praveen034u/SWAFarm/pcb-workflow.md

Requirements

↓

Schematic

↓

Assign Footprints

↓

Electrical Rule Check (ERC)

↓

PCB Layout

↓

Routing

↓

Design Rule Check (DRC)

↓

3D View

↓

Gerber Files

↓

Manufacturing

Things to Learn-
Symbol Library

Footprint Library

Properties

Wire Tool

Power Symbols

ERC

PCB Router

DRC
