praveen034u/SWAFarm/Hardware/SWAFarmNodeV1/report.txt

Info: Processing symbol 'CMC_RS485_1:Inductor_SMD:L_CommonModeChoke_Bourns_SRF1260'.
Info: Processing symbol 'CMC_RS485_2:Inductor_SMD:L_CommonModeChoke_Bourns_SRF1260'.
Info: Processing symbol 'C_BOOT1:Capacitor_SMD:C_0603_1608Metric'.
Info: Processing symbol 'C_BOOT2:Capacitor_SMD:C_0603_1608Metric'.
Info: Processing symbol 'C_BULK2:Capacitor_SMD:C_1206_3216Metric'.
Info: Processing symbol 'C_COMP1:Capacitor_SMD:C_0603_1608Metric'.
Info: Processing symbol 'C_DEC1:Capacitor_SMD:C_0603_1608Metric'.
Info: Processing symbol 'C_DEC2:Capacitor_SMD:C_0603_1608Metric'.
Info: Processing symbol 'C_DEC3:Capacitor_SMD:C_0603_1608Metric'.
Info: Processing symbol 'C_DEC4:Capacitor_SMD:C_0603_1608Metric'.
Info: Processing symbol 'C_DEC5:Capacitor_SMD:C_0603_1608Metric'.
Info: Processing symbol 'C_DEC6:Capacitor_SMD:C_0603_1608Metric'.
Info: Processing symbol 'C_DEC7:Capacitor_SMD:C_0603_1608Metric'.
Info: Processing symbol 'C_DEC8:Capacitor_SMD:C_0603_1608Metric'.
Info: Processing symbol 'C_DEC9:Capacitor_SMD:C_0603_1608Metric'.
Info: Processing symbol 'C_DEC10:Capacitor_SMD:C_0603_1608Metric'.
Info: Processing symbol 'C_DVDT1:Capacitor_SMD:C_0805_2012Metric'.
Info: Processing symbol 'C_EN1:Capacitor_SMD:C_0805_2012Metric'.
Info: Processing symbol 'C_FILT1:Capacitor_SMD:C_0603_1608Metric'.
Info: Processing symbol 'C_FILT2:Capacitor_SMD:C_0603_1608Metric'.
Info: Processing symbol 'C_FILT3:Capacitor_SMD:C_0603_1608Metric'.
Info: Processing symbol 'C_FILT4:Capacitor_SMD:C_0603_1608Metric'.
Info: Processing symbol 'C_FILT5:Capacitor_SMD:C_0603_1608Metric'.
Info: Processing symbol 'C_FILT6:Capacitor_SMD:C_0603_1608Metric'.
Info: Processing symbol 'C_IN1:Capacitor_SMD:C_1206_3216Metric'.
Info: Processing symbol 'C_IN2:Capacitor_SMD:C_1206_3216Metric'.
Info: Processing symbol 'C_IN3:Capacitor_SMD:C_1206_3216Metric'.
Info: Processing symbol 'C_ISOIN1:Capacitor_SMD:C_0603_1608Metric'.
Info: Processing symbol 'C_ISOOUT1:Capacitor_SMD:C_0603_1608Metric'.
Info: Processing symbol 'C_OUT1:Capacitor_SMD:C_1206_3216Metric'.
Info: Processing symbol 'C_OUT2:Capacitor_SMD:C_1206_3216Metric'.
Info: Processing symbol 'C_OUT3:Capacitor_SMD:C_1206_3216Metric'.
Info: Processing symbol 'C_SS1:Capacitor_SMD:C_0603_1608Metric'.
Info: Processing symbol 'C_VALVEBULK1:Capacitor_THT:CP_Radial_D12.5mm_P5.00mm'.
Info: Processing symbol 'C_VMDEC1:Capacitor_SMD:C_0805_2012Metric'.
Info: Processing symbol 'C_VMDEC2:Capacitor_SMD:C_0805_2012Metric'.
Info: Processing symbol 'C_VMDEC3:Capacitor_SMD:C_0805_2012Metric'.
Info: Processing symbol 'C_VMDEC4:Capacitor_SMD:C_0805_2012Metric'.
Info: Processing symbol 'C_VMDEC5:Capacitor_SMD:C_0805_2012Metric'.
Info: Processing symbol 'C_VMDEC6:Capacitor_SMD:C_0805_2012Metric'.
Info: Processing symbol 'D1:Diode_SMD:D_SMB'.
Info: Processing symbol 'D_CLHI1:Diode_SMD:D_SOD-123'.
Info: Processing symbol 'D_CLHI2:Diode_SMD:D_SOD-123'.
Info: Processing symbol 'D_CLHI3:Diode_SMD:D_SOD-123'.
Info: Processing symbol 'D_CLHI4:Diode_SMD:D_SOD-123'.
Info: Processing symbol 'D_CLHI5:Diode_SMD:D_SOD-123'.
Info: Processing symbol 'D_CLHI6:Diode_SMD:D_SOD-123'.
Info: Processing symbol 'D_CLLO1:Diode_SMD:D_SOD-123'.
Info: Processing symbol 'D_CLLO2:Diode_SMD:D_SOD-123'.
Info: Processing symbol 'D_CLLO3:Diode_SMD:D_SOD-123'.
Info: Processing symbol 'D_CLLO4:Diode_SMD:D_SOD-123'.
Info: Processing symbol 'D_CLLO5:Diode_SMD:D_SOD-123'.
Info: Processing symbol 'D_CLLO6:Diode_SMD:D_SOD-123'.
Info: Processing symbol 'D_FLT1:LED_SMD:LED_0805_2012Metric'.
Info: Processing symbol 'D_LED1:LED_SMD:LED_0805_2012Metric'.
Info: Processing symbol 'D_LED2:LED_SMD:LED_0805_2012Metric'.
Info: Processing symbol 'D_LINK1:LED_SMD:LED_0805_2012Metric'.
Info: Processing symbol 'D_PWR1:LED_SMD:LED_0805_2012Metric'.
Info: Processing symbol 'D_RS485PROT1:Package_TO_SOT_SMD:SOT-23'.
Info: Processing symbol 'D_RS485PROT2:Package_TO_SOT_SMD:SOT-23'.
Info: Processing symbol 'F1:Fuse:Fuse_1812_4532Metric'.
Info: Processing symbol 'J1:Connector_PinHeader_2.54mm:PinHeader_1x04_P2.54mm_Vertical'.
Info: Processing symbol 'J_LORASMA1:Connector_Coaxial:SMA_Amphenol_132134_Vertical'.
Info: Processing symbol 'J_OUT1:Connector_PinHeader_2.54mm:PinHeader_1x04_P2.54mm_Vertical'.
Info: Processing symbol 'J_PROG1:Connector_PinHeader_2.54mm:PinHeader_1x03_P2.54mm_Vertical'.
Info: Processing symbol 'J_RS485_IN1:Connector_PinHeader_2.54mm:PinHeader_1x05_P2.54mm_Vertical'.
Info: Processing symbol 'J_RS485_LOC1:Connector_PinHeader_2.54mm:PinHeader_1x05_P2.54mm_Vertical'.
Info: Processing symbol 'J_RS485_OUT1:Connector_PinHeader_2.54mm:PinHeader_1x05_P2.54mm_Vertical'.
Info: Processing symbol 'J_SENSOR_RET1:TerminalBlock_Phoenix:TerminalBlock_Phoenix_MKDS-1,5-6-5.08_1x06_P5.08mm_Horizontal'.
Info: Processing symbol 'J_SENSOR_SIG1:TerminalBlock_Phoenix:TerminalBlock_Phoenix_MKDS-1,5-6-5.08_1x06_P5.08mm_Horizontal'.
Info: Processing symbol 'J_USB1:Connector_USB:USB_C_Receptacle_HRO_TYPE-C-31-M-12'.
Info: Processing symbol 'J_VALVE_OUT1_1:TerminalBlock_Phoenix:TerminalBlock_Phoenix_MKDS-1,5-6-5.08_1x06_P5.08mm_Horizontal'.
Info: Processing symbol 'J_VALVE_OUT2_1:TerminalBlock_Phoenix:TerminalBlock_Phoenix_MKDS-1,5-6-5.08_1x06_P5.08mm_Horizontal'.
Info: Processing symbol 'L1:Inductor_SMD:L_Bourns-SRN6028'.
Info: Processing symbol 'L2:Inductor_SMD:L_Bourns-SRN4018'.
Info: Processing symbol 'Q1:Package_TO_SOT_SMD:SOT-23'.
Info: Processing symbol 'R_BIASA1:Resistor_SMD:R_0805_2012Metric'.
Info: Processing symbol 'R_BIASB1:Resistor_SMD:R_0805_2012Metric'.
Info: Processing symbol 'R_BOOT1:Resistor_SMD:R_0805_2012Metric'.
Info: Processing symbol 'R_BURDEN1:Resistor_SMD:R_0805_2012Metric'.
Info: Processing symbol 'R_BURDEN2:Resistor_SMD:R_0805_2012Metric'.
Info: Processing symbol 'R_BURDEN3:Resistor_SMD:R_0805_2012Metric'.
Info: Processing symbol 'R_BURDEN4:Resistor_SMD:R_0805_2012Metric'.
Info: Processing symbol 'R_BURDEN5:Resistor_SMD:R_0805_2012Metric'.
Info: Processing symbol 'R_BURDEN6:Resistor_SMD:R_0805_2012Metric'.
Info: Processing symbol 'R_CC1_1:Resistor_SMD:R_0805_2012Metric'.
Info: Processing symbol 'R_CC2_1:Resistor_SMD:R_0805_2012Metric'.
Info: Processing symbol 'R_COMP1:Resistor_SMD:R_0805_2012Metric'.
Info: Processing symbol 'R_EN1A1:Resistor_SMD:R_0805_2012Metric'.
Info: Processing symbol 'R_EN1B1:Resistor_SMD:R_0805_2012Metric'.
Info: Processing symbol 'R_EN2:Resistor_SMD:R_0805_2012Metric'.
Info: Processing symbol 'R_ENPU1:Resistor_SMD:R_0805_2012Metric'.
Info: Processing symbol 'R_EXPRST1:Resistor_SMD:R_0805_2012Metric'.
Info: Processing symbol 'R_FB1A1:Resistor_SMD:R_0805_2012Metric'.
Info: Processing symbol 'R_FB1B1:Resistor_SMD:R_0805_2012Metric'.
Info: Processing symbol 'R_FB2A1:Resistor_SMD:R_0805_2012Metric'.
Info: Processing symbol 'R_FB2B1:Resistor_SMD:R_0805_2012Metric'.
Info: Processing symbol 'R_FLT1:Resistor_SMD:R_0805_2012Metric'.
Info: Processing symbol 'R_gate1:Resistor_SMD:R_0805_2012Metric'.
Info: Processing symbol 'R_ILIM1:Resistor_SMD:R_0805_2012Metric'.
Info: Processing symbol 'R_ILIM_V1:Resistor_SMD:R_0805_2012Metric'.
Info: Processing symbol 'R_ILIM_V2:Resistor_SMD:R_0805_2012Metric'.
Info: Processing symbol 'R_ILIM_V3:Resistor_SMD:R_0805_2012Metric'.
Info: Processing symbol 'R_ILIM_V4:Resistor_SMD:R_0805_2012Metric'.
Info: Processing symbol 'R_ILIM_V5:Resistor_SMD:R_0805_2012Metric'.
Info: Processing symbol 'R_ILIM_V6:Resistor_SMD:R_0805_2012Metric'.
Info: Processing symbol 'R_IMON1:Resistor_SMD:R_0805_2012Metric'.
Info: Processing symbol 'R_LED1:Resistor_SMD:R_0805_2012Metric'.
Info: Processing symbol 'R_LED2:Resistor_SMD:R_0805_2012Metric'.
Info: Processing symbol 'R_LEDFLT1:Resistor_SMD:R_0805_2012Metric'.
Info: Processing symbol 'R_LINK1:Resistor_SMD:R_0805_2012Metric'.
Info: Processing symbol 'R_LORABOOT1:Resistor_SMD:R_0805_2012Metric'.
Info: Processing symbol 'R_LORARST1:Resistor_SMD:R_0805_2012Metric'.
Info: Processing symbol 'R_OVP1:Resistor_SMD:R_0805_2012Metric'.
Info: Processing symbol 'R_OVP2:Resistor_SMD:R_0805_2012Metric'.
Info: Processing symbol 'R_PG1:Resistor_SMD:R_0805_2012Metric'.
Info: Processing symbol 'R_PWR1:Resistor_SMD:R_0805_2012Metric'.
Info: Processing symbol 'R_RT1:Resistor_SMD:R_0805_2012Metric'.
Info: Processing symbol 'R_SER1:Resistor_SMD:R_0805_2012Metric'.
Info: Processing symbol 'R_SER2:Resistor_SMD:R_0805_2012Metric'.
Info: Processing symbol 'R_SER3:Resistor_SMD:R_0805_2012Metric'.
Info: Processing symbol 'R_SER4:Resistor_SMD:R_0805_2012Metric'.
Info: Processing symbol 'R_SER5:Resistor_SMD:R_0805_2012Metric'.
Info: Processing symbol 'R_SER6:Resistor_SMD:R_0805_2012Metric'.
Info: Processing symbol 'R_SETUP1:Resistor_SMD:R_0805_2012Metric'.
Info: Processing symbol 'R_SHDN1:Resistor_SMD:R_0805_2012Metric'.
Info: Processing symbol 'R_TERM1:Resistor_SMD:R_0805_2012Metric'.
Info: Processing symbol 'R_UVLO1:Resistor_SMD:R_0805_2012Metric'.
Info: Processing symbol 'R_UVLO2:Resistor_SMD:R_0805_2012Metric'.
Info: Processing symbol 'SW_BOOT1:Button_Switch_SMD:SW_SPST_B3U-1000P'.
Info: Processing symbol 'SW_RESET1:Button_Switch_SMD:SW_SPST_B3U-1000P'.
Info: Processing symbol 'SW_SETUP1:Button_Switch_SMD:SW_SPST_B3U-1000P'.
Info: Processing symbol 'TP_3V3:TestPoint:TestPoint_Pad_D1.5mm'.
Info: Processing symbol 'TP_5V1:TestPoint:TestPoint_Pad_D1.5mm'.
Info: Processing symbol 'TP_12V_SW1:TestPoint:TestPoint_Pad_D1.5mm'.
Info: Processing symbol 'TP_FLT1:TestPoint:TestPoint_Pad_D1.5mm'.
Info: Processing symbol 'TP_GND1:TestPoint:TestPoint_Pad_D1.5mm'.
Info: Processing symbol 'TP_IMON1:TestPoint:TestPoint_Pad_D1.5mm'.
Info: Processing symbol 'TP_ISO5V1:TestPoint:TestPoint_Pad_D1.5mm'.
Info: Processing symbol 'TP_ISOGND1:TestPoint:TestPoint_Pad_D1.5mm'.
Info: Processing symbol 'TP_LORABOOT1:TestPoint:TestPoint_Pad_D1.5mm'.
Info: Processing symbol 'TP_LORARST1:TestPoint:TestPoint_Pad_D1.5mm'.
Info: Processing symbol 'TP_PG1:TestPoint:TestPoint_Pad_D1.5mm'.
Info: Processing symbol 'TP_RS485DI1:TestPoint:TestPoint_Pad_D1.5mm'.
Info: Processing symbol 'TP_RS485RO1:TestPoint:TestPoint_Pad_D1.5mm'.
Info: Processing symbol 'TP_USBVBUS1:TestPoint:TestPoint_Pad_D1.5mm'.
Info: Processing symbol 'U1:Package_SO:HTSSOP-16-1EP_4.4x5mm_P0.65mm_EP3.4x5mm_Mask2.66x2.46mm_ThermalVias'.
Info: Processing symbol 'U2:Package_SON:WSON-10-1EP_4x4mm_P0.8mm_EP2.6x3mm_ThermalVias'.
Info: Processing symbol 'U3:Package_TO_SOT_SMD:SOT-23-6'.
Info: Processing symbol 'U_DRV1:Package_SO:TI_SO-PowerPAD-8_ThermalVias'.
Info: Processing symbol 'U_DRV2:Package_SO:TI_SO-PowerPAD-8_ThermalVias'.
Info: Processing symbol 'U_DRV3:Package_SO:TI_SO-PowerPAD-8_ThermalVias'.
Info: Processing symbol 'U_DRV4:Package_SO:TI_SO-PowerPAD-8_ThermalVias'.
Info: Processing symbol 'U_DRV5:Package_SO:TI_SO-PowerPAD-8_ThermalVias'.
Info: Processing symbol 'U_DRV6:Package_SO:TI_SO-PowerPAD-8_ThermalVias'.
Info: Processing symbol 'U_ISO1:Package_SO:SOIC-16W_7.5x10.3mm_P1.27mm'.
Info: Processing symbol 'U_ISODCDC1:Converter_DCDC:Converter_DCDC_Murata_MEE1SxxxxSC_THT'.
Info: Processing symbol 'U_LORA1:RF_Module:RAK3172'.
Info: Processing symbol 'U_MCU1:RF_Module:ESP32-S3-WROOM-1'.
Info: Processing symbol 'U_RS485_TX1:Package_SO:SOIC-8_3.9x4.9mm_P1.27mm'.
Info: Processing symbol 'U_VALVEEXP1:Package_SO:SOIC-28W_7.5x17.9mm_P1.27mm'.

Info: Total warnings: 0, errors: 0.
