praveen034u/SWAFarm/.ai/agent_index.md

Hardware Questions

↓

hardware_architect

↓

schematic_designer

↓

pcb_layout_reviewer

↓

manufacturing_engineer

Firmware

↓

firmware_architect

Testing

↓

testing_validation

RF

↓

rf_lorawan_expert
