praveen034u/SWAFarm/Documentation/images/SWAFarmNodeV1_3DCheck.png

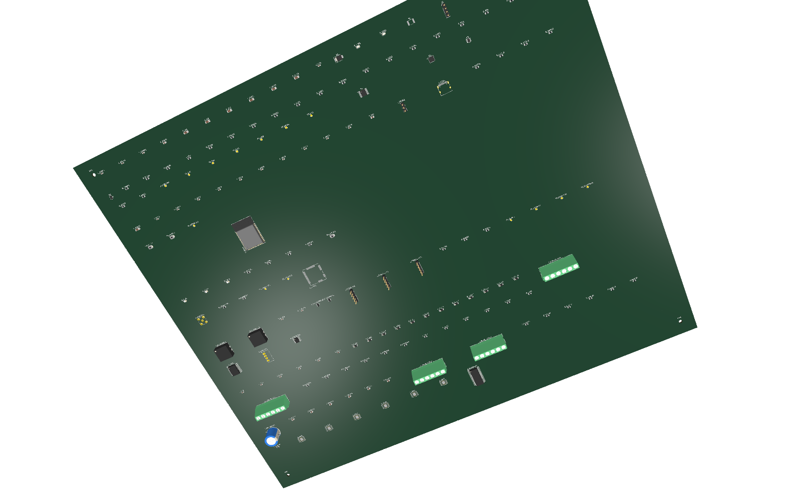
Documentation/images/SWAFarmNodeV1_3DCheck.png
