praveen034u/SWAFarm/Documentation/images/SWAFarmNodeV1_09PCB_TopView_Placement.png

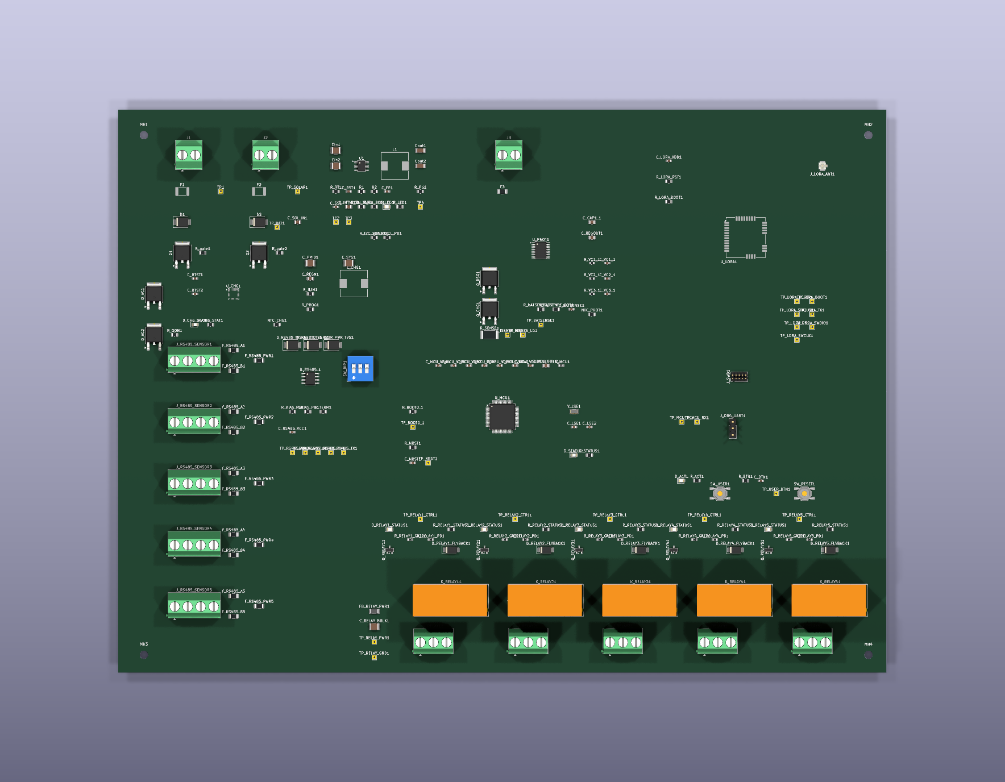
Documentation/images/SWAFarmNodeV1_09PCB_TopView_Placement.png
