praveen034u/SWAFarm/Documentation/images/SWAFarmNodeV1_NodeCore_08PCB_TopView.png

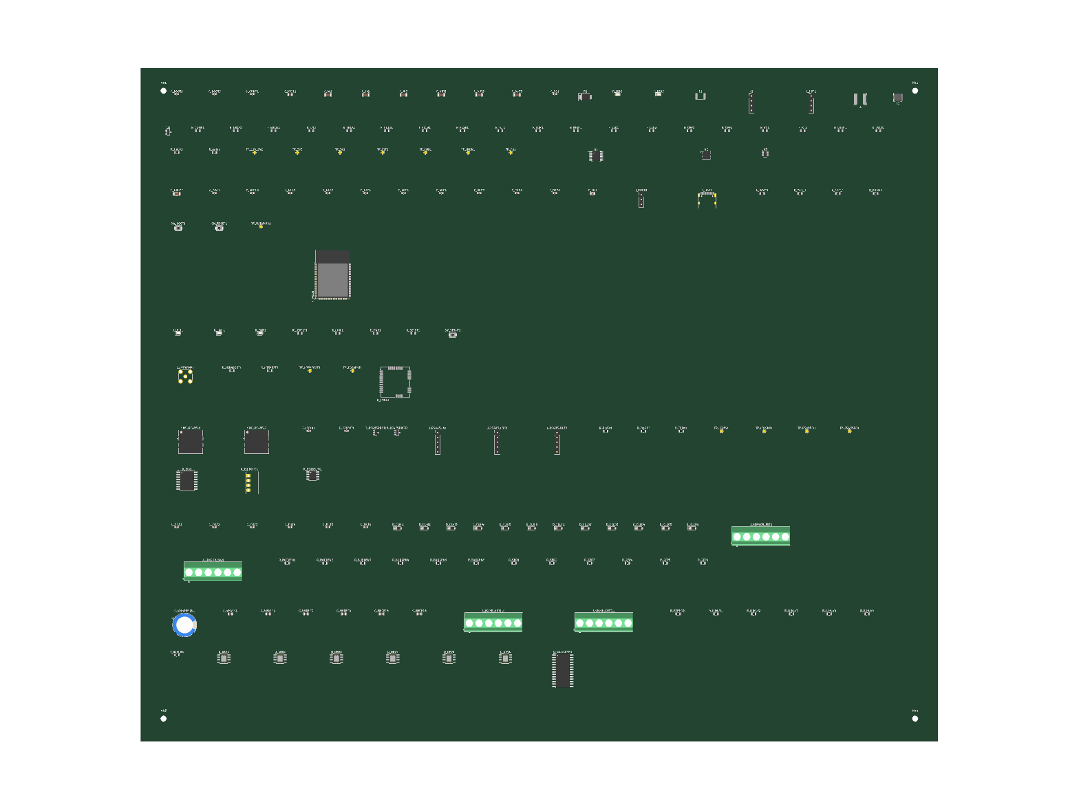
Documentation/images/SWAFarmNodeV1_NodeCore_08PCB_TopView.png
