praveen034u/SWAFarm/NodeForRefrence.xlsx

Sheet: Netlist_Seed
record_id | board_id | sheet_block | net_name | signal_direction | signal_source_component_id | source_refdes_hint | source_pin | signal_destination_component_id | destination_refdes_hint | destination_pin | connector_id | connector_pin | label_on_silkscreen | resistor_required | resistor_component_id | resistor_value_ohm | protection_required | protection_component_ids | power_circuit_stage | power_rail | required | design_status | verification_test | notes
HUB_PWR_001 | HUB_CORE | POWER_INPUT | HUB_12V_IN | in | CMP_CONN_M12A_4P_PWR12_PANEL | J_PWR_IN | Pin1 | POWER_CHAIN | U_PROT_IN | IN | CONN_M12A_4P_PWR12 | Pin1 | +12V_IN | FALSE |  |  | TRUE | CMP_INPUT_FUSE_PTC|CMP_INPUT_TVS|CMP_POLARITY_PROTECT|CMP_EFUSE_UVLO_OVP | Input protection | 12V | TRUE | LOCKED | TC-HW-001 | 12V enters via M12 power connector.
HUB_PWR_002 | HUB_CORE | POWER_INPUT | HUB_GND | in | CMP_CONN_M12A_4P_PWR12_PANEL | J_PWR_IN | Pin2 | SYSTEM_GND | GNDP | 0V | CONN_M12A_4P_PWR12 | Pin2 | GND | FALSE |  |  | TRUE | CMP_INPUT_TVS | Ground return | 0V | TRUE | LOCKED | TC-HW-001 | Power return.
HUB_PWR_003 | HUB_CORE | POWER_INPUT | HUB_PE_CHASSIS | in | CMP_CONN_M12A_4P_PWR12_PANEL | J_PWR_IN | Pin3 | CHASSIS | CHASSIS | CHASSIS | CONN_M12A_4P_PWR12 | Pin3 | PE_CHASSIS | FALSE |  |  | FALSE |  | Chassis bonding | CHASSIS | TRUE | PROVISIONAL | TC-HW-001 | Use for surge/chassis strategy as needed.
HUB_PWR_004 | HUB_CORE | POWER_INPUT | HUB_PWR_SPARE | na | CMP_CONN_M12A_4P_PWR12_PANEL | J_PWR_IN | Pin4 | NA | NA | NA | CONN_M12A_4P_PWR12 | Pin4 | SPARE | FALSE |  |  | FALSE |  | Reserved | NA | FALSE | LOCKED | TC-HW-001 | Reserved no-connect.
HUB_PWR_005 | HUB_CORE | POWER_CHAIN | HUB_12V_PROTECTED | out | CMP_EFUSE_UVLO_OVP | U_EFUSE | OUT | CMP_REGULATOR_12V_TO_5V | U_BUCK12_5 | VIN | NA | NA | 12V_PROT | FALSE |  |  | TRUE | CMP_INPUT_FUSE_PTC|CMP_INPUT_TVS|CMP_POLARITY_PROTECT|CMP_EFUSE_UVLO_OVP | Power conditioning | 12V | TRUE | LOCKED | TC-HW-001 | Main protected rail.
HUB_PWR_006 | HUB_CORE | POWER_CHAIN | HUB_5V | out | CMP_REGULATOR_12V_TO_5V | U_BUCK12_5 | VOUT | CMP_REGULATOR_5V_TO_3V3 | U_LDO5_3V3 | VIN | NA | NA | 5V | FALSE |  |  | FALSE |  | Buck stage | 5V | TRUE | LOCKED | TC-HW-001 | 5V intermediate rail.
HUB_PWR_007 | HUB_CORE | POWER_CHAIN | HUB_3V3 | out | CMP_REGULATOR_5V_TO_3V3 | U_LDO5_3V3 | VOUT | CMP_MCU_ESP32S3 | U_MCU | VDD | NA | NA | 3V3 | FALSE |  |  | FALSE |  | Regulated rail | 3V3 | TRUE | LOCKED | TC-HW-001 | Digital rail.
HUB_RS485_001 | HUB_CORE | RS485 | HUB_RS485_A_IN | in | CMP_CONN_M12A_5P_RS485_PANEL | J_RS485_IN | Pin2 | CMP_RS485_LINE_PROTECT | U_RS485_PROT_IN | A | CONN_M12A_5P_RS485 | Pin2 | RS485_A_IN | TRUE | CMP_RS485_TERM_SELECT | 120 | TRUE | CMP_RS485_LINE_PROTECT|CMP_RS485_ISOLATOR|CMP_RS485_ISO_DCDC | Bus input | RS485 | TRUE | LOCKED | TC-HW-004 | Pin map provisional: Pin1 GND Pin2 A Pin3 B Pin4 NC Pin5 SHIELD.
HUB_RS485_002 | HUB_CORE | RS485 | HUB_RS485_B_IN | in | CMP_CONN_M12A_5P_RS485_PANEL | J_RS485_IN | Pin3 | CMP_RS485_LINE_PROTECT | U_RS485_PROT_IN | B | CONN_M12A_5P_RS485 | Pin3 | RS485_B_IN | TRUE | CMP_RS485_BIAS_NET | 680 | TRUE | CMP_RS485_LINE_PROTECT|CMP_RS485_ISOLATOR|CMP_RS485_ISO_DCDC | Bus input | RS485 | TRUE | LOCKED | TC-HW-004 | Bias network required.
HUB_RS485_003 | HUB_CORE | RS485 | HUB_RS485_GND | in | CMP_CONN_M12A_5P_RS485_PANEL | J_RS485_IN | Pin1 | SYSTEM_GND | GNDP | 0V | CONN_M12A_5P_RS485 | Pin1 | RS485_GND | FALSE |  |  | TRUE | CMP_RS485_CMC | Reference | 0V | TRUE | LOCKED | TC-HW-004 | Bus reference.
HUB_RS485_004 | HUB_CORE | RS485 | HUB_RS485_A_OUT | out | CMP_RS485_TRANSCEIVER | U_RS485_TX | RXTX_A | CMP_CONN_M12A_5P_RS485_PANEL | J_RS485_OUT | Pin2 | CONN_M12A_5P_RS485 | Pin2 | RS485_A_OUT | FALSE |  |  | TRUE | CMP_RS485_LINE_PROTECT | Bus output | RS485 | TRUE | LOCKED | TC-HW-004 | Daisy chain downstream.
HUB_RS485_005 | HUB_CORE | RS485 | HUB_RS485_B_OUT | out | CMP_RS485_TRANSCEIVER | U_RS485_TX | RXTX_B | CMP_CONN_M12A_5P_RS485_PANEL | J_RS485_OUT | Pin3 | CONN_M12A_5P_RS485 | Pin3 | RS485_B_OUT | FALSE |  |  | TRUE | CMP_RS485_LINE_PROTECT | Bus output | RS485 | TRUE | LOCKED | TC-HW-004 | Daisy chain downstream.
HUB_RS485_006 | HUB_CORE | RS485 | HUB_RS485_SHIELD | na | CMP_CONN_M12A_5P_RS485_PANEL | J_RS485_IN | Pin5 | CHASSIS | CHASSIS | CHASSIS | CONN_M12A_5P_RS485 | Pin5 | RS485_SHIELD | FALSE |  |  | TRUE | CMP_RS485_CMC | EMI path | CHASSIS | TRUE | PROVISIONAL | TC-HW-004 | Shield termination strategy by PCB review.
HUB_SENSOR_001 | HUB_CORE | SENSOR | HUB_SENS_CH1_SIG | in | CMP_CONN_TERM_6CH_SENSOR | J_SENSOR | CH1_SIG | CMP_SENSOR_FRONTEND_UNIVERSAL | U_AFE | CH1_IN | CONN_TERM_6CH_SENSOR | CH1_SIG | SENS1_SIG | FALSE |  |  | TRUE | CMP_ESD_ARRAY | Sensor frontend | SENSOR | TRUE | LOCKED | TC-HW-002 | Supports DI/Pulse/0-10V/4-20mA per firmware config.
HUB_SENSOR_002 | HUB_CORE | SENSOR | HUB_SENS_CH1_RET | in | CMP_CONN_TERM_6CH_SENSOR | J_SENSOR | CH1_RET | CMP_SENSOR_FRONTEND_UNIVERSAL | U_AFE | CH1_RET | CONN_TERM_6CH_SENSOR | CH1_RET | SENS1_RET | FALSE |  |  | TRUE | CMP_ESD_ARRAY | Sensor frontend | SENSOR | TRUE | LOCKED | TC-HW-002 | Return/reference.
HUB_SENSOR_003 | HUB_CORE | SENSOR | HUB_SENS_CH2_SIG | in | CMP_CONN_TERM_6CH_SENSOR | J_SENSOR | CH2_SIG | CMP_SENSOR_FRONTEND_UNIVERSAL | U_AFE | CH2_IN | CONN_TERM_6CH_SENSOR | CH2_SIG | SENS2_SIG | FALSE |  |  | TRUE | CMP_ESD_ARRAY | Sensor frontend | SENSOR | TRUE | LOCKED | TC-HW-002 | Channel 2 input.
HUB_SENSOR_004 | HUB_CORE | SENSOR | HUB_SENS_CH2_RET | in | CMP_CONN_TERM_6CH_SENSOR | J_SENSOR | CH2_RET | CMP_SENSOR_FRONTEND_UNIVERSAL | U_AFE | CH2_RET | CONN_TERM_6CH_SENSOR | CH2_RET | SENS2_RET | FALSE |  |  | TRUE | CMP_ESD_ARRAY | Sensor frontend | SENSOR | TRUE | LOCKED | TC-HW-002 | Channel 2 return.
HUB_SENSOR_005 | HUB_CORE | SENSOR | HUB_SENS_CH3_SIG | in | CMP_CONN_TERM_6CH_SENSOR | J_SENSOR | CH3_SIG | CMP_SENSOR_FRONTEND_UNIVERSAL | U_AFE | CH3_IN | CONN_TERM_6CH_SENSOR | CH3_SIG | SENS3_SIG | FALSE |  |  | TRUE | CMP_ESD_ARRAY | Sensor frontend | SENSOR | TRUE | LOCKED | TC-HW-002 | Channel 3 input.
HUB_SENSOR_006 | HUB_CORE | SENSOR | HUB_SENS_CH3_RET | in | CMP_CONN_TERM_6CH_SENSOR | J_SENSOR | CH3_RET | CMP_SENSOR_FRONTEND_UNIVERSAL | U_AFE | CH3_RET | CONN_TERM_6CH_SENSOR | CH3_RET | SENS3_RET | FALSE |  |  | TRUE | CMP_ESD_ARRAY | Sensor frontend | SENSOR | TRUE | LOCKED | TC-HW-002 | Channel 3 return.
HUB_SENSOR_007 | HUB_CORE | SENSOR | HUB_SENS_CH4_SIG | in | CMP_CONN_TERM_6CH_SENSOR | J_SENSOR | CH4_SIG | CMP_SENSOR_FRONTEND_UNIVERSAL | U_AFE | CH4_IN | CONN_TERM_6CH_SENSOR | CH4_SIG | SENS4_SIG | FALSE |  |  | TRUE | CMP_ESD_ARRAY | Sensor frontend | SENSOR | TRUE | LOCKED | TC-HW-002 | Channel 4 input.
HUB_SENSOR_008 | HUB_CORE | SENSOR | HUB_SENS_CH4_RET | in | CMP_CONN_TERM_6CH_SENSOR | J_SENSOR | CH4_RET | CMP_SENSOR_FRONTEND_UNIVERSAL | U_AFE | CH4_RET | CONN_TERM_6CH_SENSOR | CH4_RET | SENS4_RET | FALSE |  |  | TRUE | CMP_ESD_ARRAY | Sensor frontend | SENSOR | TRUE | LOCKED | TC-HW-002 | Channel 4 return.
HUB_SENSOR_009 | HUB_CORE | SENSOR | HUB_SENS_CH5_SIG | in | CMP_CONN_TERM_6CH_SENSOR | J_SENSOR | CH5_SIG | CMP_SENSOR_FRONTEND_UNIVERSAL | U_AFE | CH5_IN | CONN_TERM_6CH_SENSOR | CH5_SIG | SENS5_SIG | FALSE |  |  | TRUE | CMP_ESD_ARRAY | Sensor frontend | SENSOR | TRUE | LOCKED | TC-HW-002 | Channel 5 input.
HUB_SENSOR_010 | HUB_CORE | SENSOR | HUB_SENS_CH5_RET | in | CMP_CONN_TERM_6CH_SENSOR | J_SENSOR | CH5_RET | CMP_SENSOR_FRONTEND_UNIVERSAL | U_AFE | CH5_RET | CONN_TERM_6CH_SENSOR | CH5_RET | SENS5_RET | FALSE |  |  | TRUE | CMP_ESD_ARRAY | Sensor frontend | SENSOR | TRUE | LOCKED | TC-HW-002 | Channel 5 return.

Sheet: BOM
device_id | component_id | category | description | selection_notes | sourcing_india | sourcing_us | cost_class | criticality | quantity | lifecycle_status | manufacturer | mpn | india_alt_mfr_pn | india_alt_mfr | india_sourcing_note
NODE_CORE | CMP_MCU_ESP32S3 | MCU | Primary MCU with integrated Wi-Fi and BLE radios | Use MCU variant with stable supply in India and long-term availability; Wi-Fi and BLE are integrated in this component. | Mouser India; element14 India; local authorized distributor | Mouser US; Digi-Key US; Arrow US | high | mandatory | 1 | approved | Espressif | ESP32-S3-WROOM-1-N16R8 |  |  | Order via Espressif India / Mouser India / DigiKey India; module sourced directly from Espressif or authorized distributor
NODE_CORE | CMP_RS485_TRANSCEIVER | COMMUNICATION | RS-485 transceiver | Prefer half-duplex 3.3V transceiver with ESD robustness and fail-safe receiver for long cable runs. | Mouser India; element14 India; local authorized distributor | Mouser US; Digi-Key US; Arrow US | medium | mandatory | 2 | approved | Texas Instruments | THVD1450DR
NODE_CORE | CMP_REGULATOR_12V_TO_5V | POWER | Primary buck regulator | Prefer automotive/industrial-grade buck with wide input tolerance, low heat, and short-circuit protection. | Mouser India; element14 India; local authorized distributor | Mouser US; Digi-Key US; Arrow US | medium | mandatory | 1 | approved | Texas Instruments | TPS54531DDAR |  |  | Monolithic Power / TI buck converters via Mouser India; verify package availability
NODE_CORE | CMP_REGULATOR_5V_TO_3V3 | POWER | Secondary 3.3V step-down (buck) regulator | Switching buck for thermal/brownout headroom under 4G TX bursts; needs 2.2uH inductor + feedback divider (add at schematic capture). | Mouser India; element14 India; local authorized distributor | Mouser US; Digi-Key US; Arrow US | medium | mandatory | 1 | approved | Texas Instruments | TPS563201DDCR |  |  | TPS563201/TPS562201 stocked by Sharvi Electronics (Bangalore) & Mouser India; MP2315/MP1584 buck options common on SP Road. Buck requires 2.2uH L + FB divider.
NODE_CORE | CMP_SENSOR_FRONTEND_UNIVERSAL | ANALOG_FRONTEND | 6-ch universal input conditioning network (per channel: 0-10V divider + RC filter + DI/pulse pull-up) | Discrete per-channel network - see SENSOR_FRONTEND_SPEC.md. Mode-select jumper picks 0-10V / 4-20mA / DI / pulse. Feeds ESP32-S3 ADC1. Divider/filter passives placed at schematic capture. | Mouser India; element14 India; local authorized distributor | Mouser US; Digi-Key US; Arrow US | medium | mandatory | 6 | approved | SWAFarms | SWA-AFE-UNI-6CH (discrete network) |  |  | Built from standard R/C; see SENSOR_FRONTEND_SPEC.md.
NODE_CORE | CMP_VALVE_DRIVER_CH | DRIVER | Full H-bridge valve driver (universal: latching + standard solenoids) | TI DRV8871 3.6A full H-bridge, 1 per valve (6/board). Bipolar drive: reverse-polarity pulse for latching solenoids (~2.5A/150ms), continuous for standard. Integrated freewheeling diodes + internal current limit + thermal shutdown. IN1/IN2 driven via SPI I/O expander. | Mouser India; element14 India; local authorized distributor | Mouser US; Digi-Key US; Arrow US | medium | mandatory | 6 | approved | Texas Instruments | DRV8871DDAR |  |  | DRV8871DDAR stocked by Mouser India / element14 / Robu.in; SOIC-8 PowerPAD.
NODE_CORE | CMP_ESD_ARRAY | PROTECTION | ESD protection array for external ports | Select low-capacitance, IEC-rated ESD array matched to exposed interface voltage levels. | Mouser India; element14 India; local authorized distributor | Mouser US; Digi-Key US; Arrow US | low | mandatory | 4 | approved | Nexperia | PESD2CANFD24VTQ
NODE_CORE | CMP_SURGE_PROTECTOR | PROTECTION | Power surge and transient protection stage | Prefer TVS/MOV network sized for field transients and long cable environments. | Mouser India; element14 India; local authorized distributor | Mouser US; Digi-Key US; Arrow US | low | mandatory | 1 | approved | Littelfuse | SMAJ24A
NODE_CORE | CMP_INPUT_FUSE_PTC | PROTECTION | Input fuse or resettable PTC stage for fault current limiting | Size for worst-case inrush and field wiring faults while avoiding nuisance trips. | Mouser India; element14 India; local authorized distributor | Mouser US; Digi-Key US; Arrow US | low | mandatory | 1 | approved | Bourns | MF-R110 |  |  | Bourns/TE PTC fuses available via Mouser India or local distributors like Arrow India
NODE_CORE | CMP_INPUT_TVS | PROTECTION | Input TVS clamp for surge and lightning transient suppression | Use automotive/industrial TVS sized for 12V systems and farm-line surge energy. | Mouser India; element14 India; local authorized distributor | Mouser US; Digi-Key US; Arrow US | low | mandatory | 1 | approved | Littelfuse | SMBJ24A |  |  | Vishay/Littelfuse TVS available via Mouser India, DigiKey India, or local component shops in Bangalore
NODE_CORE | CMP_POLARITY_PROTECT | PROTECTION | Reverse-polarity protection stage on field power input | Prefer low-loss ideal-diode MOSFET topology over diode-only schemes for thermal margin. | Mouser India; element14 India; local authorized distributor | Mouser US; Digi-Key US; Arrow US | low | mandatory | 1 | approved | Infineon | IPD50N06S4L-16
NODE_CORE | CMP_EFUSE_UVLO_OVP | PROTECTION | eFuse or protection controller with UVLO and OVP cutoff | Target stable behavior during solar/generator fluctuations and repeated brownout events. | Mouser India; element14 India; local authorized distributor | Mouser US; Digi-Key US; Arrow US | medium | mandatory | 1 | approved | Texas Instruments | TPS26600PWPR |  |  | Texas Instruments eFuse ICs available via Mouser India or Arrow India
NODE_CORE | CMP_RS485_LINE_PROTECT | PROTECTION | RS485 line surge and ESD protection network | Use dedicated RS485 protector with low capacitance and high surge capability near connector entry. | Mouser India; element14 India; local authorized distributor | Mouser US; Digi-Key US; Arrow US | low | mandatory | 2 | approved | Littelfuse | SM712-02HTG
NODE_CORE | CMP_RS485_ISOLATOR | COMMUNICATION | Galvanic isolation stage for RS485 interface robustness | Prioritize for Motor Controller and long-cable links where ground potential differences are common. | Mouser India; element14 India; local authorized distributor | Mouser US; Digi-Key US; Arrow US | medium | mandatory | 1 | approved | Texas Instruments | ISO1410BDWR
NODE_CORE | CMP_RS485_ISO_DCDC | COMMUNICATION | Isolated DC-DC supply for RS485 isolated interface domain | Required companion for isolated RS485 designs; prefer compact low-cost isolated power module or controller stage. | Mouser India; element14 India; local authorized distributor | Mouser US; Digi-Key US; Arrow US | medium | mandatory | 1 | approved | Murata | NXE1S0505MC
NODE_CORE | CMP_RS485_TERM_SELECT | COMMUNICATION | Selectable RS485 termination network | Use jumper or solder-select termination so end-of-line nodes can be configured without PCB changes. | Mouser India; element14 India; local authorized distributor | Mouser US; Digi-Key US; Arrow US | low | mandatory | 2 | approved | Vishay | CRCW0603120RFKEA
NODE_CORE | CMP_RS485_BIAS_NET | COMMUNICATION | RS485 fail-safe bias resistor network | Provide stable idle bus level on long field cables; size for noise immunity with acceptable current draw. | Mouser India; element14 India; local authorized distributor | Mouser US; Digi-Key US; Arrow US | low | mandatory | 2 | approved | Vishay | CRCW0603680RFKEA |  |  | Vishay/Yageo resistors via Mouser India; generic resistors at SP Road Bangalore
NODE_CORE | CMP_RS485_CMC | COMMUNICATION | RS485 common-mode choke or ferrite filtering stage | Helps suppress cable-borne noise from motors and long runs with low incremental BOM cost. | Mouser India; element14 India; local authorized distributor | Mouser US; Digi-Key US; Arrow US | low | mandatory | 2 | approved | Wurth Elektronik | 744232090
NODE_CORE | CMP_CONN_M12A_5P_RS485_PANEL | CONNECTOR | M12 A-coded 5-pin panel connector for RS485 bus ports | Use keyed, sealed field connector; assign only to RS485 ports so it cannot be confused with sensor or valve terminals. | Mouser India; element14 India; local authorized distributor | Mouser US; Digi-Key US; Arrow US | medium | mandatory | 3 | approved | TE Connectivity | T4141412051-000 |  |  | M12 circular connectors: Belden / Phoenix Contact available via Mouser India or Radel India
NODE_CORE | CMP_CONN_M12A_4P_PWR12_PANEL | CONNECTOR | M12 A-coded 4-pin panel connector for 12V power ports | Use only for 12V power IN/OUT and keep physically separated from RS485 to prevent miswire damage. | Mouser India; element14 India; local authorized distributor | Mouser US; Digi-Key US; Arrow US | medium | mandatory | 2 | approved | TE Connectivity | T4141412041-000 |  |  | M12 circular connectors: Belden / Phoenix Contact available via Mouser India or Radel India
NODE_CORE | CMP_CONN_TERM_6CH_SENSOR | CONNECTOR | Sensor input terminal - 2x 6-pole blocks = 12 poles (6x CHx_SIG + shared +12V loop supply + GND) | Dedicated to sensor inputs only (DI/Pulse/0-10V/4-20mA); do not share footprint with valve terminal connector. | Mouser India; element14 India; local authorized distributor | Mouser US; Digi-Key US; Arrow US | low | mandatory | 2 | approved | Phoenix Contact | 1840409 |  |  | Use 2x the approved 6-pole block (1840409) to carry 6 signals + loop supply + GND.
NODE_CORE | CMP_CONN_TERM_6CH_VALVE | CONNECTOR | Pluggable valve terminal - 2x 6-position blocks = 12 poles (6 independent valve pairs for H-bridge/latching drive) | Dedicated to valve outputs only; keep separate connector group from sensors for fool-proof field wiring. | Mouser India; element14 India; local authorized distributor | Mouser US; Digi-Key US; Arrow US | low | mandatory | 2 | approved | Phoenix Contact | 1840412 |  |  | Use 2x the already-approved 6-pos block (mpn 1840412) to make 12 poles; avoids new connector qualification.
NODE_CORE | CMP_CONN_SMA_BULKHEAD | CONNECTOR | SMA bulkhead RF connector | Use weather-capable SMA bulkhead where external LoRa antenna connection is required. | Mouser India; element14 India; local authorized distributor | Mouser US; Digi-Key US; Arrow US | low | recommended | 1 | approved | Amphenol RF | 132134
NODE_CORE | CMP_VALVE_LINE_CLAMP | PROTECTION | Per-channel valve line clamp for inductive and surge stress reduction | Place close to output stage or connector to reduce surge energy reaching control electronics. | Mouser India; element14 India; local authorized distributor | Mouser US; Digi-Key US; Arrow US | low | mandatory | 6 | approved | Littelfuse | SMBJ33A
NODE_CORE | CMP_VALVE_FLYBACK_DIODE_CH | PROTECTION | Per-channel flyback diode for valve coil energy dissipation (DNP - freewheeling integrated in DRV8871 H-bridge) | Mandatory on each valve channel to protect switch and reduce EMI at coil turn-off. | Mouser India; element14 India; local authorized distributor | Mouser US; Digi-Key US; Arrow US | low | mandatory | 6 | approved | onsemi | ES1D
NODE_CORE | CMP_VALVE_GATE_NETWORK_CH | DRIVER | Per-channel gate resistor and pull network for valve driver MOSFET (DNP - gate drive integrated in DRV8871 H-bridge) | Stabilizes switching behavior and reduces false turn-on in high-noise field wiring conditions. | Mouser India; element14 India; local authorized distributor | Mouser US; Digi-Key US; Arrow US | low | mandatory | 6 | approved | Yageo | RC0603FR-07100RL |  |  | Vishay/Yageo resistors via Mouser India; generic resistors at SP Road Bangalore
NODE_CORE | CMP_VALVE_CURRENT_SENSE_CH | DRIVER | Per-channel valve current sense element | Optional but recommended for diagnostics like open-coil/short detection and predictive maintenance analytics. | Mouser India; element14 India; local authorized distributor | Mouser US; Digi-Key US; Arrow US | low | optional | 6 | approved | Bourns | CSS2H-2512R-L100F
NODE_CORE | CMP_LED_PWR | UI_INDICATOR | Power status LED indicator | Low-current LED (around 1-2 mA) with common footprint shared across all indicator LEDs for cost control. | Mouser India; element14 India; local authorized distributor | Mouser US; Digi-Key US; Arrow US | low | mandatory | 1 | approved | Kingbright | APT1608QBC-D |  |  | Standard LEDs widely available at SP Road Bangalore; Vishay/Wurth from Mouser India for spec-grade
NODE_CORE | CMP_LED_LINK | UI_INDICATOR | Communication link LED indicator (RS485, cloud, or LoRa activity) | Shared LED package family; color can be selected by stuffing while keeping one PCB footprint. | Mouser India; element14 India; local authorized distributor | Mouser US; Digi-Key US; Arrow US | low | mandatory | 1 | approved | Kingbright | APT1608SYCK |  |  | Standard LEDs widely available at SP Road Bangalore; Vishay/Wurth from Mouser India for spec-grade
NODE_CORE | CMP_LED_RESISTOR_NET | UI_INDICATOR | LED current-limiting resistor network | Dimension for low-brightness outdoor readability and low power draw; one resistor path per LED channel. | Mouser India; element14 India; local authorized distributor | Mouser US; Digi-Key US; Arrow US | low | mandatory | 2 | approved | Yageo | RC0603FR-071KL |  |  | Vishay/Yageo resistors via Mouser India; generic resistors at SP Road Bangalore
NODE_CORE | CMP_BT_RADIO_INTEGRATED | RF | Bluetooth LE radio included in MCU platform (reference component) | Reference-only line item to indicate BLE is integrated into MCU; no separate BOM silicon required. | Mouser India; element14 India; local authorized distributor | Mouser US; Digi-Key US; Arrow US | medium | mandatory | 1 | approved | Integrated | Integrated
NODE_CORE | CMP_VALVE_HBRIDGE_SPI_EXPANDER | DRIVER | SPI 16-bit I/O expander generating the 12 H-bridge control lines (IN1/IN2) for the 6 valve drivers | MCP23S17 SPI expander: one SPI bus drives all valves, frees MCU GPIO. 2 spare bits. | Mouser India; element14 India; local authorized distributor | Mouser US; Digi-Key US; Arrow US | low | mandatory | 1 | approved | Microchip | MCP23S17-E/SS |  |  | Widely stocked in India (Robu, element14)
NODE_CORE | CMP_VALVE_PULSE_BULK_CAP | POWER | Bulk reservoir capacitor supplying the latching-solenoid pulse current (~2.5A, ~150ms) | 1000uF 25V low-ESR aluminum electrolytic placed next to the valve H-bridges. | Mouser India; element14 India; local authorized distributor | Mouser US; Digi-Key US; Arrow US | low | mandatory | 1 | approved | Panasonic | EEU-FR1E102 |  |  | Electrolytics widely available across India
NODE_CORE | CMP_SENSOR_BURDEN_R | SENSOR | 4-20mA burden/sense resistor, 150ohm 0.1% (0.6-3.0V at 4-20mA) | Precision burden for 4-20mA mode; 1 per channel (populated on current-mode channels). | Mouser India; element14 India; local authorized distributor | Mouser US; Digi-Key US; Arrow US | low | mandatory | 6 | approved | Yageo | RT0805BRD07150RL |  |  | Precision 0.1% resistors via Mouser India / element14.
NODE_CORE | CMP_SENSOR_INPUT_PROTECT | PROTECTION | Per-channel ADC input clamp (BAV99 dual diode to 3V3/GND) with series protection resistor | Clamps ADC pin to rails on over-range/mis-wire; pairs with 100ohm series R and connector TVS. | Mouser India; element14 India; local authorized distributor | Mouser US; Digi-Key US; Arrow US | low | mandatory | 6 | approved | onsemi | BAV99LT1G |  |  | Jellybean part, widely stocked in India.
NODE_CORE | CMP_SENSOR_MODE_SELECT | SENSOR | Per-channel input mode-select jumper (1x3 header + shunt): V / I / D positions | Field-configurable per channel so installer picks 0-10V, 4-20mA or DI/pulse. | Mouser India; element14 India; local authorized distributor | Mouser US; Digi-Key US; Arrow US | low | mandatory | 6 | approved | Wurth Elektronik | 61300311121 |  |  | Standard 2.54mm headers everywhere in India.
NODE_CORE | CMP_BUCK_IND_10UH | POWER | Power inductor 10uH for 12V->5V buck (TPS54531) | Sized ~10uH, >=6A sat / low DCR; verify against TPS54531 design at chosen fsw. | Mouser India; element14 India; local authorized distributor | Mouser US; Digi-Key US; Arrow US | low | mandatory | 1 | approved | Wurth Elektronik | 74437368100 |  |  | Wurth/Bourns power inductors via Mouser India / element14.
NODE_CORE | CMP_BUCK_IND_2UH2 | POWER | Power inductor 2.2uH for 5V->3V3 buck (and 5V->3.8V modem buck on HUB) (TPS563201) | 2.2uH, >=4A sat; HUB uses 2 (3V3 + modem buck), NODE/MC use 1. | Mouser India; element14 India; local authorized distributor | Mouser US; Digi-Key US; Arrow US | low | mandatory | 1 | approved | Wurth Elektronik | 74438335022 |  |  | Wurth/Bourns 2.2uH via Mouser India / element14.

Sheet: Device_Allocation
device_id | component_id | category | description | selection_notes | sourcing_india | sourcing_us | cost_class | criticality | quantity | lifecycle_status | manufacturer | mpn
HUB_CORE | CMP_MCU_ESP32S3 | MCU | Primary MCU with integrated Wi-Fi and BLE radios | Use MCU variant with stable supply in India and long-term availability; Wi-Fi and BLE are integrated in this component. | Mouser India; element14 India; local authorized distributor | Mouser US; Digi-Key US; Arrow US | high | mandatory | 1 | candidate | Espressif | ESP32-S3-WROOM-1-N16R8
HUB_CORE | CMP_RS485_TRANSCEIVER | COMMUNICATION | RS-485 transceiver | Prefer half-duplex 3.3V transceiver with ESD robustness and fail-safe receiver for long cable runs. | Mouser India; element14 India; local authorized distributor | Mouser US; Digi-Key US; Arrow US | medium | mandatory | 1 | candidate | Texas Instruments | THVD1450DR
HUB_CORE | CMP_REGULATOR_12V_TO_5V | POWER | Primary buck regulator | Prefer automotive/industrial-grade buck with wide input tolerance, low heat, and short-circuit protection. | Mouser India; element14 India; local authorized distributor | Mouser US; Digi-Key US; Arrow US | medium | mandatory | 1 | candidate | Texas Instruments | TPS54531DDAR
HUB_CORE | CMP_REGULATOR_5V_TO_3V3 | POWER | Secondary 3.3V regulator | Choose low-noise regulator with sufficient current margin for RF peaks and sensors. | Mouser India; element14 India; local authorized distributor | Mouser US; Digi-Key US; Arrow US | medium | mandatory | 1 | candidate | Texas Instruments | TPS563201DDCR
HUB_CORE | CMP_SENSOR_FRONTEND_UNIVERSAL | ANALOG_FRONTEND | 6-ch universal input conditioning network (per channel: 0-10V divider + RC filter + DI/pulse pull-up) | Discrete per-channel network - see SENSOR_FRONTEND_SPEC.md. Mode-select jumper picks 0-10V / 4-20mA / DI / pulse. Feeds ESP32-S3 ADC1. Divider/filter passives placed at schematic capture. | Mouser India; element14 India; local authorized distributor | Mouser US; Digi-Key US; Arrow US | medium | mandatory | 6 | candidate | SWAFarms | SWA-AFE-UNI-6CH (discrete network)
HUB_CORE | CMP_VALVE_DRIVER_CH | DRIVER | Full H-bridge valve driver (universal: latching + standard solenoids) | TI DRV8871 3.6A full H-bridge, 1 per valve (6/board). Bipolar drive: reverse-polarity pulse for latching solenoids (~2.5A/150ms), continuous for standard. Integrated freewheeling diodes + internal current limit + thermal shutdown. IN1/IN2 driven via SPI I/O expander. | Mouser India; element14 India; local authorized distributor | Mouser US; Digi-Key US; Arrow US | medium | mandatory | 6 | candidate | Texas Instruments | DRV8871DDAR
HUB_CORE | CMP_ESD_ARRAY | PROTECTION | ESD protection array for external ports | Select low-capacitance, IEC-rated ESD array matched to exposed interface voltage levels. | Mouser India; element14 India; local authorized distributor | Mouser US; Digi-Key US; Arrow US | low | mandatory | 4 | candidate | Nexperia | PESD2CANFD24VTQ
HUB_CORE | CMP_SURGE_PROTECTOR | PROTECTION | Power surge and transient protection stage | Prefer TVS/MOV network sized for field transients and long cable environments. | Mouser India; element14 India; local authorized distributor | Mouser US; Digi-Key US; Arrow US | low | mandatory | 1 | candidate | Littelfuse | SMAJ24A
HUB_CORE | CMP_CELLULAR_MODEM_4G | COMMUNICATION | 4G GSM/LTE modem for HUB internet uplink when Wi-Fi is unavailable; intended to pair with external economical high-performance antenna | Pick LTE Cat-1/Cat-1bis class module with strong India band support and good rural network fallback behavior. | Mouser India; element14 India; local authorized distributor | Mouser US; Digi-Key US; Arrow US | high | mandatory | 1 | candidate | Quectel | EG915U-CN
HUB_CORE | CMP_SIM_SLOT_NANO | COMMUNICATION | Nano-SIM card holder for cellular modem connectivity | Use locking, vibration-resistant Nano-SIM socket with exposed contact protection. | Mouser India; element14 India; local authorized distributor | Mouser US; Digi-Key US; Arrow US | low | mandatory | 1 | candidate | Molex | 1041681620
HUB_CORE | CMP_CELLULAR_ANTENNA | RF | External economical high-performance 4G LTE antenna, omni 3-5 dBi, IP67, SMA, short low-loss cable | Baseline: external omni 3-5 dBi LTE antenna for weak-signal farms; prioritize weatherproof design and low-loss feed cable. | Mouser India; element14 India; local authorized distributor | Mouser US; Digi-Key US; Arrow US | medium | mandatory | 1 | candidate | Taoglas | TG.30.8113
HUB_CORE | CMP_MICROSD_SLOT | STORAGE | microSD card slot for HUB local data logging | Choose industrial-temperature microSD socket with card-detect switch and dust protection. | Mouser India; element14 India; local authorized distributor | Mouser US; Digi-Key US; Arrow US | medium | mandatory | 1 | candidate | Molex | 1040310811
HUB_CORE | CMP_RTC_IC | TIMING | Real-time clock IC for schedule continuity during internet/power interruptions | Prefer low-drift I2C RTC with industrial temperature range and low backup current. | Mouser India; element14 India; local authorized distributor | Mouser US; Digi-Key US; Arrow US | medium | mandatory | 1 | candidate | NXP | PCF8523T/1,118
HUB_CORE | CMP_RTC_BACKUP | TIMING | RTC backup source (coin-cell or supercap) to retain time through power loss | Use maintenance-friendly backup choice and target multi-day time retention without main supply. | Mouser India; element14 India; local authorized distributor | Mouser US; Digi-Key US; Arrow US | medium | mandatory | 1 | candidate | Eaton | KVR-5R0C105-R
HUB_CORE | CMP_INPUT_FUSE_PTC | PROTECTION | Input fuse or resettable PTC stage for fault current limiting | Size for worst-case inrush and field wiring faults while avoiding nuisance trips. | Mouser India; element14 India; local authorized distributor | Mouser US; Digi-Key US; Arrow US | low | mandatory | 1 | candidate | Bourns | MF-R110
HUB_CORE | CMP_INPUT_TVS | PROTECTION | Input TVS clamp for surge and lightning transient suppression | Use automotive/industrial TVS sized for 12V systems and farm-line surge energy. | Mouser India; element14 India; local authorized distributor | Mouser US; Digi-Key US; Arrow US | low | mandatory | 1 | candidate | Littelfuse | SMBJ24A
HUB_CORE | CMP_POLARITY_PROTECT | PROTECTION | Reverse-polarity protection stage on field power input | Prefer low-loss ideal-diode MOSFET topology over diode-only schemes for thermal margin. | Mouser India; element14 India; local authorized distributor | Mouser US; Digi-Key US; Arrow US | low | mandatory | 1 | candidate | Infineon | IPD50N06S4L-16
HUB_CORE | CMP_EFUSE_UVLO_OVP | PROTECTION | eFuse or protection controller with UVLO and OVP cutoff | Target stable behavior during solar/generator fluctuations and repeated brownout events. | Mouser India; element14 India; local authorized distributor | Mouser US; Digi-Key US; Arrow US | medium | mandatory | 1 | candidate | Texas Instruments | TPS26600PWPR
HUB_CORE | CMP_RS485_LINE_PROTECT | PROTECTION | RS485 line surge and ESD protection network | Use dedicated RS485 protector with low capacitance and high surge capability near connector entry. | Mouser India; element14 India; local authorized distributor | Mouser US; Digi-Key US; Arrow US | low | mandatory | 1 | candidate | Littelfuse | SM712-02HTG
HUB_CORE | CMP_RS485_ISOLATOR | COMMUNICATION | Galvanic isolation stage for RS485 interface robustness | Prioritize for Motor Controller and long-cable links where ground potential differences are common. | Mouser India; element14 India; local authorized distributor | Mouser US; Digi-Key US; Arrow US | medium | mandatory | 1 | candidate | Texas Instruments | ISO1410BDWR
HUB_CORE | CMP_RS485_ISO_DCDC | COMMUNICATION | Isolated DC-DC supply for RS485 isolated interface domain | Required companion for isolated RS485 designs; prefer compact low-cost isolated power module or controller stage. | Mouser India; element14 India; local authorized distributor | Mouser US; Digi-Key US; Arrow US | medium | mandatory | 1 | candidate | Murata | NXE1S0505MC
HUB_CORE | CMP_RS485_TERM_SELECT | COMMUNICATION | Selectable RS485 termination network | Use jumper or solder-select termination so end-of-line nodes can be configured without PCB changes. | Mouser India; element14 India; local authorized distributor | Mouser US; Digi-Key US; Arrow US | low | mandatory | 1 | candidate | Vishay | CRCW0603120RFKEA
HUB_CORE | CMP_RS485_BIAS_NET | COMMUNICATION | RS485 fail-safe bias resistor network | Provide stable idle bus level on long field cables; size for noise immunity with acceptable current draw. | Mouser India; element14 India; local authorized distributor | Mouser US; Digi-Key US; Arrow US | low | mandatory | 1 | candidate | Vishay | CRCW0603680RFKEA
HUB_CORE | CMP_RS485_CMC | COMMUNICATION | RS485 common-mode choke or ferrite filtering stage | Helps suppress cable-borne noise from motors and long runs with low incremental BOM cost. | Mouser India; element14 India; local authorized distributor | Mouser US; Digi-Key US; Arrow US | low | mandatory | 1 | candidate | Wurth Elektronik | 744232090
HUB_CORE | CMP_CONN_M12A_5P_RS485_PANEL | CONNECTOR | M12 A-coded 5-pin panel connector for RS485 bus ports | Use keyed, sealed field connector; assign only to RS485 ports so it cannot be confused with sensor or valve terminals. | Mouser India; element14 India; local authorized distributor | Mouser US; Digi-Key US; Arrow US | medium | mandatory | 2 | candidate | TE Connectivity | T4141412051-000
HUB_CORE | CMP_CONN_M12A_4P_PWR12_PANEL | CONNECTOR | M12 A-coded 4-pin panel connector for 12V power ports | Use only for 12V power IN/OUT and keep physically separated from RS485 to prevent miswire damage. | Mouser India; element14 India; local authorized distributor | Mouser US; Digi-Key US; Arrow US | medium | mandatory | 1 | candidate | TE Connectivity | T4141412041-000
HUB_CORE | CMP_CONN_TERM_6CH_SENSOR | CONNECTOR | Sensor input terminal - 2x 6-pole blocks = 12 poles (6x CHx_SIG + shared +12V loop supply + GND) | Dedicated to sensor inputs only (DI/Pulse/0-10V/4-20mA); do not share footprint with valve terminal connector. | Mouser India; element14 India; local authorized distributor | Mouser US; Digi-Key US; Arrow US | low | mandatory | 2 | candidate | Phoenix Contact | 1840409
HUB_CORE | CMP_CONN_TERM_6CH_VALVE | CONNECTOR | Pluggable valve terminal - 2x 6-position blocks = 12 poles (6 independent valve pairs for H-bridge/latching drive) | Dedicated to valve outputs only; keep separate connector group from sensors for fool-proof field wiring. | Mouser India; element14 India; local authorized distributor | Mouser US; Digi-Key US; Arrow US | low | mandatory | 2 | candidate | Phoenix Contact | 1840412
HUB_CORE | CMP_CONN_SMA_BULKHEAD | CONNECTOR | SMA bulkhead RF connector | Use weather-capable SMA bulkhead where external LoRa antenna connection is required. | Mouser India; element14 India; local authorized distributor | Mouser US; Digi-Key US; Arrow US | low | recommended | 1 | candidate | Amphenol RF | 132134
HUB_CORE | CMP_VALVE_LINE_CLAMP | PROTECTION | Per-channel valve line clamp for inductive and surge stress reduction | Place close to output stage or connector to reduce surge energy reaching control electronics. | Mouser India; element14 India; local authorized distributor | Mouser US; Digi-Key US; Arrow US | low | mandatory | 6 | candidate | Littelfuse | SMBJ33A
HUB_CORE | CMP_VALVE_FLYBACK_DIODE_CH | PROTECTION | Per-channel flyback diode for valve coil energy dissipation | Mandatory on each valve channel to protect switch and reduce EMI at coil turn-off. | Mouser India; element14 India; local authorized distributor | Mouser US; Digi-Key US; Arrow US | low | mandatory | 6 | candidate | onsemi | ES1D
HUB_CORE | CMP_VALVE_GATE_NETWORK_CH | DRIVER | Per-channel gate resistor and pull network for valve driver MOSFET | Stabilizes switching behavior and reduces false turn-on in high-noise field wiring conditions. | Mouser India; element14 India; local authorized distributor | Mouser US; Digi-Key US; Arrow US | low | mandatory | 6 | candidate | Yageo | RC0603FR-07100RL
HUB_CORE | CMP_VALVE_CURRENT_SENSE_CH | DRIVER | Per-channel valve current sense element | Optional but recommended for diagnostics like open-coil/short detection and predictive maintenance analytics. | Mouser India; element14 India; local authorized distributor | Mouser US; Digi-Key US; Arrow US | low | optional | 6 | candidate | Bourns | CSS2H-2512R-L100F
HUB_CORE | CMP_LED_PWR | UI_INDICATOR | Power status LED indicator | Low-current LED (around 1-2 mA) with common footprint shared across all indicator LEDs for cost control. | Mouser India; element14 India; local authorized distributor | Mouser US; Digi-Key US; Arrow US | low | mandatory | 1 | candidate | Kingbright | APT1608QBC-D
HUB_CORE | CMP_LED_STATUS | UI_INDICATOR | System status LED indicator for heartbeat and state codes | Use blink code strategy instead of adding extra LEDs; keep app as primary diagnostics source. | Mouser India; element14 India; local authorized distributor | Mouser US; Digi-Key US; Arrow US | low | recommended | 1 | candidate | Kingbright | APT1608SGC
HUB_CORE | CMP_LED_LINK | UI_INDICATOR | Communication link LED indicator (RS485, cloud, or LoRa activity) | Shared LED package family; color can be selected by stuffing while keeping one PCB footprint. | Mouser India; element14 India; local authorized distributor | Mouser US; Digi-Key US; Arrow US | low | mandatory | 1 | candidate | Kingbright | APT1608SYCK
HUB_CORE | CMP_LED_RESISTOR_NET | UI_INDICATOR | LED current-limiting resistor network | Dimension for low-brightness outdoor readability and low power draw; one resistor path per LED channel. | Mouser India; element14 India; local authorized distributor | Mouser US; Digi-Key US; Arrow US | low | mandatory | 3 | candidate | Yageo | RC0603FR-071KL
HUB_CORE | CMP_BT_RADIO_INTEGRATED | RF | Bluetooth LE radio included in MCU platform (reference component) | Reference-only line item to indicate BLE is integrated into MCU; no separate BOM silicon required. | Mouser India; element14 India; local authorized distributor | Mouser US; Digi-Key US; Arrow US | medium | mandatory | 1 | approved | Integrated | Integrated
NODE_CORE | CMP_MCU_ESP32S3 | MCU | Primary MCU with integrated Wi-Fi and BLE radios | Use MCU variant with stable supply in India and long-term availability; Wi-Fi and BLE are integrated in this component. | Mouser India; element14 India; local authorized distributor | Mouser US; Digi-Key US; Arrow US | high | mandatory | 1 | candidate | Espressif | ESP32-S3-WROOM-1-N16R8
NODE_CORE | CMP_RS485_TRANSCEIVER | COMMUNICATION | RS-485 transceiver | Prefer half-duplex 3.3V transceiver with ESD robustness and fail-safe receiver for long cable runs. | Mouser India; element14 India; local authorized distributor | Mouser US; Digi-Key US; Arrow US | medium | mandatory | 2 | candidate | Texas Instruments | THVD1450DR
NODE_CORE | CMP_REGULATOR_12V_TO_5V | POWER | Primary buck regulator | Prefer automotive/industrial-grade buck with wide input tolerance, low heat, and short-circuit protection. | Mouser India; element14 India; local authorized distributor | Mouser US; Digi-Key US; Arrow US | medium | mandatory | 1 | candidate | Texas Instruments | TPS54531DDAR
NODE_CORE | CMP_REGULATOR_5V_TO_3V3 | POWER | Secondary 3.3V regulator | Choose low-noise regulator with sufficient current margin for RF peaks and sensors. | Mouser India; element14 India; local authorized distributor | Mouser US; Digi-Key US; Arrow US | medium | mandatory | 1 | candidate | Texas Instruments | TPS563201DDCR
NODE_CORE | CMP_SENSOR_FRONTEND_UNIVERSAL | ANALOG_FRONTEND | 6-ch universal input conditioning network (per channel: 0-10V divider + RC filter + DI/pulse pull-up) | Discrete per-channel network - see SENSOR_FRONTEND_SPEC.md. Mode-select jumper picks 0-10V / 4-20mA / DI / pulse. Feeds ESP32-S3 ADC1. Divider/filter passives placed at schematic capture. | Mouser India; element14 India; local authorized distributor | Mouser US; Digi-Key US; Arrow US | medium | mandatory | 6 | candidate | SWAFarms | SWA-AFE-UNI-6CH (discrete network)
NODE_CORE | CMP_VALVE_DRIVER_CH | DRIVER | Full H-bridge valve driver (universal: latching + standard solenoids) | TI DRV8871 3.6A full H-bridge, 1 per valve (6/board). Bipolar drive: reverse-polarity pulse for latching solenoids (~2.5A/150ms), continuous for standard. Integrated freewheeling diodes + internal current limit + thermal shutdown. IN1/IN2 driven via SPI I/O expander. | Mouser India; element14 India; local authorized distributor | Mouser US; Digi-Key US; Arrow US | medium | mandatory | 6 | candidate | Texas Instruments | DRV8871DDAR
NODE_CORE | CMP_ESD_ARRAY | PROTECTION | ESD protection array for external ports | Select low-capacitance, IEC-rated ESD array matched to exposed interface voltage levels. | Mouser India; element14 India; local authorized distributor | Mouser US; Digi-Key US; Arrow US | low | mandatory | 4 | candidate | Nexperia | PESD2CANFD24VTQ
NODE_CORE | CMP_SURGE_PROTECTOR | PROTECTION | Power surge and transient protection stage | Prefer TVS/MOV network sized for field transients and long cable environments. | Mouser India; element14 India; local authorized distributor | Mouser US; Digi-Key US; Arrow US | low | mandatory | 1 | candidate | Littelfuse | SMAJ24A
NODE_CORE | CMP_INPUT_FUSE_PTC | PROTECTION | Input fuse or resettable PTC stage for fault current limiting | Size for worst-case inrush and field wiring faults while avoiding nuisance trips. | Mouser India; element14 India; local authorized distributor | Mouser US; Digi-Key US; Arrow US | low | mandatory | 1 | candidate | Bourns | MF-R110
NODE_CORE | CMP_INPUT_TVS | PROTECTION | Input TVS clamp for surge and lightning transient suppression | Use automotive/industrial TVS sized for 12V systems and farm-line surge energy. | Mouser India; element14 India; local authorized distributor | Mouser US; Digi-Key US; Arrow US | low | mandatory | 1 | candidate | Littelfuse | SMBJ24A
NODE_CORE | CMP_POLARITY_PROTECT | PROTECTION | Reverse-polarity protection stage on field power input | Prefer low-loss ideal-diode MOSFET topology over diode-only schemes for thermal margin. | Mouser India; element14 India; local authorized distributor | Mouser US; Digi-Key US; Arrow US | low | mandatory | 1 | candidate | Infineon | IPD50N06S4L-16
NODE_CORE | CMP_EFUSE_UVLO_OVP | PROTECTION | eFuse or protection controller with UVLO and OVP cutoff | Target stable behavior during solar/generator fluctuations and repeated brownout events. | Mouser India; element14 India; local authorized distributor | Mouser US; Digi-Key US; Arrow US | medium | mandatory | 1 | candidate | Texas Instruments | TPS26600PWPR
NODE_CORE | CMP_RS485_LINE_PROTECT | PROTECTION | RS485 line surge and ESD protection network | Use dedicated RS485 protector with low capacitance and high surge capability near connector entry. | Mouser India; element14 India; local authorized distributor | Mouser US; Digi-Key US; Arrow US | low | mandatory | 2 | candidate | Littelfuse | SM712-02HTG
NODE_CORE | CMP_RS485_ISOLATOR | COMMUNICATION | Galvanic isolation stage for RS485 interface robustness | Prioritize for Motor Controller and long-cable links where ground potential differences are common. | Mouser India; element14 India; local authorized distributor | Mouser US; Digi-Key US; Arrow US | medium | mandatory | 1 | candidate | Texas Instruments | ISO1410BDWR
NODE_CORE | CMP_RS485_ISO_DCDC | COMMUNICATION | Isolated DC-DC supply for RS485 isolated interface domain | Required companion for isolated RS485 designs; prefer compact low-cost isolated power module or controller stage. | Mouser India; element14 India; local authorized distributor | Mouser US; Digi-Key US; Arrow US | medium | mandatory | 1 | candidate | Murata | NXE1S0505MC
NODE_CORE | CMP_RS485_TERM_SELECT | COMMUNICATION | Selectable RS485 termination network | Use jumper or solder-select termination so end-of-line nodes can be configured without PCB changes. | Mouser India; element14 India; local authorized distributor | Mouser US; Digi-Key US; Arrow US | low | mandatory | 2 | candidate | Vishay | CRCW0603120RFKEA
NODE_CORE | CMP_RS485_BIAS_NET | COMMUNICATION | RS485 fail-safe bias resistor network | Provide stable idle bus level on long field cables; size for noise immunity with acceptable current draw. | Mouser India; element14 India; local authorized distributor | Mouser US; Digi-Key US; Arrow US | low | mandatory | 2 | candidate | Vishay | CRCW0603680RFKEA
NODE_CORE | CMP_RS485_CMC | COMMUNICATION | RS485 common-mode choke or ferrite filtering stage | Helps suppress cable-borne noise from motors and long runs with low incremental BOM cost. | Mouser India; element14 India; local authorized distributor | Mouser US; Digi-Key US; Arrow US | low | mandatory | 2 | candidate | Wurth Elektronik | 744232090
NODE_CORE | CMP_CONN_M12A_5P_RS485_PANEL | CONNECTOR | M12 A-coded 5-pin panel connector for RS485 bus ports | Use keyed, sealed field connector; assign only to RS485 ports so it cannot be confused with sensor or valve terminals. | Mouser India; element14 India; local authorized distributor | Mouser US; Digi-Key US; Arrow US | medium | mandatory | 3 | candidate | TE Connectivity | T4141412051-000
NODE_CORE | CMP_CONN_M12A_4P_PWR12_PANEL | CONNECTOR | M12 A-coded 4-pin panel connector for 12V power ports | Use only for 12V power IN/OUT and keep physically separated from RS485 to prevent miswire damage. | Mouser India; element14 India; local authorized distributor | Mouser US; Digi-Key US; Arrow US | medium | mandatory | 2 | candidate | TE Connectivity | T4141412041-000
NODE_CORE | CMP_CONN_TERM_6CH_SENSOR | CONNECTOR | Sensor input terminal - 2x 6-pole blocks = 12 poles (6x CHx_SIG + shared +12V loop supply + GND) | Dedicated to sensor inputs only (DI/Pulse/0-10V/4-20mA); do not share footprint with valve terminal connector. | Mouser India; element14 India; local authorized distributor | Mouser US; Digi-Key US; Arrow US | low | mandatory | 2 | candidate | Phoenix Contact | 1840409
NODE_CORE | CMP_CONN_TERM_6CH_VALVE | CONNECTOR | Pluggable valve terminal - 2x 6-position blocks = 12 poles (6 independent valve pairs for H-bridge/latching drive) | Dedicated to valve outputs only; keep separate connector group from sensors for fool-proof field wiring. | Mouser India; element14 India; local authorized distributor | Mouser US; Digi-Key US; Arrow US | low | mandatory | 2 | candidate | Phoenix Contact | 1840412
NODE_CORE | CMP_CONN_SMA_BULKHEAD | CONNECTOR | SMA bulkhead RF connector | Use weather-capable SMA bulkhead where external LoRa antenna connection is required. | Mouser India; element14 India; local authorized distributor | Mouser US; Digi-Key US; Arrow US | low | recommended | 1 | candidate | Amphenol RF | 132134
NODE_CORE | CMP_VALVE_LINE_CLAMP | PROTECTION | Per-channel valve line clamp for inductive and surge stress reduction | Place close to output stage or connector to reduce surge energy reaching control electronics. | Mouser India; element14 India; local authorized distributor | Mouser US; Digi-Key US; Arrow US | low | mandatory | 6 | candidate | Littelfuse | SMBJ33A
NODE_CORE | CMP_VALVE_FLYBACK_DIODE_CH | PROTECTION | Per-channel flyback diode for valve coil energy dissipation | Mandatory on each valve channel to protect switch and reduce EMI at coil turn-off. | Mouser India; element14 India; local authorized distributor | Mouser US; Digi-Key US; Arrow US | low | mandatory | 6 | candidate | onsemi | ES1D
NODE_CORE | CMP_VALVE_GATE_NETWORK_CH | DRIVER | Per-channel gate resistor and pull network for valve driver MOSFET | Stabilizes switching behavior and reduces false turn-on in high-noise field wiring conditions. | Mouser India; element14 India; local authorized distributor | Mouser US; Digi-Key US; Arrow US | low | mandatory | 6 | candidate | Yageo | RC0603FR-07100RL
NODE_CORE | CMP_VALVE_CURRENT_SENSE_CH | DRIVER | Per-channel valve current sense element | Optional but recommended for diagnostics like open-coil/short detection and predictive maintenance analytics. | Mouser India; element14 India; local authorized distributor | Mouser US; Digi-Key US; Arrow US | low | optional | 6 | candidate | Bourns | CSS2H-2512R-L100F
NODE_CORE | CMP_LED_PWR | UI_INDICATOR | Power status LED indicator | Low-current LED (around 1-2 mA) with common footprint shared across all indicator LEDs for cost control. | Mouser India; element14 India; local authorized distributor | Mouser US; Digi-Key US; Arrow US | low | mandatory | 1 | candidate | Kingbright | APT1608QBC-D
NODE_CORE | CMP_LED_LINK | UI_INDICATOR | Communication link LED indicator (RS485, cloud, or LoRa activity) | Shared LED package family; color can be selected by stuffing while keeping one PCB footprint. | Mouser India; element14 India; local authorized distributor | Mouser US; Digi-Key US; Arrow US | low | mandatory | 1 | candidate | Kingbright | APT1608SYCK
NODE_CORE | CMP_LED_RESISTOR_NET | UI_INDICATOR | LED current-limiting resistor network | Dimension for low-brightness outdoor readability and low power draw; one resistor path per LED channel. | Mouser India; element14 India; local authorized distributor | Mouser US; Digi-Key US; Arrow US | low | mandatory | 2 | candidate | Yageo | RC0603FR-071KL
NODE_CORE | CMP_BT_RADIO_INTEGRATED | RF | Bluetooth LE radio included in MCU platform (reference component) | Reference-only line item to indicate BLE is integrated into MCU; no separate BOM silicon required. | Mouser India; element14 India; local authorized distributor | Mouser US; Digi-Key US; Arrow US | medium | mandatory | 1 | approved | Integrated | Integrated
MOTOR_CONTROLLER | CMP_MCU_ESP32S3 | MCU | Primary MCU with integrated Wi-Fi and BLE radios | Use MCU variant with stable supply in India and long-term availability; Wi-Fi and BLE are integrated in this component. | Mouser India; element14 India; local authorized distributor | Mouser US; Digi-Key US; Arrow US | high | mandatory | 1 | candidate | Espressif | ESP32-S3-WROOM-1-N16R8
MOTOR_CONTROLLER | CMP_RS485_TRANSCEIVER | COMMUNICATION | RS-485 transceiver | Prefer half-duplex 3.3V transceiver with ESD robustness and fail-safe receiver for long cable runs. | Mouser India; element14 India; local authorized distributor | Mouser US; Digi-Key US; Arrow US | medium | mandatory | 1 | candidate | Texas Instruments | THVD1450DR
MOTOR_CONTROLLER | CMP_REGULATOR_12V_TO_5V | POWER | Primary buck regulator | Prefer automotive/industrial-grade buck with wide input tolerance, low heat, and short-circuit protection. | Mouser India; element14 India; local authorized distributor | Mouser US; Digi-Key US; Arrow US | medium | mandatory | 1 | candidate | Texas Instruments | TPS54531DDAR
MOTOR_CONTROLLER | CMP_REGULATOR_5V_TO_3V3 | POWER | Secondary 3.3V regulator | Choose low-noise regulator with sufficient current margin for RF peaks and sensors. | Mouser India; element14 India; local authorized distributor | Mouser US; Digi-Key US; Arrow US | medium | mandatory | 1 | candidate | Texas Instruments | TPS563201DDCR
MOTOR_CONTROLLER | CMP_ESD_ARRAY | PROTECTION | ESD protection array for external ports | Select low-capacitance, IEC-rated ESD array matched to exposed interface voltage levels. | Mouser India; element14 India; local authorized distributor | Mouser US; Digi-Key US; Arrow US | low | mandatory | 3 | candidate | Nexperia | PESD2CANFD24VTQ
MOTOR_CONTROLLER | CMP_SURGE_PROTECTOR | PROTECTION | Power surge and transient protection stage | Prefer TVS/MOV network sized for field transients and long cable environments. | Mouser India; element14 India; local authorized distributor | Mouser US; Digi-Key US; Arrow US | low | mandatory | 1 | candidate | Littelfuse | SMAJ24A
MOTOR_CONTROLLER | CMP_INPUT_FUSE_PTC | PROTECTION | Input fuse or resettable PTC stage for fault current limiting | Size for worst-case inrush and field wiring faults while avoiding nuisance trips. | Mouser India; element14 India; local authorized distributor | Mouser US; Digi-Key US; Arrow US | low | mandatory | 1 | candidate | Bourns | MF-R110
MOTOR_CONTROLLER | CMP_INPUT_TVS | PROTECTION | Input TVS clamp for surge and lightning transient suppression | Use automotive/industrial TVS sized for 12V systems and farm-line surge energy. | Mouser India; element14 India; local authorized distributor | Mouser US; Digi-Key US; Arrow US | low | mandatory | 1 | candidate | Littelfuse | SMBJ24A
MOTOR_CONTROLLER | CMP_POLARITY_PROTECT | PROTECTION | Reverse-polarity protection stage on field power input | Prefer low-loss ideal-diode MOSFET topology over diode-only schemes for thermal margin. | Mouser India; element14 India; local authorized distributor | Mouser US; Digi-Key US; Arrow US | low | mandatory | 1 | candidate | Infineon | IPD50N06S4L-16
MOTOR_CONTROLLER | CMP_EFUSE_UVLO_OVP | PROTECTION | eFuse or protection controller with UVLO and OVP cutoff | Target stable behavior during solar/generator fluctuations and repeated brownout events. | Mouser India; element14 India; local authorized distributor | Mouser US; Digi-Key US; Arrow US | medium | mandatory | 1 | candidate | Texas Instruments | TPS26600PWPR
MOTOR_CONTROLLER | CMP_RS485_LINE_PROTECT | PROTECTION | RS485 line surge and ESD protection network | Use dedicated RS485 protector with low capacitance and high surge capability near connector entry. | Mouser India; element14 India; local authorized distributor | Mouser US; Digi-Key US; Arrow US | low | mandatory | 1 | candidate | Littelfuse | SM712-02HTG
MOTOR_CONTROLLER | CMP_RS485_ISOLATOR | COMMUNICATION | Galvanic isolation stage for RS485 interface robustness | Prioritize for Motor Controller and long-cable links where ground potential differences are common. | Mouser India; element14 India; local authorized distributor | Mouser US; Digi-Key US; Arrow US | medium | mandatory | 1 | candidate | Texas Instruments | ISO1410BDWR
MOTOR_CONTROLLER | CMP_RS485_ISO_DCDC | COMMUNICATION | Isolated DC-DC supply for RS485 isolated interface domain | Required companion for isolated RS485 designs; prefer compact low-cost isolated power module or controller stage. | Mouser India; element14 India; local authorized distributor | Mouser US; Digi-Key US; Arrow US | medium | mandatory | 1 | candidate | Murata | NXE1S0505MC
MOTOR_CONTROLLER | CMP_RS485_TERM_SELECT | COMMUNICATION | Selectable RS485 termination network | Use jumper or solder-select termination so end-of-line nodes can be configured without PCB changes. | Mouser India; element14 India; local authorized distributor | Mouser US; Digi-Key US; Arrow US | low | mandatory | 1 | candidate | Vishay | CRCW0603120RFKEA
MOTOR_CONTROLLER | CMP_RS485_BIAS_NET | COMMUNICATION | RS485 fail-safe bias resistor network | Provide stable idle bus level on long field cables; size for noise immunity with acceptable current draw. | Mouser India; element14 India; local authorized distributor | Mouser US; Digi-Key US; Arrow US | low | mandatory | 1 | candidate | Vishay | CRCW0603680RFKEA
MOTOR_CONTROLLER | CMP_RS485_CMC | COMMUNICATION | RS485 common-mode choke or ferrite filtering stage | Helps suppress cable-borne noise from motors and long runs with low incremental BOM cost. | Mouser India; element14 India; local authorized distributor | Mouser US; Digi-Key US; Arrow US | low | mandatory | 1 | candidate | Wurth Elektronik | 744232090
MOTOR_CONTROLLER | CMP_MOTOR_IO_ISOLATOR | PROTECTION | Motor starter I/O isolation stage (opto or digital isolator) | Isolate noisy starter panel signals from controller logic; prioritize robust CMTI and industrial temperature support. | Mouser India; element14 India; local authorized distributor | Mouser US; Digi-Key US; Arrow US | medium | mandatory | 1 | candidate | Broadcom | ACPL-247-500E
MOTOR_CONTROLLER | CMP_CONN_M12A_5P_RS485_PANEL | CONNECTOR | M12 A-coded 5-pin panel connector for RS485 bus ports | Use keyed, sealed field connector; assign only to RS485 ports so it cannot be confused with sensor or valve terminals. | Mouser India; element14 India; local authorized distributor | Mouser US; Digi-Key US; Arrow US | medium | mandatory | 2 | candidate | TE Connectivity | T4141412051-000
MOTOR_CONTROLLER | CMP_CONN_M12A_4P_PWR12_PANEL | CONNECTOR | M12 A-coded 4-pin panel connector for 12V power ports | Use only for 12V power IN/OUT and keep physically separated from RS485 to prevent miswire damage. | Mouser India; element14 India; local authorized distributor | Mouser US; Digi-Key US; Arrow US | medium | mandatory | 1 | candidate | TE Connectivity | T4141412041-000
MOTOR_CONTROLLER | CMP_CONN_TERM_STARTER_IO | CONNECTOR | Pluggable terminal connector for motor starter command and feedback | Use dedicated starter I/O connector with clear terminal labels for RUN command, FEEDBACK, and COM. | Mouser India; element14 India; local authorized distributor | Mouser US; Digi-Key US; Arrow US | low | mandatory | 1 | candidate | Phoenix Contact | 1777992
MOTOR_CONTROLLER | CMP_LED_PWR | UI_INDICATOR | Power status LED indicator | Low-current LED (around 1-2 mA) with common footprint shared across all indicator LEDs for cost control. | Mouser India; element14 India; local authorized distributor | Mouser US; Digi-Key US; Arrow US | low | mandatory | 1 | candidate | Kingbright | APT1608QBC-D
MOTOR_CONTROLLER | CMP_LED_LINK | UI_INDICATOR | Communication link LED indicator (RS485, cloud, or LoRa activity) | Shared LED package family; color can be selected by stuffing while keeping one PCB footprint. | Mouser India; element14 India; local authorized distributor | Mouser US; Digi-Key US; Arrow US | low | mandatory | 1 | candidate | Kingbright | APT1608SYCK
MOTOR_CONTROLLER | CMP_LED_FAULT | UI_INDICATOR | Fault/alarm LED indicator | Prefer red indicator and only for actionable fault states; avoid continuous high-current operation. | Mouser India; element14 India; local authorized distributor | Mouser US; Digi-Key US; Arrow US | low | recommended | 1 | candidate | Kingbright | APT1608SURCK
MOTOR_CONTROLLER | CMP_LED_RESISTOR_NET | UI_INDICATOR | LED current-limiting resistor network | Dimension for low-brightness outdoor readability and low power draw; one resistor path per LED channel. | Mouser India; element14 India; local authorized distributor | Mouser US; Digi-Key US; Arrow US | low | mandatory | 3 | candidate | Yageo | RC0603FR-071KL
MOTOR_CONTROLLER | CMP_BT_RADIO_INTEGRATED | RF | Bluetooth LE radio included in MCU platform (reference component) | Reference-only line item to indicate BLE is integrated into MCU; no separate BOM silicon required. | Mouser India; element14 India; local authorized distributor | Mouser US; Digi-Key US; Arrow US | medium | mandatory | 1 | approved | Integrated | Integrated
LORA_MODULE_ADDON | CMP_LORA_MODULE_IN865 | RF_MODULE | LoRa module for IN865 region | Select pre-certified IN865-capable module with good sensitivity and low idle current. | Mouser India; element14 India; local authorized distributor | Mouser US; Digi-Key US; Arrow US | medium | recommended | 1 | candidate | RAKwireless | RAK3172
LORA_MODULE_ADDON | CMP_LED_LINK | UI_INDICATOR | Communication link LED indicator (RS485, cloud, or LoRa activity) | Shared LED package family; color can be selected by stuffing while keeping one PCB footprint. | Mouser India; element14 India; local authorized distributor | Mouser US; Digi-Key US; Arrow US | low | mandatory | 1 | candidate | Kingbright | APT1608SYCK
LORA_MODULE_ADDON | CMP_LED_RESISTOR_NET | UI_INDICATOR | LED current-limiting resistor network | Dimension for low-brightness outdoor readability and low power draw; one resistor path per LED channel. | Mouser India; element14 India; local authorized distributor | Mouser US; Digi-Key US; Arrow US | low | mandatory | 1 | candidate | Yageo | RC0603FR-071KL
LORA_MODULE_ADDON | CMP_ESD_ARRAY | PROTECTION | ESD protection array for external ports | Select low-capacitance, IEC-rated ESD array matched to exposed interface voltage levels. | Mouser India; element14 India; local authorized distributor | Mouser US; Digi-Key US; Arrow US | low | mandatory | 1 | candidate | Nexperia | PESD2CANFD24VTQ
TEST_FIELD_KIT | CMP_MATE_M12A_5P_RS485_CABLE | TEST_ACCESSORY | Mating M12 A-coded 5-pin RS485 test cable set | Order with pre-crimped leads for faster prototype bring-up and polarity-safe bench wiring. | Mouser India; element14 India; local authorized distributor | Mouser US; Digi-Key US; Arrow US | medium | mandatory | 8 | candidate | Phoenix Contact | 1408860
TEST_FIELD_KIT | CMP_MATE_M12A_4P_PWR12_CABLE | TEST_ACCESSORY | Mating M12 A-coded 4-pin 12V power cable set | Use dedicated color code for +12V and GND; never reuse RS485 cable assemblies for power. | Mouser India; element14 India; local authorized distributor | Mouser US; Digi-Key US; Arrow US | medium | mandatory | 8 | candidate | Phoenix Contact | 1408872
TEST_FIELD_KIT | CMP_MATE_TERM_6CH_SENSOR_PLUG | TEST_ACCESSORY | Mating plug for 6-channel sensor terminal | Order enough spares for sensor harness prep and bench test jig rewiring. | Mouser India; element14 India; local authorized distributor | Mouser US; Digi-Key US; Arrow US | low | mandatory | 6 | candidate | Phoenix Contact | 1757242
TEST_FIELD_KIT | CMP_MATE_TERM_6CH_VALVE_PLUG | TEST_ACCESSORY | Mating plug for 6-channel valve terminal | Keep different part code from sensor plug to enforce separate stock and avoid accidental mix-up. | Mouser India; element14 India; local authorized distributor | Mouser US; Digi-Key US; Arrow US | low | mandatory | 6 | candidate | Phoenix Contact | 1757243
TEST_FIELD_KIT | CMP_MATE_TERM_STARTER_IO_PLUG | TEST_ACCESSORY | Mating plug for starter I/O terminal | Use a dedicated harness for starter commands and feedback lines with clear ferrule markers. | Mouser India; element14 India; local authorized distributor | Mouser US; Digi-Key US; Arrow US | low | mandatory | 2 | candidate | Phoenix Contact | 1777976
TEST_FIELD_KIT | CMP_TEST_SENSOR_SOIL_MOISTURE_4_20MA | TEST_ACCESSORY | 4-20mA soil moisture sensor for channel validation | Use as baseline analog current-loop validation sensor during prototype testing. | Mouser India; Robu India; local instrumentation supplier | Digi-Key US; Mouser US; AutomationDirect US | medium | recommended | 4 | candidate | DFRobot | SEN0257
TEST_FIELD_KIT | CMP_TEST_SENSOR_PRESSURE_4_20MA | TEST_ACCESSORY | 4-20mA pressure sensor for input verification | Validates scaling, filtering, and fault handling for process pressure inputs. | Mouser India; Robu India; local instrumentation supplier | Digi-Key US; Mouser US; AutomationDirect US | medium | recommended | 2 | candidate | AutomationDirect | PTLV-4A-15
TEST_FIELD_KIT | CMP_TEST_SENSOR_FLOW_PULSE | TEST_ACCESSORY | Pulse-output flow sensor for counter channel testing | Used to verify pulse capture accuracy and debounce/filtering behavior. | Robu India; element14 India; local authorized distributor | Digi-Key US; Mouser US; AutomationDirect US | low | recommended | 2 | candidate | Seeed Studio | 314150005
TEST_FIELD_KIT | CMP_TEST_SENSOR_LEVEL_0_10V | TEST_ACCESSORY | 0-10V level sensor/transducer for analog voltage channel testing | Covers universal analog voltage input validation across field range. | Robu India; element14 India; local instrumentation supplier | Digi-Key US; Mouser US; AutomationDirect US | low | recommended | 2 | candidate | Dwyer | 616KD-11-V
TEST_FIELD_KIT | CMP_TEST_SWITCH_FLOAT_DI | TEST_ACCESSORY | Dry-contact float switch for digital input testing | Low-cost DI validation device used for wet-well and tank-level switch simulation. | Local electrical distributor; Robu India | AutomationDirect US; Digi-Key US | low | recommended | 2 | candidate | Madison | M8000
TEST_FIELD_KIT | CMP_TEST_VALVE_SOLENOID_12V | TEST_ACCESSORY | 12V DC irrigation solenoid valve for output channel testing | Use as representative field load to validate valve output drive, flyback handling, and fail-safe stop behavior. | Irrigation supplier India; local authorized distributor | Irrigation supplier US; local authorized distributor | medium | recommended | 6 | candidate | Hunter | 606800
HUB_CORE | CMP_CONN_HDR_LORA_BAY |  | PCB header socket for plug-in LoRa module bay (3.3V, GND, UART TX/RX, RF path) |  |  |  |  |  | 1 | candidate | Wurth Elektronik | 61201121821
NODE_CORE | CMP_CONN_HDR_LORA_BAY |  | PCB header socket for plug-in LoRa module bay (3.3V, GND, UART TX/RX, RF path) |  |  |  |  |  | 1 | candidate | Wurth Elektronik | 61201121821
HUB_CORE | CMP_VALVE_HBRIDGE_SPI_EXPANDER | DRIVER | SPI 16-bit I/O expander generating the 12 H-bridge control lines (IN1/IN2) for the 6 valve drivers | MCP23S17 SPI expander: one SPI bus drives all valves, frees MCU GPIO. 2 spare bits. | Mouser India; element14 India; local authorized distributor | Mouser US; Digi-Key US; Arrow US | low | mandatory | 1 | approved | Microchip | MCP23S17-E/SS
NODE_CORE | CMP_VALVE_HBRIDGE_SPI_EXPANDER | DRIVER | SPI 16-bit I/O expander generating the 12 H-bridge control lines (IN1/IN2) for the 6 valve drivers | MCP23S17 SPI expander: one SPI bus drives all valves, frees MCU GPIO. 2 spare bits. | Mouser India; element14 India; local authorized distributor | Mouser US; Digi-Key US; Arrow US | low | mandatory | 1 | approved | Microchip | MCP23S17-E/SS
HUB_CORE | CMP_VALVE_PULSE_BULK_CAP | POWER | Bulk reservoir capacitor supplying the latching-solenoid pulse current (~2.5A, ~150ms) | 1000uF 25V low-ESR aluminum electrolytic placed next to the valve H-bridges. | Mouser India; element14 India; local authorized distributor | Mouser US; Digi-Key US; Arrow US | low | mandatory | 1 | approved | Panasonic | EEU-FR1E102
NODE_CORE | CMP_VALVE_PULSE_BULK_CAP | POWER | Bulk reservoir capacitor supplying the latching-solenoid pulse current (~2.5A, ~150ms) | 1000uF 25V low-ESR aluminum electrolytic placed next to the valve H-bridges. | Mouser India; element14 India; local authorized distributor | Mouser US; Digi-Key US; Arrow US | low | mandatory | 1 | approved | Panasonic | EEU-FR1E102
HUB_CORE | CMP_SENSOR_BURDEN_R | SENSOR | 4-20mA burden/sense resistor, 150ohm 0.1% (0.6-3.0V at 4-20mA) | Precision burden for 4-20mA mode; 1 per channel (populated on current-mode channels). | Mouser India; element14 India; local authorized distributor | Mouser US; Digi-Key US; Arrow US | low | mandatory | 6 | approved | Yageo | RT0805BRD07150RL
NODE_CORE | CMP_SENSOR_BURDEN_R | SENSOR | 4-20mA burden/sense resistor, 150ohm 0.1% (0.6-3.0V at 4-20mA) | Precision burden for 4-20mA mode; 1 per channel (populated on current-mode channels). | Mouser India; element14 India; local authorized distributor | Mouser US; Digi-Key US; Arrow US | low | mandatory | 6 | approved | Yageo | RT0805BRD07150RL
HUB_CORE | CMP_SENSOR_INPUT_PROTECT | PROTECTION | Per-channel ADC input clamp (BAV99 dual diode to 3V3/GND) with series protection resistor | Clamps ADC pin to rails on over-range/mis-wire; pairs with 100ohm series R and connector TVS. | Mouser India; element14 India; local authorized distributor | Mouser US; Digi-Key US; Arrow US | low | mandatory | 6 | approved | onsemi | BAV99LT1G
NODE_CORE | CMP_SENSOR_INPUT_PROTECT | PROTECTION | Per-channel ADC input clamp (BAV99 dual diode to 3V3/GND) with series protection resistor | Clamps ADC pin to rails on over-range/mis-wire; pairs with 100ohm series R and connector TVS. | Mouser India; element14 India; local authorized distributor | Mouser US; Digi-Key US; Arrow US | low | mandatory | 6 | approved | onsemi | BAV99LT1G
HUB_CORE | CMP_SENSOR_MODE_SELECT | SENSOR | Per-channel input mode-select jumper (1x3 header + shunt): V / I / D positions | Field-configurable per channel so installer picks 0-10V, 4-20mA or DI/pulse. | Mouser India; element14 India; local authorized distributor | Mouser US; Digi-Key US; Arrow US | low | mandatory | 6 | approved | Wurth Elektronik | 61300311121
NODE_CORE | CMP_SENSOR_MODE_SELECT | SENSOR | Per-channel input mode-select jumper (1x3 header + shunt): V / I / D positions | Field-configurable per channel so installer picks 0-10V, 4-20mA or DI/pulse. | Mouser India; element14 India; local authorized distributor | Mouser US; Digi-Key US; Arrow US | low | mandatory | 6 | approved | Wurth Elektronik | 61300311121
HUB_CORE | CMP_BUCK_IND_10UH | POWER | Power inductor 10uH for 12V->5V buck (TPS54531) | Sized ~10uH, >=6A sat / low DCR; verify against TPS54531 design at chosen fsw. | Mouser India; element14 India; local authorized distributor | Mouser US; Digi-Key US; Arrow US | low | mandatory | 1 | approved | Wurth Elektronik | 74437368100
NODE_CORE | CMP_BUCK_IND_10UH | POWER | Power inductor 10uH for 12V->5V buck (TPS54531) | Sized ~10uH, >=6A sat / low DCR; verify against TPS54531 design at chosen fsw. | Mouser India; element14 India; local authorized distributor | Mouser US; Digi-Key US; Arrow US | low | mandatory | 1 | approved | Wurth Elektronik | 74437368100
MOTOR_CONTROLLER | CMP_BUCK_IND_10UH | POWER | Power inductor 10uH for 12V->5V buck (TPS54531) | Sized ~10uH, >=6A sat / low DCR; verify against TPS54531 design at chosen fsw. | Mouser India; element14 India; local authorized distributor | Mouser US; Digi-Key US; Arrow US | low | mandatory | 1 | approved | Wurth Elektronik | 74437368100
HUB_CORE | CMP_BUCK_IND_2UH2 | POWER | Power inductor 2.2uH for 5V->3V3 buck (and 5V->3.8V modem buck on HUB) (TPS563201) | 2.2uH, >=4A sat; HUB uses 2 (3V3 + modem buck), NODE/MC use 1. | Mouser India; element14 India; local authorized distributor | Mouser US; Digi-Key US; Arrow US | low | mandatory | 2 | approved | Wurth Elektronik | 74438335022
NODE_CORE | CMP_BUCK_IND_2UH2 | POWER | Power inductor 2.2uH for 5V->3V3 buck (and 5V->3.8V modem buck on HUB) (TPS563201) | 2.2uH, >=4A sat; HUB uses 2 (3V3 + modem buck), NODE/MC use 1. | Mouser India; element14 India; local authorized distributor | Mouser US; Digi-Key US; Arrow US | low | mandatory | 1 | approved | Wurth Elektronik | 74438335022
MOTOR_CONTROLLER | CMP_BUCK_IND_2UH2 | POWER | Power inductor 2.2uH for 5V->3V3 buck (and 5V->3.8V modem buck on HUB) (TPS563201) | 2.2uH, >=4A sat; HUB uses 2 (3V3 + modem buck), NODE/MC use 1. | Mouser India; element14 India; local authorized distributor | Mouser US; Digi-Key US; Arrow US | low | mandatory | 1 | approved | Wurth Elektronik | 74438335022
HUB_CORE | CMP_REGULATOR_5V_TO_3V8_MODEM | POWER | 5V->3.8V buck for 4G modem VBAT (EG915U-CN); TPS563201 with FB set to 3.8V | Dedicated modem rail to isolate ~2A TX bursts from the 5V/3V3 rails. Reuses qualified TPS563201. | Mouser India; element14 India; local authorized distributor | Mouser US; Digi-Key US; Arrow US | low | mandatory | 1 | approved | Texas Instruments | TPS563201DDCR
HUB_CORE | CMP_MODEM_BULK_CAP | POWER | Modem VBAT bulk reservoir cap (470uF/16V low-ESR) for ~2A LTE TX bursts | Placed at EG915U VBAT pins to hold the rail during transmit bursts. | Mouser India; element14 India; local authorized distributor | Mouser US; Digi-Key US; Arrow US | low | mandatory | 1 | approved | Panasonic | EEE-FK1C471P
HUB_CORE | CMP_MODEM_LEVEL_SHIFTER | COMMUNICATION | 1.8V<->3.3V level translator for 4G modem interface (UART TX/RX + PWRKEY/RESET/STATUS) | EG915U I/O is 1.8V; TXS0108E recommended by Quectel. VCCA=modem VDD_EXT(1.8V), VCCB=3.3V. | Mouser India; element14 India; local authorized distributor | Mouser US; Digi-Key US; Arrow US | low | mandatory | 1 | approved | Texas Instruments | TXS0108EPWR

Sheet: Final_Component_RefDes
refdes | component_id | manufacturer | mpn | lifecycle_status | quantity | footprint | package | board_id | dnp | notes
TBD | CMP_MCU_ESP32S3 | Espressif | ESP32-S3-WROOM-1-N16R8 | candidate | 1 | TBD | TBD | HUB_CORE | TBD | Generated from BOM; no refdes assignment yet
TBD | CMP_RS485_TRANSCEIVER | Texas Instruments | THVD1450DR | candidate | 1 | TBD | TBD | HUB_CORE | TBD | Generated from BOM; no refdes assignment yet
TBD | CMP_REGULATOR_12V_TO_5V | Texas Instruments | TPS54531DDAR | candidate | 1 | TBD | TBD | HUB_CORE | TBD | Generated from BOM; no refdes assignment yet
TBD | CMP_REGULATOR_5V_TO_3V3 | Texas Instruments | TPS563201DDCR | candidate | 1 | TBD | TBD | HUB_CORE | TBD | Generated from BOM; no refdes assignment yet
TBD | CMP_SENSOR_FRONTEND_UNIVERSAL | SWAFarms | SWA-AFE-UNI-6CH (discrete network) | candidate | 6 | TBD | TBD | HUB_CORE | TBD | 2026-07-01: redefined from custom module to discrete per-channel network (SENSOR_FRONTEND_SPEC.md)
TBD | CMP_VALVE_DRIVER_CH | Texas Instruments | DRV8871DDAR | candidate | 6 | TBD | TBD | HUB_CORE | TBD | Generated from BOM; no refdes assignment yet
TBD | CMP_ESD_ARRAY | Nexperia | PESD2CANFD24VTQ | candidate | 4 | TBD | TBD | HUB_CORE | TBD | Generated from BOM; no refdes assignment yet
TBD | CMP_SURGE_PROTECTOR | Littelfuse | SMAJ24A | candidate | 1 | TBD | TBD | HUB_CORE | TBD | Generated from BOM; no refdes assignment yet
TBD | CMP_CELLULAR_MODEM_4G | Quectel | EG915U-CN | candidate | 1 | TBD | TBD | HUB_CORE | TBD | Generated from BOM; no refdes assignment yet
TBD | CMP_SIM_SLOT_NANO | Molex | 1041681620 | candidate | 1 | TBD | TBD | HUB_CORE | TBD | Generated from BOM; no refdes assignment yet
TBD | CMP_CELLULAR_ANTENNA | Taoglas | TG.30.8113 | candidate | 1 | TBD | TBD | HUB_CORE | TBD | Generated from BOM; no refdes assignment yet
TBD | CMP_MICROSD_SLOT | Molex | 1040310811 | candidate | 1 | TBD | TBD | HUB_CORE | TBD | Generated from BOM; no refdes assignment yet
TBD | CMP_RTC_IC | NXP | PCF8523T/1,118 | candidate | 1 | TBD | TBD | HUB_CORE | TBD | Generated from BOM; no refdes assignment yet
TBD | CMP_RTC_BACKUP | Eaton | KVR-5R0C105-R | candidate | 1 | TBD | TBD | HUB_CORE | TBD | Generated from BOM; no refdes assignment yet
TBD | CMP_INPUT_FUSE_PTC | Bourns | MF-R110 | candidate | 1 | TBD | TBD | HUB_CORE | TBD | Generated from BOM; no refdes assignment yet
TBD | CMP_INPUT_TVS | Littelfuse | SMBJ24A | candidate | 1 | TBD | TBD | HUB_CORE | TBD | Generated from BOM; no refdes assignment yet
TBD | CMP_POLARITY_PROTECT | Infineon | IPD50N06S4L-16 | candidate | 1 | TBD | TBD | HUB_CORE | TBD | Generated from BOM; no refdes assignment yet
TBD | CMP_EFUSE_UVLO_OVP | Texas Instruments | TPS26600PWPR | candidate | 1 | TBD | TBD | HUB_CORE | TBD | Generated from BOM; no refdes assignment yet
TBD | CMP_RS485_LINE_PROTECT | Littelfuse | SM712-02HTG | candidate | 1 | TBD | TBD | HUB_CORE | TBD | Generated from BOM; no refdes assignment yet
TBD | CMP_RS485_ISOLATOR | Texas Instruments | ISO1410BDWR | candidate | 1 | TBD | TBD | HUB_CORE | TBD | Generated from BOM; no refdes assignment yet
TBD | CMP_RS485_ISO_DCDC | Murata | NXE1S0505MC | candidate | 1 | TBD | TBD | HUB_CORE | TBD | Generated from BOM; no refdes assignment yet
TBD | CMP_RS485_TERM_SELECT | Vishay | CRCW0603120RFKEA | candidate | 1 | TBD | TBD | HUB_CORE | TBD | Generated from BOM; no refdes assignment yet
TBD | CMP_RS485_BIAS_NET | Vishay | CRCW0603680RFKEA | candidate | 1 | TBD | TBD | HUB_CORE | TBD | Generated from BOM; no refdes assignment yet
TBD | CMP_RS485_CMC | Wurth Elektronik | 744232090 | candidate | 1 | TBD | TBD | HUB_CORE | TBD | Generated from BOM; no refdes assignment yet
TBD | CMP_CONN_M12A_5P_RS485_PANEL | TE Connectivity | T4141412051-000 | candidate | 2 | TBD | TBD | HUB_CORE | TBD | Generated from BOM; no refdes assignment yet
TBD | CMP_CONN_M12A_4P_PWR12_PANEL | TE Connectivity | T4141412041-000 | candidate | 1 | TBD | TBD | HUB_CORE | TBD | Generated from BOM; no refdes assignment yet
TBD | CMP_CONN_TERM_6CH_SENSOR | Phoenix Contact | 1840409 | candidate | 2 | TBD | TBD | HUB_CORE | TBD | 2026-07-01: qty 2 (12 poles); refdes J_SENSORA + J_SENSORB; adds +12V loop supply for 4-20mA.
TBD | CMP_CONN_TERM_6CH_VALVE | Phoenix Contact | 1840412 | candidate | 2 | TBD | TBD | HUB_CORE | TBD | 2026-07-01: qty 2 (two 6-pos blocks) = 12 poles/6 valve pairs for H-bridge drive; refdes J_VALVEA + J_VALVEB.
TBD | CMP_CONN_SMA_BULKHEAD | Amphenol RF | 132134 | candidate | 1 | TBD | TBD | HUB_CORE | TBD | Generated from BOM; no refdes assignment yet
TBD | CMP_VALVE_LINE_CLAMP | Littelfuse | SMBJ33A | candidate | 6 | TBD | TBD | HUB_CORE | TBD | Generated from BOM; no refdes assignment yet
TBD | CMP_VALVE_FLYBACK_DIODE_CH | onsemi | ES1D | candidate | 6 | TBD | TBD | HUB_CORE | TBD | Generated from BOM; no refdes assignment yet
TBD | CMP_VALVE_GATE_NETWORK_CH | Yageo | RC0603FR-07100RL | candidate | 6 | TBD | TBD | HUB_CORE | TBD | Generated from BOM; no refdes assignment yet
TBD | CMP_VALVE_CURRENT_SENSE_CH | Bourns | CSS2H-2512R-L100F | candidate | 6 | TBD | TBD | HUB_CORE | TBD | Generated from BOM; no refdes assignment yet
TBD | CMP_LED_PWR | Kingbright | APT1608QBC-D | candidate | 1 | TBD | TBD | HUB_CORE | TBD | Generated from BOM; no refdes assignment yet
TBD | CMP_LED_STATUS | Kingbright | APT1608SGC | candidate | 1 | TBD | TBD | HUB_CORE | TBD | Generated from BOM; no refdes assignment yet
TBD | CMP_LED_LINK | Kingbright | APT1608SYCK | candidate | 1 | TBD | TBD | HUB_CORE | TBD | Generated from BOM; no refdes assignment yet
TBD | CMP_LED_RESISTOR_NET | Yageo | RC0603FR-071KL | candidate | 3 | TBD | TBD | HUB_CORE | TBD | Generated from BOM; no refdes assignment yet
TBD | CMP_BT_RADIO_INTEGRATED | Integrated | Integrated | approved | 1 | TBD | TBD | HUB_CORE | TBD | Generated from BOM; no refdes assignment yet
TBD | CMP_MCU_ESP32S3 | Espressif | ESP32-S3-WROOM-1-N16R8 | candidate | 1 | TBD | TBD | NODE_CORE | TBD | Generated from BOM; no refdes assignment yet
TBD | CMP_RS485_TRANSCEIVER | Texas Instruments | THVD1450DR | candidate | 2 | TBD | TBD | NODE_CORE | TBD | Generated from BOM; no refdes assignment yet
TBD | CMP_REGULATOR_12V_TO_5V | Texas Instruments | TPS54531DDAR | candidate | 1 | TBD | TBD | NODE_CORE | TBD | Generated from BOM; no refdes assignment yet
TBD | CMP_REGULATOR_5V_TO_3V3 | Texas Instruments | TPS563201DDCR | candidate | 1 | TBD | TBD | NODE_CORE | TBD | Generated from BOM; no refdes assignment yet
TBD | CMP_SENSOR_FRONTEND_UNIVERSAL | SWAFarms | SWA-AFE-UNI-6CH (discrete network) | candidate | 6 | TBD | TBD | NODE_CORE | TBD | 2026-07-01: redefined from custom module to discrete per-channel network (SENSOR_FRONTEND_SPEC.md)
TBD | CMP_VALVE_DRIVER_CH | Texas Instruments | DRV8871DDAR | candidate | 6 | TBD | TBD | NODE_CORE | TBD | Generated from BOM; no refdes assignment yet
TBD | CMP_ESD_ARRAY | Nexperia | PESD2CANFD24VTQ | candidate | 4 | TBD | TBD | NODE_CORE | TBD | Generated from BOM; no refdes assignment yet
TBD | CMP_SURGE_PROTECTOR | Littelfuse | SMAJ24A | candidate | 1 | TBD | TBD | NODE_CORE | TBD | Generated from BOM; no refdes assignment yet
TBD | CMP_INPUT_FUSE_PTC | Bourns | MF-R110 | candidate | 1 | TBD | TBD | NODE_CORE | TBD | Generated from BOM; no refdes assignment yet
TBD | CMP_INPUT_TVS | Littelfuse | SMBJ24A | candidate | 1 | TBD | TBD | NODE_CORE | TBD | Generated from BOM; no refdes assignment yet
TBD | CMP_POLARITY_PROTECT | Infineon | IPD50N06S4L-16 | candidate | 1 | TBD | TBD | NODE_CORE | TBD | Generated from BOM; no refdes assignment yet
TBD | CMP_EFUSE_UVLO_OVP | Texas Instruments | TPS26600PWPR | candidate | 1 | TBD | TBD | NODE_CORE | TBD | Generated from BOM; no refdes assignment yet
TBD | CMP_RS485_LINE_PROTECT | Littelfuse | SM712-02HTG | candidate | 2 | TBD | TBD | NODE_CORE | TBD | Generated from BOM; no refdes assignment yet
TBD | CMP_RS485_ISOLATOR | Texas Instruments | ISO1410BDWR | candidate | 1 | TBD | TBD | NODE_CORE | TBD | Generated from BOM; no refdes assignment yet
TBD | CMP_RS485_ISO_DCDC | Murata | NXE1S0505MC | candidate | 1 | TBD | TBD | NODE_CORE | TBD | Generated from BOM; no refdes assignment yet
TBD | CMP_RS485_TERM_SELECT | Vishay | CRCW0603120RFKEA | candidate | 2 | TBD | TBD | NODE_CORE | TBD | Generated from BOM; no refdes assignment yet
TBD | CMP_RS485_BIAS_NET | Vishay | CRCW0603680RFKEA | candidate | 2 | TBD | TBD | NODE_CORE | TBD | Generated from BOM; no refdes assignment yet
TBD | CMP_RS485_CMC | Wurth Elektronik | 744232090 | candidate | 2 | TBD | TBD | NODE_CORE | TBD | Generated from BOM; no refdes assignment yet
TBD | CMP_CONN_M12A_5P_RS485_PANEL | TE Connectivity | T4141412051-000 | candidate | 3 | TBD | TBD | NODE_CORE | TBD | Generated from BOM; no refdes assignment yet
TBD | CMP_CONN_M12A_4P_PWR12_PANEL | TE Connectivity | T4141412041-000 | candidate | 2 | TBD | TBD | NODE_CORE | TBD | Generated from BOM; no refdes assignment yet
TBD | CMP_CONN_TERM_6CH_SENSOR | Phoenix Contact | 1840409 | candidate | 2 | TBD | TBD | NODE_CORE | TBD | 2026-07-01: qty 2 (12 poles); refdes J_SENSORA + J_SENSORB; adds +12V loop supply for 4-20mA.
TBD | CMP_CONN_TERM_6CH_VALVE | Phoenix Contact | 1840412 | candidate | 2 | TBD | TBD | NODE_CORE | TBD | 2026-07-01: qty 2 (two 6-pos blocks) = 12 poles/6 valve pairs for H-bridge drive; refdes J_VALVEA + J_VALVEB.
TBD | CMP_CONN_SMA_BULKHEAD | Amphenol RF | 132134 | candidate | 1 | TBD | TBD | NODE_CORE | TBD | Generated from BOM; no refdes assignment yet
TBD | CMP_VALVE_LINE_CLAMP | Littelfuse | SMBJ33A | candidate | 6 | TBD | TBD | NODE_CORE | TBD | Generated from BOM; no refdes assignment yet
TBD | CMP_VALVE_FLYBACK_DIODE_CH | onsemi | ES1D | candidate | 6 | TBD | TBD | NODE_CORE | TBD | Generated from BOM; no refdes assignment yet
TBD | CMP_VALVE_GATE_NETWORK_CH | Yageo | RC0603FR-07100RL | candidate | 6 | TBD | TBD | NODE_CORE | TBD | Generated from BOM; no refdes assignment yet
TBD | CMP_VALVE_CURRENT_SENSE_CH | Bourns | CSS2H-2512R-L100F | candidate | 6 | TBD | TBD | NODE_CORE | TBD | Generated from BOM; no refdes assignment yet
TBD | CMP_LED_PWR | Kingbright | APT1608QBC-D | candidate | 1 | TBD | TBD | NODE_CORE | TBD | Generated from BOM; no refdes assignment yet
TBD | CMP_LED_LINK | Kingbright | APT1608SYCK | candidate | 1 | TBD | TBD | NODE_CORE | TBD | Generated from BOM; no refdes assignment yet
TBD | CMP_LED_RESISTOR_NET | Yageo | RC0603FR-071KL | candidate | 2 | TBD | TBD | NODE_CORE | TBD | Generated from BOM; no refdes assignment yet
TBD | CMP_BT_RADIO_INTEGRATED | Integrated | Integrated | approved | 1 | TBD | TBD | NODE_CORE | TBD | Generated from BOM; no refdes assignment yet
TBD | CMP_MCU_ESP32S3 | Espressif | ESP32-S3-WROOM-1-N16R8 | candidate | 1 | TBD | TBD | MOTOR_CONTROLLER | TBD | Generated from BOM; no refdes assignment yet
TBD | CMP_RS485_TRANSCEIVER | Texas Instruments | THVD1450DR | candidate | 1 | TBD | TBD | MOTOR_CONTROLLER | TBD | Generated from BOM; no refdes assignment yet
TBD | CMP_REGULATOR_12V_TO_5V | Texas Instruments | TPS54531DDAR | candidate | 1 | TBD | TBD | MOTOR_CONTROLLER | TBD | Generated from BOM; no refdes assignment yet
TBD | CMP_REGULATOR_5V_TO_3V3 | Texas Instruments | TPS563201DDCR | candidate | 1 | TBD | TBD | MOTOR_CONTROLLER | TBD | Generated from BOM; no refdes assignment yet
TBD | CMP_ESD_ARRAY | Nexperia | PESD2CANFD24VTQ | candidate | 3 | TBD | TBD | MOTOR_CONTROLLER | TBD | Generated from BOM; no refdes assignment yet
TBD | CMP_SURGE_PROTECTOR | Littelfuse | SMAJ24A | candidate | 1 | TBD | TBD | MOTOR_CONTROLLER | TBD | Generated from BOM; no refdes assignment yet
TBD | CMP_INPUT_FUSE_PTC | Bourns | MF-R110 | candidate | 1 | TBD | TBD | MOTOR_CONTROLLER | TBD | Generated from BOM; no refdes assignment yet
TBD | CMP_INPUT_TVS | Littelfuse | SMBJ24A | candidate | 1 | TBD | TBD | MOTOR_CONTROLLER | TBD | Generated from BOM; no refdes assignment yet
TBD | CMP_POLARITY_PROTECT | Infineon | IPD50N06S4L-16 | candidate | 1 | TBD | TBD | MOTOR_CONTROLLER | TBD | Generated from BOM; no refdes assignment yet
TBD | CMP_EFUSE_UVLO_OVP | Texas Instruments | TPS26600PWPR | candidate | 1 | TBD | TBD | MOTOR_CONTROLLER | TBD | Generated from BOM; no refdes assignment yet
TBD | CMP_RS485_LINE_PROTECT | Littelfuse | SM712-02HTG | candidate | 1 | TBD | TBD | MOTOR_CONTROLLER | TBD | Generated from BOM; no refdes assignment yet
TBD | CMP_RS485_ISOLATOR | Texas Instruments | ISO1410BDWR | candidate | 1 | TBD | TBD | MOTOR_CONTROLLER | TBD | Generated from BOM; no refdes assignment yet
TBD | CMP_RS485_ISO_DCDC | Murata | NXE1S0505MC | candidate | 1 | TBD | TBD | MOTOR_CONTROLLER | TBD | Generated from BOM; no refdes assignment yet
TBD | CMP_RS485_TERM_SELECT | Vishay | CRCW0603120RFKEA | candidate | 1 | TBD | TBD | MOTOR_CONTROLLER | TBD | Generated from BOM; no refdes assignment yet
TBD | CMP_RS485_BIAS_NET | Vishay | CRCW0603680RFKEA | candidate | 1 | TBD | TBD | MOTOR_CONTROLLER | TBD | Generated from BOM; no refdes assignment yet
TBD | CMP_RS485_CMC | Wurth Elektronik | 744232090 | candidate | 1 | TBD | TBD | MOTOR_CONTROLLER | TBD | Generated from BOM; no refdes assignment yet
TBD | CMP_MOTOR_IO_ISOLATOR | Broadcom | ACPL-247-500E | candidate | 1 | TBD | TBD | MOTOR_CONTROLLER | TBD | Generated from BOM; no refdes assignment yet
TBD | CMP_CONN_M12A_5P_RS485_PANEL | TE Connectivity | T4141412051-000 | candidate | 2 | TBD | TBD | MOTOR_CONTROLLER | TBD | Generated from BOM; no refdes assignment yet
TBD | CMP_CONN_M12A_4P_PWR12_PANEL | TE Connectivity | T4141412041-000 | candidate | 1 | TBD | TBD | MOTOR_CONTROLLER | TBD | Generated from BOM; no refdes assignment yet
TBD | CMP_CONN_TERM_STARTER_IO | Phoenix Contact | 1777992 | candidate | 1 | TBD | TBD | MOTOR_CONTROLLER | TBD | Generated from BOM; no refdes assignment yet
TBD | CMP_LED_PWR | Kingbright | APT1608QBC-D | candidate | 1 | TBD | TBD | MOTOR_CONTROLLER | TBD | Generated from BOM; no refdes assignment yet
TBD | CMP_LED_LINK | Kingbright | APT1608SYCK | candidate | 1 | TBD | TBD | MOTOR_CONTROLLER | TBD | Generated from BOM; no refdes assignment yet
TBD | CMP_LED_FAULT | Kingbright | APT1608SURCK | candidate | 1 | TBD | TBD | MOTOR_CONTROLLER | TBD | Generated from BOM; no refdes assignment yet
TBD | CMP_LED_RESISTOR_NET | Yageo | RC0603FR-071KL | candidate | 3 | TBD | TBD | MOTOR_CONTROLLER | TBD | Generated from BOM; no refdes assignment yet
TBD | CMP_BT_RADIO_INTEGRATED | Integrated | Integrated | approved | 1 | TBD | TBD | MOTOR_CONTROLLER | TBD | Generated from BOM; no refdes assignment yet
TBD | CMP_LORA_MODULE_IN865 | RAKwireless | RAK3172 | candidate | 1 | TBD | TBD | LORA_MODULE_ADDON | TBD | Generated from BOM; no refdes assignment yet
TBD | CMP_LED_LINK | Kingbright | APT1608SYCK | candidate | 1 | TBD | TBD | LORA_MODULE_ADDON | TBD | Generated from BOM; no refdes assignment yet
TBD | CMP_LED_RESISTOR_NET | Yageo | RC0603FR-071KL | candidate | 1 | TBD | TBD | LORA_MODULE_ADDON | TBD | Generated from BOM; no refdes assignment yet
TBD | CMP_ESD_ARRAY | Nexperia | PESD2CANFD24VTQ | candidate | 1 | TBD | TBD | LORA_MODULE_ADDON | TBD | Generated from BOM; no refdes assignment yet
TBD | CMP_MATE_M12A_5P_RS485_CABLE | Phoenix Contact | 1408860 | candidate | 8 | TBD | TBD | TEST_FIELD_KIT | TBD | Generated from BOM; no refdes assignment yet
TBD | CMP_MATE_M12A_4P_PWR12_CABLE | Phoenix Contact | 1408872 | candidate | 8 | TBD | TBD | TEST_FIELD_KIT | TBD | Generated from BOM; no refdes assignment yet
TBD | CMP_MATE_TERM_6CH_SENSOR_PLUG | Phoenix Contact | 1757242 | candidate | 6 | TBD | TBD | TEST_FIELD_KIT | TBD | Generated from BOM; no refdes assignment yet
TBD | CMP_MATE_TERM_6CH_VALVE_PLUG | Phoenix Contact | 1757243 | candidate | 6 | TBD | TBD | TEST_FIELD_KIT | TBD | Generated from BOM; no refdes assignment yet
TBD | CMP_MATE_TERM_STARTER_IO_PLUG | Phoenix Contact | 1777976 | candidate | 2 | TBD | TBD | TEST_FIELD_KIT | TBD | Generated from BOM; no refdes assignment yet
TBD | CMP_TEST_SENSOR_SOIL_MOISTURE_4_20MA | DFRobot | SEN0257 | candidate | 4 | TBD | TBD | TEST_FIELD_KIT | TBD | Generated from BOM; no refdes assignment yet
TBD | CMP_TEST_SENSOR_PRESSURE_4_20MA | AutomationDirect | PTLV-4A-15 | candidate | 2 | TBD | TBD | TEST_FIELD_KIT | TBD | Generated from BOM; no refdes assignment yet
TBD | CMP_TEST_SENSOR_FLOW_PULSE | Seeed Studio | 314150005 | candidate | 2 | TBD | TBD | TEST_FIELD_KIT | TBD | Generated from BOM; no refdes assignment yet
TBD | CMP_TEST_SENSOR_LEVEL_0_10V | Dwyer | 616KD-11-V | candidate | 2 | TBD | TBD | TEST_FIELD_KIT | TBD | Generated from BOM; no refdes assignment yet
TBD | CMP_TEST_SWITCH_FLOAT_DI | Madison | M8000 | candidate | 2 | TBD | TBD | TEST_FIELD_KIT | TBD | Generated from BOM; no refdes assignment yet
TBD | CMP_TEST_VALVE_SOLENOID_12V | Hunter | 606800 | candidate | 6 | TBD | TBD | TEST_FIELD_KIT | TBD | Generated from BOM; no refdes assignment yet
TBD | CMP_VALVE_HBRIDGE_SPI_EXPANDER | Microchip | MCP23S17-E/SS | approved | 1 | TBD | TBD | HUB_CORE | NO | Added 2026-07-01 for latching valve driver subsystem
TBD | CMP_VALVE_HBRIDGE_SPI_EXPANDER | Microchip | MCP23S17-E/SS | approved | 1 | TBD | TBD | NODE_CORE | NO | Added 2026-07-01 for latching valve driver subsystem
TBD | CMP_VALVE_PULSE_BULK_CAP | Panasonic | EEU-FR1E102 | approved | 1 | TBD | TBD | HUB_CORE | NO | Added 2026-07-01 for latching valve driver subsystem
TBD | CMP_VALVE_PULSE_BULK_CAP | Panasonic | EEU-FR1E102 | approved | 1 | TBD | TBD | NODE_CORE | NO | Added 2026-07-01 for latching valve driver subsystem
TBD | CMP_SENSOR_BURDEN_R | Yageo | RT0805BRD07150RL | approved | 6 | TBD | TBD | HUB_CORE | NO | Added 2026-07-01 - universal sensor frontend (SENSOR_FRONTEND_SPEC.md)
TBD | CMP_SENSOR_BURDEN_R | Yageo | RT0805BRD07150RL | approved | 6 | TBD | TBD | NODE_CORE | NO | Added 2026-07-01 - universal sensor frontend (SENSOR_FRONTEND_SPEC.md)
TBD | CMP_SENSOR_INPUT_PROTECT | onsemi | BAV99LT1G | approved | 6 | TBD | TBD | HUB_CORE | NO | Added 2026-07-01 - universal sensor frontend (SENSOR_FRONTEND_SPEC.md)
TBD | CMP_SENSOR_INPUT_PROTECT | onsemi | BAV99LT1G | approved | 6 | TBD | TBD | NODE_CORE | NO | Added 2026-07-01 - universal sensor frontend (SENSOR_FRONTEND_SPEC.md)
TBD | CMP_SENSOR_MODE_SELECT | Wurth Elektronik | 61300311121 | approved | 6 | TBD | TBD | HUB_CORE | NO | Added 2026-07-01 - universal sensor frontend (SENSOR_FRONTEND_SPEC.md)
TBD | CMP_SENSOR_MODE_SELECT | Wurth Elektronik | 61300311121 | approved | 6 | TBD | TBD | NODE_CORE | NO | Added 2026-07-01 - universal sensor frontend (SENSOR_FRONTEND_SPEC.md)
TBD | CMP_BUCK_IND_10UH | Wurth Elektronik | 74437368100 | approved | 1 | TBD | TBD | HUB_CORE | NO | Added 2026-07-01 - power tree (POWER_TREE_SPEC.md)
TBD | CMP_BUCK_IND_10UH | Wurth Elektronik | 74437368100 | approved | 1 | TBD | TBD | NODE_CORE | NO | Added 2026-07-01 - power tree (POWER_TREE_SPEC.md)
TBD | CMP_BUCK_IND_10UH | Wurth Elektronik | 74437368100 | approved | 1 | TBD | TBD | MOTOR_CONTROLLER | NO | Added 2026-07-01 - power tree (POWER_TREE_SPEC.md)
TBD | CMP_BUCK_IND_2UH2 | Wurth Elektronik | 74438335022 | approved | 2 | TBD | TBD | HUB_CORE | NO | Added 2026-07-01 - power tree (POWER_TREE_SPEC.md)
TBD | CMP_BUCK_IND_2UH2 | Wurth Elektronik | 74438335022 | approved | 1 | TBD | TBD | NODE_CORE | NO | Added 2026-07-01 - power tree (POWER_TREE_SPEC.md)
TBD | CMP_BUCK_IND_2UH2 | Wurth Elektronik | 74438335022 | approved | 1 | TBD | TBD | MOTOR_CONTROLLER | NO | Added 2026-07-01 - power tree (POWER_TREE_SPEC.md)
TBD | CMP_REGULATOR_5V_TO_3V8_MODEM | Texas Instruments | TPS563201DDCR | approved | 1 | TBD | TBD | HUB_CORE | NO | Added 2026-07-01 - power tree (POWER_TREE_SPEC.md)
TBD | CMP_MODEM_BULK_CAP | Panasonic | EEE-FK1C471P | approved | 1 | TBD | TBD | HUB_CORE | NO | Added 2026-07-01 - power tree (POWER_TREE_SPEC.md)
TBD | CMP_MODEM_LEVEL_SHIFTER | Texas Instruments | TXS0108EPWR | approved | 1 | TBD | TBD | HUB_CORE | NO | Added 2026-07-01 - power tree (POWER_TREE_SPEC.md)

Sheet: Footprint_Library_Map
component_id | manufacturer | mpn | device_id | category | footprint_name | package_name | library_name | model_3d | alternate_parts | population_status | review_status | notes
CMP_BT_RADIO_INTEGRATED | Integrated | Integrated | HUB_CORE | RF | N/A_INTEGRATED_IN_MCU | INTEGRATED_IN_ESP32S3 | N/A | N/A | TBD | BASELINE_REVIEW | N/A | From BOM; CAD fields set to TBD unless explicitly defined in workbook.
CMP_CELLULAR_ANTENNA | Taoglas | TG.30.8113 | HUB_CORE | RF | ANTENNA_FLEX_FPC_EXTERNAL | FPC_ANTENNA_EXTERNAL | N/A | N/A | TBD | PROVISIONAL_REVIEW | N/A | From BOM; CAD fields set to TBD unless explicitly defined in workbook.
CMP_CELLULAR_MODEM_4G | Quectel | EG915U-CN | HUB_CORE | COMMUNICATION | Quectel_EG915U-CN_LCC-66 | LCC-66_MODULE_27.6x22.8mm | SWA_Custom | PENDING_PCB_ENGINEER | TBD | PROVISIONAL_REVIEW | PENDING_PCB_REVIEW | Changed EG915U-EU->EG915U-CN (2026-07-01) for India bands B40/B41; same EG915U series LCC-66 package, pin/footprint compatible - confirm vs EG915U-CN datasheet before fab.
CMP_CONN_M12A_4P_PWR12_PANEL | TE Connectivity | T4141412041-000 | HUB_CORE | CONNECTOR | TE_M12A_4P_T4141412041_Panel | M12_PANEL_MOUNT_4P | Connector_TE-Connectivity | PENDING_PCB_ENGINEER | Phoenix Contact: 1419756; Amphenol LTW: M12A-04PMMP-SF8001 | PROVISIONAL_REVIEW | PENDING_PCB_REVIEW | From BOM; CAD fields set to TBD unless explicitly defined in workbook. US alternates linked.
CMP_CONN_M12A_5P_RS485_PANEL | TE Connectivity | T4141412051-000 | HUB_CORE | CONNECTOR | TE_M12A_5P_T4141412051_Panel | M12_PANEL_MOUNT_5P | Connector_TE-Connectivity | PENDING_PCB_ENGINEER | Phoenix Contact: 1419758; Amphenol LTW: M12A-05PMMP-SF8001 | PROVISIONAL_REVIEW | PENDING_PCB_REVIEW | From BOM; CAD fields set to TBD unless explicitly defined in workbook. US alternates linked.
CMP_CONN_SMA_BULKHEAD | Amphenol RF | 132134 | HUB_CORE | CONNECTOR | Connector_Coaxial_SMA_Bulkhead | SMA_BULKHEAD_PANEL | Connector_Coaxial | PENDING_PCB_ENGINEER | TBD | OPTIONAL_LORA_REVIEW | PENDING_PCB_REVIEW | From BOM; CAD fields set to TBD unless explicitly defined in workbook.
CMP_CONN_TERM_6CH_SENSOR | Phoenix Contact | 1840409 | HUB_CORE | CONNECTOR | Phoenix_MC_1.5-GF-3.5_1x06_P3.5mm | THT_TERMINAL_1x06_P3.5mm | Connector_Phoenix_MC | ${KICAD6_3DMODEL_DIR}/Connector_Phoenix_MC.3dshapes/Phoenix_MC_1.5-GF-3.5_1x06_P3.5mm_Vertical.wrl | Wurth Elektronik: 691216710002; Molex: 395300006 | PROVISIONAL_REVIEW | PENDING_PCB_REVIEW | 2026-07-01: placed 2x per board (12 poles) - adds 4-20mA loop supply + GND.
CMP_CONN_TERM_6CH_VALVE | Phoenix Contact | 1840412 | HUB_CORE | CONNECTOR | Phoenix_MC_1.5-GF-3.5_1x06_P3.5mm | THT_TERMINAL_1x06_P3.5mm | Connector_Phoenix_MC | ${KICAD6_3DMODEL_DIR}/Connector_Phoenix_MC.3dshapes/Phoenix_MC_1.5-GF-3.5_1x06_P3.5mm_Vertical.wrl | Wurth Elektronik: 691216710002; Molex: 395300006 | PROVISIONAL_REVIEW | PENDING_PCB_REVIEW | 2026-07-01: placed 2x per board (12 poles = 6 valve pairs) for H-bridge latching drive.
CMP_CONN_TERM_STARTER_IO | Phoenix Contact | 1777992 | MOTOR_CONTROLLER | CONNECTOR | Phoenix_MC_1.5-GF-3.5_1x10_P3.5mm | THT_TERMINAL_1x10_P3.5mm | Connector_Phoenix_MC | ${KICAD6_3DMODEL_DIR}/Connector_Phoenix_MC.3dshapes/Phoenix_MC_1.5-GF-3.5_1x10_P3.5mm_Vertical.wrl | TBD | PROVISIONAL_REVIEW | PENDING_PCB_REVIEW | From BOM; CAD fields set to TBD unless explicitly defined in workbook.
CMP_EFUSE_UVLO_OVP | Texas Instruments | TPS26600PWPR | HUB_CORE | PROTECTION | Texas_Instruments_HTSSOP-16_PowerPad | HTSSOP-16 | Package_SO | ${KICAD6_3DMODEL_DIR}/Package_SO.3dshapes/HTSSOP-16.wrl | TBD | PROVISIONAL_REVIEW | PENDING_PCB_REVIEW | From BOM; CAD fields set to TBD unless explicitly defined in workbook.
CMP_ESD_ARRAY | Nexperia | PESD2CANFD24VTQ | HUB_CORE | PROTECTION | SOT-363_SC-70-6 | SOT-363_SC70-6 | Package_SOT-23 | ${KICAD6_3DMODEL_DIR}/Package_SOT-23.3dshapes/SOT-363.wrl | TBD | PROVISIONAL_REVIEW | PENDING_PCB_REVIEW | From BOM; CAD fields set to TBD unless explicitly defined in workbook.
CMP_INPUT_FUSE_PTC | Bourns | MF-R110 | HUB_CORE | PROTECTION | Fuse_1210_3225Metric | SMD_1210 | Fuse | ${KICAD6_3DMODEL_DIR}/Fuse.3dshapes/Fuse_1210_3225Metric.wrl | TBD | PROVISIONAL_REVIEW | PENDING_PCB_REVIEW | From BOM; CAD fields set to TBD unless explicitly defined in workbook.
CMP_INPUT_TVS | Littelfuse | SMBJ24A | HUB_CORE | PROTECTION | D_SMB | DO-214AA_SMB | Diode_SMD | ${KICAD6_3DMODEL_DIR}/Diode_SMD.3dshapes/D_SMB.wrl | TBD | PROVISIONAL_REVIEW | PENDING_PCB_REVIEW | From BOM; CAD fields set to TBD unless explicitly defined in workbook.
CMP_LED_FAULT | Kingbright | APT1608SURCK | MOTOR_CONTROLLER | UI_INDICATOR | LED_0603_1608Metric | SMD_0603 | LED_SMD | ${KICAD6_3DMODEL_DIR}/LED_SMD.3dshapes/LED_0603_1608Metric.wrl | TBD | RECOMMENDED_REVIEW | PENDING_PCB_REVIEW | From BOM; CAD fields set to TBD unless explicitly defined in workbook.
CMP_LED_LINK | Kingbright | APT1608SYCK | HUB_CORE | UI_INDICATOR | LED_0603_1608Metric | SMD_0603 | LED_SMD | ${KICAD6_3DMODEL_DIR}/LED_SMD.3dshapes/LED_0603_1608Metric.wrl | TBD | PROVISIONAL_REVIEW | PENDING_PCB_REVIEW | From BOM; CAD fields set to TBD unless explicitly defined in workbook.
CMP_LED_PWR | Kingbright | APT1608QBC-D | HUB_CORE | UI_INDICATOR | LED_0603_1608Metric | SMD_0603 | LED_SMD | ${KICAD6_3DMODEL_DIR}/LED_SMD.3dshapes/LED_0603_1608Metric.wrl | TBD | PROVISIONAL_REVIEW | PENDING_PCB_REVIEW | From BOM; CAD fields set to TBD unless explicitly defined in workbook.
CMP_LED_RESISTOR_NET | Yageo | RC0603FR-071KL | HUB_CORE | UI_INDICATOR | R_0603_1608Metric | SMD_0603 | Resistor_SMD | ${KICAD6_3DMODEL_DIR}/Resistor_SMD.3dshapes/R_0603_1608Metric.wrl | TBD | PROVISIONAL_REVIEW | PENDING_PCB_REVIEW | From BOM; CAD fields set to TBD unless explicitly defined in workbook.
CMP_LED_STATUS | Kingbright | APT1608SGC | HUB_CORE | UI_INDICATOR | LED_0603_1608Metric | SMD_0603 | LED_SMD | ${KICAD6_3DMODEL_DIR}/LED_SMD.3dshapes/LED_0603_1608Metric.wrl | TBD | RECOMMENDED_REVIEW | PENDING_PCB_REVIEW | From BOM; CAD fields set to TBD unless explicitly defined in workbook.
CMP_LORA_MODULE_IN865 | RAKwireless | RAK3172 | LORA_MODULE_ADDON | RF_MODULE | RAK3172_SIP_2x11_P2.0mm | SIP_22P_2x11_P2.0MM | SWA_Custom | PENDING_PCB_ENGINEER | Seeed: Wio-E5; LilyGO: T3-S3-LR1110 | OPTIONAL_LORA_REVIEW | PENDING_PCB_REVIEW | From BOM; CAD fields set to TBD unless explicitly defined in workbook. US alternates linked.
CMP_MATE_M12A_4P_PWR12_CABLE | Phoenix Contact | 1408872 | TEST_FIELD_KIT | TEST_ACCESSORY | N/A | EXTERNAL_CABLE_M12A_4P | N/A | N/A | TBD | PROVISIONAL_REVIEW | N/A | From BOM; CAD fields set to TBD unless explicitly defined in workbook.
CMP_MATE_M12A_5P_RS485_CABLE | Phoenix Contact | 1408860 | TEST_FIELD_KIT | TEST_ACCESSORY | N/A | EXTERNAL_CABLE_M12A_5P | N/A | N/A | TBD | PROVISIONAL_REVIEW | N/A | From BOM; CAD fields set to TBD unless explicitly defined in workbook.
CMP_MATE_TERM_6CH_SENSOR_PLUG | Phoenix Contact | 1757242 | TEST_FIELD_KIT | TEST_ACCESSORY | N/A | EXTERNAL_PLUG_6P_3.5MM | N/A | N/A | TBD | PROVISIONAL_REVIEW | N/A | From BOM; CAD fields set to TBD unless explicitly defined in workbook.
CMP_MATE_TERM_6CH_VALVE_PLUG | Phoenix Contact | 1757243 | TEST_FIELD_KIT | TEST_ACCESSORY | N/A | EXTERNAL_PLUG_6P_3.5MM | N/A | N/A | TBD | PROVISIONAL_REVIEW | N/A | From BOM; CAD fields set to TBD unless explicitly defined in workbook.
CMP_MATE_TERM_STARTER_IO_PLUG | Phoenix Contact | 1777976 | TEST_FIELD_KIT | TEST_ACCESSORY | N/A | EXTERNAL_PLUG_10P_3.5MM | N/A | N/A | TBD | PROVISIONAL_REVIEW | N/A | From BOM; CAD fields set to TBD unless explicitly defined in workbook.
CMP_MCU_ESP32S3 | Espressif | ESP32-S3-WROOM-1-N16R8 | HUB_CORE | MCU | ESP32-S3-WROOM-1 | MODULE_LGA_38P_18x20mm | RF_Module | ${KICAD6_3DMODEL_DIR}/RF_Module.3dshapes/ESP32-S3-WROOM-1.wrl | Espressif: ESP32-S3-WROOM-1-N8R2; Espressif: ESP32-S3-WROOM-1-N16R8V | PROVISIONAL_REVIEW | PENDING_PCB_REVIEW | From BOM; CAD fields set to TBD unless explicitly defined in workbook. US alternates linked.
CMP_MICROSD_SLOT | Molex | 1040310811 | HUB_CORE | STORAGE | Molex_MicroSD_1040310811 | SMD_MICROSD_PUSH-PUSH | Connector_Card | PENDING_PCB_ENGINEER | TBD | PROVISIONAL_REVIEW | PENDING_PCB_REVIEW | From BOM; CAD fields set to TBD unless explicitly defined in workbook.
CMP_MOTOR_IO_ISOLATOR | Broadcom | ACPL-247-500E | MOTOR_CONTROLLER | PROTECTION | SOIC-8_3.9x4.9mm_P1.27mm | SOIC-8 | Package_SO | ${KICAD6_3DMODEL_DIR}/Package_SO.3dshapes/SOIC-8_3.9x4.9mm_P1.27mm.wrl | TBD | PROVISIONAL_REVIEW | PENDING_PCB_REVIEW | From BOM; CAD fields set to TBD unless explicitly defined in workbook.
CMP_POLARITY_PROTECT | Infineon | IPD50N06S4L-16 | HUB_CORE | PROTECTION | DPAK_TO-252-3_Vertical | TO-252-3_DPAK | Package_TO_SOT_SMD | ${KICAD6_3DMODEL_DIR}/Package_TO_SOT_SMD.3dshapes/DPAK-3_Vertical.wrl | TBD | PROVISIONAL_REVIEW | PENDING_PCB_REVIEW | From BOM; CAD fields set to TBD unless explicitly defined in workbook.
CMP_REGULATOR_12V_TO_5V | Texas Instruments | TPS54531DDAR | HUB_CORE | POWER | SOIC-8_3.9x4.9mm_P1.27mm_PowerPad | SOIC-8_EP | Package_SO | ${KICAD6_3DMODEL_DIR}/Package_SO.3dshapes/SOIC-8_3.9x4.9mm_P1.27mm.wrl | Texas Instruments: LM2596S-5.0/NOPB; Monolithic Power Systems: MP1584EN-LF-Z | PROVISIONAL_REVIEW | PENDING_PCB_REVIEW | From BOM; CAD fields set to TBD unless explicitly defined in workbook. US alternates linked.
CMP_REGULATOR_5V_TO_3V3 | Texas Instruments | TPS563201DDCR | HUB_CORE | POWER | SOT-23-6_1.6x2.9mm_P0.95mm | SOT-23-6 | Package_TO_SOT_SMD | ${KICAD6_3DMODEL_DIR}/Package_TO_SOT_SMD.3dshapes/SOT-23-6.wrl | Texas Instruments: TPS562201DDCR (2A, pin-compatible); Texas Instruments: TPS563208DDCR (low-ripple, pin-compatible) | PROVISIONAL_REVIEW | PENDING_PCB_REVIEW | Changed LDO TLV76733 (SOT-23-5) -> buck TPS563201DDCR (SOT-23-6) 2026-07-01 for thermal/brownout headroom. Buck REQUIRES support passives (2.2uH inductor + feedback divider + output cap) added at schematic capture - same convention as 12V->5V buck.
CMP_RS485_BIAS_NET | Vishay | CRCW0603680RFKEA | HUB_CORE | COMMUNICATION | R_0603_1608Metric | SMD_0603 | Resistor_SMD | ${KICAD6_3DMODEL_DIR}/Resistor_SMD.3dshapes/R_0603_1608Metric.wrl | TBD | PROVISIONAL_REVIEW | PENDING_PCB_REVIEW | From BOM; CAD fields set to TBD unless explicitly defined in workbook.
CMP_RS485_CMC | Wurth Elektronik | 744232090 | HUB_CORE | COMMUNICATION | L_1210_3225Metric | SMD_1210 | Inductor_SMD | ${KICAD6_3DMODEL_DIR}/Inductor_SMD.3dshapes/L_1210_3225Metric.wrl | TBD | PROVISIONAL_REVIEW | PENDING_PCB_REVIEW | From BOM; CAD fields set to TBD unless explicitly defined in workbook.
CMP_RS485_ISO_DCDC | Murata | NXE1S0505MC | HUB_CORE | COMMUNICATION | Murata_NXE1S0505MC_SIP-7_P2.54mm | SIP-7_P2.54mm | SWA_Custom | PENDING_PCB_ENGINEER | TBD | PROVISIONAL_REVIEW | PENDING_PCB_REVIEW | From BOM; CAD fields set to TBD unless explicitly defined in workbook.
CMP_RS485_ISOLATOR | Texas Instruments | ISO1410BDWR | HUB_CORE | COMMUNICATION | SOIC-16_3.9x9.9mm_P1.27mm | SOIC-16 | Package_SO | ${KICAD6_3DMODEL_DIR}/Package_SO.3dshapes/SOIC-16_3.9x9.9mm_P1.27mm.wrl | TBD | PROVISIONAL_REVIEW | PENDING_PCB_REVIEW | From BOM; CAD fields set to TBD unless explicitly defined in workbook.
CMP_RS485_LINE_PROTECT | Littelfuse | SM712-02HTG | HUB_CORE | PROTECTION | SOT-23-6_1.65x3mm_P0.95mm | SOT-23-6 | Package_SOT-23 | ${KICAD6_3DMODEL_DIR}/Package_SOT-23.3dshapes/SOT-23-6.wrl | TBD | PROVISIONAL_REVIEW | PENDING_PCB_REVIEW | From BOM; CAD fields set to TBD unless explicitly defined in workbook.
CMP_RS485_TERM_SELECT | Vishay | CRCW0603120RFKEA | HUB_CORE | COMMUNICATION | R_0603_1608Metric | SMD_0603 | Resistor_SMD | ${KICAD6_3DMODEL_DIR}/Resistor_SMD.3dshapes/R_0603_1608Metric.wrl | TBD | PROVISIONAL_REVIEW | PENDING_PCB_REVIEW | From BOM; CAD fields set to TBD unless explicitly defined in workbook.
CMP_RS485_TRANSCEIVER | Texas Instruments | THVD1450DR | HUB_CORE | COMMUNICATION | SOIC-8_3.9x4.9mm_P1.27mm | SOIC-8 | Package_SO | ${KICAD6_3DMODEL_DIR}/Package_SO.3dshapes/SOIC-8_3.9x4.9mm_P1.27mm.wrl | Maxim: MAX3485ESA+T; Texas Instruments: SN65HVD1781DR | PROVISIONAL_REVIEW | PENDING_PCB_REVIEW | From BOM; CAD fields set to TBD unless explicitly defined in workbook. US alternates linked.
CMP_RTC_BACKUP | Eaton | KVR-5R0C105-R | HUB_CORE | TIMING | CP_Elna_KVR_D10.0mm_P5.0mm | SMD_SUPERCAP_D10MM | Capacitor_SMD | PENDING_PCB_ENGINEER | TBD | PROVISIONAL_REVIEW | PENDING_PCB_REVIEW | From BOM; CAD fields set to TBD unless explicitly defined in workbook.
CMP_RTC_IC | NXP | PCF8523T/1,118 | HUB_CORE | TIMING | SOIC-8_3.9x4.9mm_P1.27mm | SOIC-8 | Package_SO | ${KICAD6_3DMODEL_DIR}/Package_SO.3dshapes/SOIC-8_3.9x4.9mm_P1.27mm.wrl | TBD | PROVISIONAL_REVIEW | PENDING_PCB_REVIEW | From BOM; CAD fields set to TBD unless explicitly defined in workbook.
CMP_SENSOR_FRONTEND_UNIVERSAL | SWAFarms | SWA-AFE-UNI-6CH (discrete network) | HUB_CORE | ANALOG_FRONTEND | DISCRETE_PER_CHANNEL_NETWORK | DISCRETE (R/C 0805 + jumper) | Device | PENDING_PCB_ENGINEER | TBD | ACTIVE | PENDING_PCB_REVIEW | 2026-07-01: no longer a custom module; discrete network per SENSOR_FRONTEND_SPEC.md.
CMP_SIM_SLOT_NANO | Molex | 1041681620 | HUB_CORE | COMMUNICATION | Molex_1041681620_nanoSIM_Push-Push | SMD_NANOSIM_PUSH-PUSH | Connector_Card | PENDING_PCB_ENGINEER | TBD | PROVISIONAL_REVIEW | PENDING_PCB_REVIEW | From BOM; CAD fields set to TBD unless explicitly defined in workbook.
CMP_SURGE_PROTECTOR | Littelfuse | SMAJ24A | HUB_CORE | PROTECTION | D_SMA | DO-214AC_SMA | Diode_SMD | ${KICAD6_3DMODEL_DIR}/Diode_SMD.3dshapes/D_SMA.wrl | TBD | PROVISIONAL_REVIEW | PENDING_PCB_REVIEW | From BOM; CAD fields set to TBD unless explicitly defined in workbook.
CMP_TEST_SENSOR_FLOW_PULSE | Seeed Studio | 314150005 | TEST_FIELD_KIT | TEST_ACCESSORY | N/A | EXTERNAL_TEST_SENSOR | N/A | N/A | TBD | RECOMMENDED_REVIEW | N/A | From BOM; CAD fields set to TBD unless explicitly defined in workbook.
CMP_TEST_SENSOR_LEVEL_0_10V | Dwyer | 616KD-11-V | TEST_FIELD_KIT | TEST_ACCESSORY | N/A | EXTERNAL_TEST_SENSOR | N/A | N/A | TBD | RECOMMENDED_REVIEW | N/A | From BOM; CAD fields set to TBD unless explicitly defined in workbook.
CMP_TEST_SENSOR_PRESSURE_4_20MA | AutomationDirect | PTLV-4A-15 | TEST_FIELD_KIT | TEST_ACCESSORY | N/A | EXTERNAL_TEST_SENSOR | N/A | N/A | TBD | RECOMMENDED_REVIEW | N/A | From BOM; CAD fields set to TBD unless explicitly defined in workbook.
CMP_TEST_SENSOR_SOIL_MOISTURE_4_20MA | DFRobot | SEN0257 | TEST_FIELD_KIT | TEST_ACCESSORY | N/A | EXTERNAL_TEST_SENSOR | N/A | N/A | TBD | RECOMMENDED_REVIEW | N/A | From BOM; CAD fields set to TBD unless explicitly defined in workbook.
CMP_TEST_SWITCH_FLOAT_DI | Madison | M8000 | TEST_FIELD_KIT | TEST_ACCESSORY | N/A | EXTERNAL_TEST_SENSOR | N/A | N/A | TBD | RECOMMENDED_REVIEW | N/A | From BOM; CAD fields set to TBD unless explicitly defined in workbook.
CMP_TEST_VALVE_SOLENOID_12V | Hunter | 606800 | TEST_FIELD_KIT | TEST_ACCESSORY | N/A | EXTERNAL_TEST_ACTUATOR | N/A | N/A | TBD | RECOMMENDED_REVIEW | N/A | From BOM; CAD fields set to TBD unless explicitly defined in workbook.
CMP_VALVE_CURRENT_SENSE_CH | Bourns | CSS2H-2512R-L100F | HUB_CORE | DRIVER | R_2512_6332Metric | SMD_2512 | Resistor_SMD | ${KICAD6_3DMODEL_DIR}/Resistor_SMD.3dshapes/R_2512_6332Metric.wrl | TBD | OPTIONAL_REVIEW | PENDING_PCB_REVIEW | From BOM; CAD fields set to TBD unless explicitly defined in workbook.
CMP_VALVE_DRIVER_CH | Texas Instruments | DRV8871DDAR | HUB_CORE | DRIVER | SOIC-8_3.9x4.9mm_P1.27mm_PowerPad | HSOP-8 (PowerPAD) | Package_SO | ${KICAD6_3DMODEL_DIR}/Package_SO.3dshapes/SOIC-8_3.9x4.9mm_P1.27mm_PowerPad.wrl | TI DRV8872DDAR (higher current, pin-compatible); TI DRV8876 (integrated current sense) | ACTIVE | PENDING_PCB_REVIEW | Changed from custom SWA-DRV-VALVE-CH to TI DRV8871 H-bridge 2026-07-01 for universal latching+standard solenoid drive.
CMP_VALVE_FLYBACK_DIODE_CH | onsemi | ES1D | HUB_CORE | PROTECTION | D_SMA | DO-214AC_SMA | Diode_SMD | ${KICAD6_3DMODEL_DIR}/Diode_SMD.3dshapes/D_SMA.wrl | TBD | PROVISIONAL_REVIEW | PENDING_PCB_REVIEW | From BOM; CAD fields set to TBD unless explicitly defined in workbook.
CMP_VALVE_GATE_NETWORK_CH | Yageo | RC0603FR-07100RL | HUB_CORE | DRIVER | R_0603_1608Metric | SMD_0603 | Resistor_SMD | ${KICAD6_3DMODEL_DIR}/Resistor_SMD.3dshapes/R_0603_1608Metric.wrl | TBD | PROVISIONAL_REVIEW | PENDING_PCB_REVIEW | From BOM; CAD fields set to TBD unless explicitly defined in workbook.
CMP_VALVE_LINE_CLAMP | Littelfuse | SMBJ33A | HUB_CORE | PROTECTION | D_SMB | DO-214AA_SMB | Diode_SMD | ${KICAD6_3DMODEL_DIR}/Diode_SMD.3dshapes/D_SMB.wrl | TBD | PROVISIONAL_REVIEW | PENDING_PCB_REVIEW | From BOM; CAD fields set to TBD unless explicitly defined in workbook.
CMP_CONN_HDR_LORA_BAY | Wurth Elektronik | 61201121821 |  | CONNECTOR | PinHeader_2x11_P2.0mm_Vertical | THT_2x11_P2.0mm | Connector_PinHeader_2.00mm | ${KICAD6_3DMODEL_DIR}/Connector_PinHeader_2.00mm.3dshapes/PinHeader_2x11_P2.0mm_Vertical.wrl |  | optional | PENDING_PCB_REVIEW | Added Phase 1; mates with RAK3172 LoRa module bay on HUB and NODE boards.
CMP_VALVE_HBRIDGE_SPI_EXPANDER | Microchip | MCP23S17-E/SS | HUB_CORE | DRIVER | SSOP-28_5.3x10.2mm_P0.65mm | SSOP-28 | Package_SO | ${KICAD6_3DMODEL_DIR}/Package_SO.3dshapes/SSOP-28_5.3x10.2mm_P0.65mm.wrl | Microchip MCP23017 (I2C variant) | ACTIVE | PENDING_PCB_REVIEW | Added 2026-07-01; drives 12 H-bridge control lines via SPI
CMP_VALVE_PULSE_BULK_CAP | Panasonic | EEU-FR1E102 | HUB_CORE | POWER | CP_Radial_D10.0mm_P5.00mm | Radial D10mm | Capacitor_THT | ${KICAD6_3DMODEL_DIR}/Capacitor_THT.3dshapes/CP_Radial_D10.0mm_P5.00mm.wrl | Any 1000uF/25V low-ESR equivalent | ACTIVE | PENDING_PCB_REVIEW | Added 2026-07-01; latching pulse energy reservoir
CMP_SENSOR_BURDEN_R | Yageo | RT0805BRD07150RL | HUB_CORE | SENSOR | R_0805_2012Metric | 0805 | Resistor_SMD | ${KICAD6_3DMODEL_DIR}/Resistor_SMD.3dshapes/R_0805_2012Metric.wrl | Any 150ohm 0.1% 25ppm 0805 | ACTIVE | PENDING_PCB_REVIEW | Added 2026-07-01; 4-20mA burden per SENSOR_FRONTEND_SPEC.md
CMP_SENSOR_INPUT_PROTECT | onsemi | BAV99LT1G | HUB_CORE | PROTECTION | SOT-23 | SOT-23 | Package_TO_SOT_SMD | ${KICAD6_3DMODEL_DIR}/Package_TO_SOT_SMD.3dshapes/SOT-23.wrl | Any BAV99 (SOT-23 dual switching diode) | ACTIVE | PENDING_PCB_REVIEW | Added 2026-07-01; ADC input clamp per SENSOR_FRONTEND_SPEC.md
CMP_SENSOR_MODE_SELECT | Wurth Elektronik | 61300311121 | HUB_CORE | SENSOR | PinHeader_1x03_P2.54mm_Vertical | 1x03_2.54mm | Connector_PinHeader_2.54mm | ${KICAD6_3DMODEL_DIR}/Connector_PinHeader_2.54mm.3dshapes/PinHeader_1x03_P2.54mm_Vertical.wrl | Any 1x3 2.54mm header + shunt | ACTIVE | PENDING_PCB_REVIEW | Added 2026-07-01; per-channel mode jumper per SENSOR_FRONTEND_SPEC.md
CMP_BUCK_IND_10UH | Wurth Elektronik | 74437368100 | HUB_CORE | POWER | L_12x12mm_H8mm | 12x12mm | Inductor_SMD | ${KICAD6_3DMODEL_DIR}/Inductor_SMD.3dshapes/L_12x12mm_H8mm.wrl | Bourns SRP1245A-100M; any 10uH >=6A | ACTIVE | PENDING_PCB_REVIEW | Added 2026-07-01; 12->5 buck inductor - verify footprint vs chosen part
CMP_BUCK_IND_2UH2 | Wurth Elektronik | 74438335022 | HUB_CORE | POWER | L_7.3x6.6mm | 7.3x6.6mm | Inductor_SMD | ${KICAD6_3DMODEL_DIR}/Inductor_SMD.3dshapes/L_7.3x6.6mm.wrl | Bourns SRR7045-2R2M; any 2.2uH >=4A | ACTIVE | PENDING_PCB_REVIEW | Added 2026-07-01; 3V3/3.8V buck inductor - verify footprint vs chosen part
CMP_REGULATOR_5V_TO_3V8_MODEM | Texas Instruments | TPS563201DDCR | HUB_CORE | POWER | SOT-23-6_1.6x2.9mm_P0.95mm | SOT-23-6 | Package_TO_SOT_SMD | ${KICAD6_3DMODEL_DIR}/Package_TO_SOT_SMD.3dshapes/SOT-23-6_1.6x2.9mm_P0.95mm.wrl | TI TPS562201DDCR (2A, pin-compatible) | ACTIVE | PENDING_PCB_REVIEW | Added 2026-07-01; modem 3.8V supply (HUB only)
CMP_MODEM_BULK_CAP | Panasonic | EEE-FK1C471P | HUB_CORE | POWER | CP_Elec_8x10.5mm | 8x10.5mm SMD | Capacitor_SMD | ${KICAD6_3DMODEL_DIR}/Capacitor_SMD.3dshapes/CP_Elec_8x10.5mm.wrl | Any 470uF/16V low-ESR | ACTIVE | PENDING_PCB_REVIEW | Added 2026-07-01; modem burst reservoir (HUB only)
CMP_MODEM_LEVEL_SHIFTER | Texas Instruments | TXS0108EPWR | HUB_CORE | COMMUNICATION | TSSOP-20_4.4x6.5mm_P0.65mm | TSSOP-20 | Package_SO | ${KICAD6_3DMODEL_DIR}/Package_SO.3dshapes/TSSOP-20_4.4x6.5mm_P0.65mm.wrl | NXP/onsemi TXS0108E equivalent | ACTIVE | PENDING_PCB_REVIEW | Added 2026-07-01; modem 1.8V<->3.3V level shift (HUB only)

Sheet: DNP_Optional_Parts
item_type | device_id | component_id | description | manufacturer | mpn | quantity | criticality | lifecycle_status | population_status | dnp_flag | source_basis | notes
BOM_COMPONENT | HUB_CORE | CMP_MCU_ESP32S3 | Primary MCU with integrated Wi-Fi and BLE radios | Espressif | ESP32-S3-WROOM-1-N16R8 | 1 | mandatory | candidate | PROVISIONAL_REVIEW | NO | BOM;Netlist_Seed:PROVISIONAL | Related provisional records: HUB_LORA_003,HUB_LORA_004,NODE_LORA_003,NODE_LORA_004
BOM_COMPONENT | HUB_CORE | CMP_REGULATOR_5V_TO_3V3 | Secondary 3.3V step-down (buck) regulator | Texas Instruments | TPS563201DDCR | 1 | mandatory | candidate | PROVISIONAL_REVIEW | NO | BOM;Netlist_Seed:PROVISIONAL | Related provisional records: HUB_LORA_001,NODE_LORA_001
BOM_COMPONENT | HUB_CORE | CMP_CONN_SMA_BULKHEAD | SMA bulkhead RF connector | Amphenol RF | 132134 | 1 | recommended | candidate | OPTIONAL_LORA_REVIEW | TBD | BOM;criticality=recommended;Netlist_Seed:PROVISIONAL;LoRa-related | Related provisional records: HUB_RF_002,NODE_RF_001
BOM_COMPONENT | HUB_CORE | CMP_VALVE_CURRENT_SENSE_CH | Per-channel valve current sense element | Bourns | CSS2H-2512R-L100F | 6 | optional | candidate | DNP | YES | BOM;criticality=optional | 2026-07-01: DRV8871 self current-limits; per-channel sense dropped for simplicity; valve actuation confirmed via flow/pressure feedback.
BOM_COMPONENT | HUB_CORE | CMP_LED_STATUS | System status LED indicator for heartbeat and state codes | Kingbright | APT1608SGC | 1 | recommended | candidate | RECOMMENDED_REVIEW | TBD | BOM;criticality=recommended
BOM_COMPONENT | NODE_CORE | CMP_MCU_ESP32S3 | Primary MCU with integrated Wi-Fi and BLE radios | Espressif | ESP32-S3-WROOM-1-N16R8 | 1 | mandatory | candidate | PROVISIONAL_REVIEW | NO | BOM;Netlist_Seed:PROVISIONAL | Related provisional records: HUB_LORA_003,HUB_LORA_004,NODE_LORA_003,NODE_LORA_004
BOM_COMPONENT | NODE_CORE | CMP_REGULATOR_5V_TO_3V3 | Secondary 3.3V step-down (buck) regulator | Texas Instruments | TPS563201DDCR | 1 | mandatory | candidate | PROVISIONAL_REVIEW | NO | BOM;Netlist_Seed:PROVISIONAL | Related provisional records: HUB_LORA_001,NODE_LORA_001
BOM_COMPONENT | NODE_CORE | CMP_CONN_SMA_BULKHEAD | SMA bulkhead RF connector | Amphenol RF | 132134 | 1 | recommended | candidate | OPTIONAL_LORA_REVIEW | TBD | BOM;criticality=recommended;Netlist_Seed:PROVISIONAL;LoRa-related | Related provisional records: HUB_RF_002,NODE_RF_001
BOM_COMPONENT | NODE_CORE | CMP_VALVE_CURRENT_SENSE_CH | Per-channel valve current sense element | Bourns | CSS2H-2512R-L100F | 6 | optional | candidate | DNP | YES | BOM;criticality=optional | 2026-07-01: DRV8871 self current-limits; per-channel sense dropped for simplicity; valve actuation confirmed via flow/pressure feedback.
BOM_COMPONENT | MOTOR_CONTROLLER | CMP_MCU_ESP32S3 | Primary MCU with integrated Wi-Fi and BLE radios | Espressif | ESP32-S3-WROOM-1-N16R8 | 1 | mandatory | candidate | PROVISIONAL_REVIEW | NO | BOM;Netlist_Seed:PROVISIONAL | Related provisional records: HUB_LORA_003,HUB_LORA_004,NODE_LORA_003,NODE_LORA_004
BOM_COMPONENT | MOTOR_CONTROLLER | CMP_REGULATOR_5V_TO_3V3 | Secondary 3.3V step-down (buck) regulator | Texas Instruments | TPS563201DDCR | 1 | mandatory | candidate | PROVISIONAL_REVIEW | NO | BOM;Netlist_Seed:PROVISIONAL | Related provisional records: HUB_LORA_001,NODE_LORA_001
BOM_COMPONENT | MOTOR_CONTROLLER | CMP_LED_FAULT | Fault/alarm LED indicator | Kingbright | APT1608SURCK | 1 | recommended | candidate | RECOMMENDED_REVIEW | TBD | BOM;criticality=recommended
BOM_COMPONENT | LORA_MODULE_ADDON | CMP_LORA_MODULE_IN865 | LoRa module for IN865 region | RAKwireless | RAK3172 | 1 | recommended | candidate | OPTIONAL_LORA_REVIEW | TBD | BOM;criticality=recommended;LoRa-related
BOM_COMPONENT | TEST_FIELD_KIT | CMP_TEST_SENSOR_SOIL_MOISTURE_4_20MA | 4-20mA soil moisture sensor for channel validation | DFRobot | SEN0257 | 4 | recommended | candidate | RECOMMENDED_REVIEW | TBD | BOM;criticality=recommended
BOM_COMPONENT | TEST_FIELD_KIT | CMP_TEST_SENSOR_PRESSURE_4_20MA | 4-20mA pressure sensor for input verification | AutomationDirect | PTLV-4A-15 | 2 | recommended | candidate | RECOMMENDED_REVIEW | TBD | BOM;criticality=recommended
BOM_COMPONENT | TEST_FIELD_KIT | CMP_TEST_SENSOR_FLOW_PULSE | Pulse-output flow sensor for counter channel testing | Seeed Studio | 314150005 | 2 | recommended | candidate | RECOMMENDED_REVIEW | TBD | BOM;criticality=recommended
BOM_COMPONENT | TEST_FIELD_KIT | CMP_TEST_SENSOR_LEVEL_0_10V | 0-10V level sensor/transducer for analog voltage channel testing | Dwyer | 616KD-11-V | 2 | recommended | candidate | RECOMMENDED_REVIEW | TBD | BOM;criticality=recommended
BOM_COMPONENT | TEST_FIELD_KIT | CMP_TEST_SWITCH_FLOAT_DI | Dry-contact float switch for digital input testing | Madison | M8000 | 2 | recommended | candidate | RECOMMENDED_REVIEW | TBD | BOM;criticality=recommended
BOM_COMPONENT | TEST_FIELD_KIT | CMP_TEST_VALVE_SOLENOID_12V | 12V DC irrigation solenoid valve for output channel testing | Hunter | 606800 | 6 | recommended | candidate | RECOMMENDED_REVIEW | TBD | BOM;criticality=recommended
CONNECTOR | NODE_CORE | CONN_HDR_LORA_BAY | Connector port NODE_LORA_BAY; Board module header/socket | TBD | TBD | TBD | TBD | TBD | OPTIONAL_LORA_REVIEW | TBD | Connector_List;optional=true;Netlist_Seed:PROVISIONAL;LoRa-related | Related provisional records: HUB_RF_002,HUB_LORA_001,HUB_LORA_002,HUB_LORA_003,HUB_LORA_004,NODE_RF_001,NODE_LORA_001,NODE_LORA_002,NODE_LORA_003,NODE_LORA_004
CONNECTOR | MOTOR_CONTROLLER | CONN_M12A_5P_RS485 | Connector port MC_RS485_OUT; M12 A-coded 5-pin | TBD | TBD | TBD | TBD | TBD | PROVISIONAL_REVIEW | TBD | Connector_List;Netlist_Seed:PROVISIONAL | Related provisional records: HUB_RS485_006
CONNECTOR | MOTOR_CONTROLLER | CONN_M12A_4P_PWR12 | Connector port MC_PWR_IN; M12 A-coded 4-pin | TBD | TBD | TBD | TBD | TBD | PROVISIONAL_REVIEW | TBD | Connector_List;Netlist_Seed:PROVISIONAL | Related provisional records: HUB_PWR_003
CONNECTOR | NODE_CORE | CONN_SMA_BULKHEAD | Connector port NODE_LORA_ANT; SMA bulkhead | TBD | TBD | TBD | TBD | TBD | OPTIONAL_LORA_REVIEW | TBD | Connector_List;optional=true;Netlist_Seed:PROVISIONAL;LoRa-related | Related provisional records: HUB_RF_002,NODE_RF_001
NETLIST_ITEM | TBD | SYSTEM_GND | Provisional netlist entity without BOM/connector mapping | TBD | TBD | TBD | TBD | TBD | PROVISIONAL_REVIEW | TBD | Netlist_Seed:PROVISIONAL;unmapped-entity | Related provisional records: HUB_LORA_002,NODE_LORA_002
NETLIST_ITEM | TBD | CHASSIS | Provisional netlist entity without BOM/connector mapping | TBD | TBD | TBD | TBD | TBD | PROVISIONAL_REVIEW | TBD | Netlist_Seed:PROVISIONAL;unmapped-entity | Related provisional records: HUB_PWR_003,HUB_RS485_006
BOM_COMPONENT | HUB_CORE | CMP_VALVE_FLYBACK_DIODE_CH | Per-channel flyback diode | onsemi | ES1D | 6 | optional | approved | DNP | YES | Superseded by DRV8871 integrated freewheeling 2026-07-01 | Not required with H-bridge driver
BOM_COMPONENT | NODE_CORE | CMP_VALVE_FLYBACK_DIODE_CH | Per-channel flyback diode | onsemi | ES1D | 6 | optional | approved | DNP | YES | Superseded by DRV8871 integrated freewheeling 2026-07-01 | Not required with H-bridge driver
BOM_COMPONENT | HUB_CORE | CMP_VALVE_GATE_NETWORK_CH | Per-channel gate resistor network | Yageo | RC0603FR-07100RL | 6 | optional | approved | DNP | YES | Superseded by DRV8871 self-contained H-bridge 2026-07-01 | Not required with integrated H-bridge
BOM_COMPONENT | NODE_CORE | CMP_VALVE_GATE_NETWORK_CH | Per-channel gate resistor network | Yageo | RC0603FR-07100RL | 6 | optional | approved | DNP | YES | Superseded by DRV8871 self-contained H-bridge 2026-07-01 | Not required with integrated H-bridge
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
