praveen034u/SWAFarm/TODO.md

# SWAFarm — TODO / Milestone Tracker

## Architecture pivot — 2026-07-31

**The STM32L462RETx-based architecture below (Steps 01-09) is superseded, not deleted.** Per explicit user direction, the board is being rebuilt from scratch around an ESP32-S3-WROOM-1-N16R8 MCU to match the `NODE_CORE` device variant of the `NodeForRefrence.csv` (actually `.xlsx`) reference specification: isolated RS485, a universal 6-channel sensor front-end, 6-channel H-bridge latching-solenoid valve outputs, and M12 industrial connectors — no battery/solar, no mechanical relays. See the approved rebuild plan for full rationale and the new milestone breakdown.

All nine prior milestones' schematic/PCB/documentation files were **archived, not overwritten**, so this verified work is not lost:
- `Hardware/SWAFarmNodeV1/` → [`Hardware/SWAFarmNodeV1_STM32_ARCHIVE/`](Hardware/SWAFarmNodeV1_STM32_ARCHIVE/) (`.kicad_sch`, `.kicad_pcb`, ERC/DRC JSON, etc.)
- `Documentation/SWAFarmNodeV1_*.md` and `Documentation/images/SWAFarmNodeV1_09PCB_TopView_Placement.png` → [`Documentation/archive_stm32/`](Documentation/archive_stm32/)
- `BOM/SWAFarmNodeV1_PowerSupply_BOM.csv` → [`BOM/archive_stm32/`](BOM/archive_stm32/)

The links inside the "Node V1 Hardware (archived — STM32 architecture)" section below are left exactly as originally written (pre-archive relative paths) for historical accuracy — prepend `archive_stm32/` (or `Hardware/SWAFarmNodeV1_STM32_ARCHIVE/` for the Hardware folder) to resolve them.

The new build reuses the same `Hardware/SWAFarmNodeV1/` project name/location. New milestones are tracked under "NODE_CORE Hardware (ESP32-S3 rebuild)" below, starting from Step 1.

## Node V1 Hardware (archived — STM32 architecture)

### Power Supply Subsystem
- [x] Architecture designed (logical, full solar+battery scope) — 2026-07-29. See [`Documentation/SWAFarmNodeV1_PowerSupply_Design.md`](Documentation/SWAFarmNodeV1_PowerSupply_Design.md) and [`BOM/SWAFarmNodeV1_PowerSupply_BOM.csv`](BOM/SWAFarmNodeV1_PowerSupply_BOM.csv).
- [x] `01_power` schematic captured — 2026-07-30, narrower scope than the full architecture above: 12V DC input, fuse + TVS + low-side N-MOSFET reverse-polarity protection, LT8610AC buck to 3.3V (feedback divider, RT, EN/UV UVLO divider, soft-start, BST/INTVCC decoupling), power-good LED, 4 test points (VIN_PROT, 3V3_RAIL, GND, PG), net labels. Solar input, battery charging (BQ25792), and battery protection (BQ76920) from the architecture doc are **not yet captured in KiCad** — deferred to a follow-on milestone.
- [x] Design review package generated for `01_power` — 2026-07-30. See [`Documentation/SWAFarmNodeV1_01Power_DesignReview.md`](Documentation/SWAFarmNodeV1_01Power_DesignReview.md). The as-built BOM was merged into the single project BOM at [`BOM/SWAFarmNodeV1_PowerSupply_BOM.csv`](BOM/SWAFarmNodeV1_PowerSupply_BOM.csv) (added a Status column: Captured / Planned / Superseded) rather than kept as a separate file, to avoid two BOMs drifting out of sync.
- [x] **Wiring defects found and fixed — 2026-07-30.** Review of the netlist ahead of expert sign-off found the schematic was not actually ERC-clean (the committed `SWAFarmNodeV1_erc.json` snapshot at 21:52:27 was stale). Four defects were found and corrected directly in the `.kicad_sch` (manual S-expression edit, same technique as capture — see Tooling section):
  1. **U1's SW switching node was shorted to GND** by a stray `power:GND` symbol (`#PWR12`) placed directly on the SW/L1/C_BST1 wire — the most serious defect, not flagged by ERC by default (output-to-power-net isn't in the default severity matrix) and found only by netlist inspection. This was also the true cause of the ERC "Output/Power-output pin conflict (U1, #FLG01)" error — both `#FLG01` and `#FLG02` PWR_FLAGs were legitimate (on GND and VIN_PROT respectively, standard practice) and needed no change.
  2. R_gate1 (Q1's gate resistor) was sitting unwired on top of a through-running VIN_PROT→Q1-gate wire instead of being spliced into it. Fixed by splitting that wire around R_gate1's pins.
  3. D_LED1's cathode and anode both landed on the same SW-node wire (zero volts across it, would never light) — resolved as a side effect of fixing (1), but required relocating D_LED1 and adding a dedicated GND return since its old position was on the now-isolated SW net, not true ground.
  4. R_LED1 turned out to already be in series with D_LED1 via the wiring (the original review's claim that it wasn't was itself corrected during this fix).
  Live re-run: **ERC passes clean, 0 errors / 0 warnings.** Fresh `SWAFarmNodeV1_erc.json` exported 2026-07-30T23:56:59. Full writeup in [`Documentation/SWAFarmNodeV1_01Power_DesignReview.md`](Documentation/SWAFarmNodeV1_01Power_DesignReview.md).
- [x] **`08_BatterySolar` schematic captured — 2026-07-31.** Solar input port (`J2`/`F2`/`D2`/`Q2`/`R_gate2`) mirroring `01_power`'s DC-IN protection topology exactly. Battery charger `U_CHG1` = **BQ25798** (real stock KiCad symbol, VQFN-29) substituting the architecture doc's BQ25792 — no official symbol exists for BQ25792, same class of gap as the LT8609A→LT8610AC substitution, same-family/same-core-architecture part confirmed via full pin-table extraction (not guessed). Battery protection AFE `U_PROT1` = **BQ76920PW** (exact match, no substitution needed) with an independent low-side back-to-back FET pair (`Q_DSG1`/`Q_CHG1`), precision sense shunt (`R_SENSE1`), and a tertiary series fuse (`F3`) — a second hardware protection layer independent of the charger IC, per SWA-PWM-003. 4S LiFePO4 pack connector (`J3`) with full cell-tap sense network (VC0–VC4, VC5 tied to VC4 for 4S-on-5S-capable-device operation). Shared I2C bus (reusing `02_MCU`'s reserved PB8/PB9/PC4/PC5) plus a discrete low-IQ (~17µA) battery-voltage ADC divider on spare pin PB1 — both consumed for the first time this milestone. **`01_power`'s buck converter (U1) input was redirected from `VIN_PROT` to the new `VSYS` net** (charger output) — a disclosed, necessary, user-approved integration change to already-approved circuitry, not a silent modification; without it the new charger/battery stage would be electrically orphaned. Missing-requirement gate (battery capacity, solar panel spec, environmental temperature range — none specified anywhere in `.ai/knowledge`) resolved with the user before implementation: 3.35Ah/cell provisional capacity, 10W/≤20V Voc solar target, -20°C to +60°C operating range. Full current-consumption/battery-life/solar-sizing calculations, protection strategy, and classified ERC results in [`Documentation/SWAFarmNodeV1_08BatterySolar_DesignReview.md`](Documentation/SWAFarmNodeV1_08BatterySolar_DesignReview.md). Live ERC: 92 violations (45 errors / 47 warnings) — **2 fewer errors and zero new warnings** vs. the pre-milestone baseline, independently confirmed via `generate_netlist`/`trace_netlist_connection` on the charger, protection AFE, and battery pack connector.
- [ ] Confirm solar panel Voc spec against the charger's 22V VINDPM ceiling once a real panel is sourced (Risk R-1; user-approved planning target is 10W/≤20V Voc, not yet a purchased part)
- [ ] Second-source qualification for LT8610AC, BQ25798 (substitutes BQ25792), BQ76920PW (Risk R-2/R-BATT-6, SWA-CST-004)
- [ ] Formal power budget (SWA-PWM-201) to lock battery capacity (Risk R-3/R-BATT-4) — `08_BatterySolar`'s current-consumption table and illustrative-duty-cycle runtime estimate are a planning-level step toward this, not a substitute for it; also confirm F1's 1.1A PTC sizing against real load current
- [ ] Start LiFePO4 pack UN38.3 / IEC 62133 certification track (Risk R-4/R-BATT-7)
- [ ] Define surge test level (IEC 61000-4-5 class) and finalize GDT/TVS coordination (Risk R-5) — now applies to both DC-IN and Solar-IN ports
- [ ] Review the charger/AFE external application circuit (input-selector FETs, bootstrap network, ILIM/PROG resistor values, cell-tap filter network) against a locked BQ25798/BQ76920 datasheet before fabrication — captured per standard application-circuit convention this milestone, not pin-by-pin datasheet-verified (Risk R-BATT-1, highest-priority open item from `08_BatterySolar`)
- [ ] Footprint placement and routing in KiCad GUI (MCP tooling has no placement/routing capability — see Tooling note below) — handoff to schematic_designer/pcb_layout_reviewer roles
- [ ] Schematic review (pcb_layout_reviewer role) — reverse-polarity MOSFET part number, EN/UV UVLO threshold, and RT switching-frequency choice should be reconfirmed against the LT8610AC datasheet before release

### MCU Foundation Subsystem
- [x] `02_MCU` schematic captured — 2026-07-31. Discrete STM32L462RETx (LQFP64, AES-256/TRNG crypto variant — chosen over plain STM32L452 for SWA-SEC hardware-crypto requirement, no footprint/pinout cost) per `swafarm_overview.md`'s explicit discrete-MCU-over-integrated-module architecture recommendation. Includes: power decoupling (VDD/VDDA/VBAT/VDDUSB), reset network, BOOT0 config, LSE 32.768kHz RTC crystal, ARM 10-pin SWD programming header, USART1 debug console UART header, GPIO-driven status LED, NRST/BOOT0 test points. Ties into the existing `3V3_RAIL`/`GND` nets from `01_power` — no changes made to Power-subsystem circuitry. 27 GPIOs reserved (named via netlist, not wired) for LoRaWAN module, RS485, relay driver, sensor front-end, battery-monitor I2C, expansion SPI, and user buttons; 16 GPIOs left spare. Full writeup, GPIO allocation table, and classified ERC results in [`Documentation/SWAFarmNodeV1_02MCU_DesignReview.md`](Documentation/SWAFarmNodeV1_02MCU_DesignReview.md).
- [ ] Approve wiring Power subsystem's existing `PG` signal to a spare MCU GPIO (low-risk recommendation, not yet applied — awaiting approval per milestone rules)
- [ ] Grid-alignment cleanup pass on the 23 new `02_MCU` components (Minor, cosmetic only — see design review §11 for why it wasn't auto-fixed this pass)
- [ ] Confirm reserved-peripheral alternate-function pin choices (USART2/3, I2C1, SPI1, TIM1) against the STM32L462 datasheet AF table before those subsystems are wired in hardware
- [ ] Second-source qualification track for STM32L462RETx (Risk R-MCU-1, SWA-CST-004) — pin-compatible STM32L4 family alternates identified, not yet formally qualified

### Board Bring-up and Human Interface Subsystem
- [x] `03_HMI` schematic captured — 2026-07-31. Added Activity LED (PC8, new), User button (PC6, active-low, external pull-up + RC debounce, new), Reset button (parallel to existing NRST network, new), 3 new production test points (MCU_TX, MCU_RX, USER_BTN — 3.3V/GND/RESET reused existing TP2/TP3/TP_NRST1 rather than duplicating), and a schematic title block (previously unset) carrying board name/revision/date-code-placeholder/manufacturer-placeholder/project-ID. Power LED and MCU Status LED reviewed and reconfirmed correct, unchanged. PC6 and PC8 consumed from the `02_MCU` GPIO reservation/spare pool; PC7 remains reserved for a possible second future button. Board-ID silkscreen text and mounting holes are specified (§7 of the design doc) but **not physically placed** — both are `.kicad_pcb` layout-stage artifacts and no board outline or enclosure design exists yet (MCP tooling still has no footprint-placement capability, per the Tooling section below). Full writeup in [`Documentation/SWAFarmNodeV1_03HMI_DesignReview.md`](Documentation/SWAFarmNodeV1_03HMI_DesignReview.md).
- [ ] Implement 4x M3 non-plated mounting holes (corner pattern) and board-ID silkscreen text once a board outline/enclosure boss pattern exists (see design doc §7 for full specification)

### RS485 Communication Subsystem
- [x] `04_RS485` schematic captured — 2026-07-31. One THVD1450D transceiver (±18kV IEC ESD, fail-safe receiver — stock KiCad symbol) on the `02_MCU`-reserved USART3 (PB10/PB11) + PB2 combined DE/~RE, forming one shared RS485_A/RS485_B Modbus RTU bus. Five field connectors (4-pin Phoenix-style: A, B, VSYS_RAW_OUT, GND — hub/multidrop topology, NOT five independent interfaces) each with their own PTC fuse pair for per-cable fault isolation, converging into a single shared TVS-protected, DIP-switch-selectable terminated (120R) and biased (560R/560R) bus. 5 test points (A, B, TX, RX, combined DE/RE). `VSYS_RAW_OUT` reused verbatim from the original architecture doc's J4 net name and deliberately left unsourced (reserved for the future charger/VSYS milestone, confirmed via netlist trace it has zero drivers, not accidentally shorted to 3V3_RAIL). No changes made to `01_power`/`02_MCU`/`03_HMI` circuitry. Full writeup, bus topology diagram, and classified ERC results in [`Documentation/SWAFarmNodeV1_04RS485_DesignReview.md`](Documentation/SWAFarmNodeV1_04RS485_DesignReview.md).
- [x] **Critical symbol defect found and fixed during this milestone (not a previously-approved-circuitry issue) — 2026-07-31.** The stock KiCad `THVD1450D` symbol uses an `extends "MAX481E"` inheritance chain; the MCP placement tool's pin-copy logic only carried over 2 of 8 pins and left the `extends` reference unresolved in the schematic's own symbol cache, which would have broken the transceiver entirely (DE, DI, GND, A, B, VCC all physically missing). Fixed by rewriting the schematic's cached copy as a complete, self-contained 8-pin definition and correcting the placed instance; verified via `get_symbol_details` that all 8 pins resolve correctly. This produces one expected, documented `lib_symbol_mismatch` ERC warning (schematic's corrected copy vs. KiCad's own defective stock copy) — cosmetic only, the schematic's copy is authoritative for all ERC/netlist/manufacturing purposes.
- [ ] Wire `VSYS_RAW_OUT` to a real source once the charger/VSYS milestone (BQ25792) is captured
- [ ] Confirm hub/star RS485 topology against real field cable lengths and baud rate once firmware/field data exists (Risk R-RS485-1)
- [ ] Second-source qualification track for THVD1450D (Risk R-RS485-3, SWA-CST-004) — pin/footprint-compatible with the classic MAX485/SP3485/SN75176 family, not yet formally qualified
- [ ] Document DIP switch bias-pins-must-be-toggled-together requirement in firmware/field installation instructions (Risk R-RS485-4)

### LoRaWAN Communication Subsystem
- [x] `05_LoRaWAN` schematic captured — 2026-07-31. RAK3172 module, `RAK3172-xx-8-SM-xI` variant (verified from the KiCad library's own metadata as "RU864/IN865/EU868" — matches the India target region), confirming rather than changing the discrete-MCU-plus-certified-module architecture already decided in `02_MCU`. UART1 (AT-command interface) wired to the `02_MCU`-reserved USART2 (PA2/PA3, net names `LORA_TX`/`LORA_RX`), reset (PA0, `LORA_RESET_N`, pull-up + test point, same topology as the host MCU's own NRST), and a status GPIO (PA1, renamed `LORA_STATUS` — see note below). A real BOOT0 pin (not anticipated in the original `02_MCU` GPIO table) was found during datasheet/symbol verification and handled with the same pull-down + test-point pattern as the host MCU's own BOOT0. RF pin wired via a short unmatched 50Ω-target trace to a U.FL/IPEX connector (`Connector_Coaxial:U.FL_Hirose_U.FL-R-SMT-1_Vertical` footprint); external SMA antenna (via pigtail from the U.FL connector) selected over a PCB antenna for RF performance inside a sealed enclosure, long-range link budget, IP65 serviceability, and certification consistency — full rationale in the design doc. SWDIO/SWCLK exposed as unconnected test points only (rework contingency, not part of normal operation). No changes made to `01_power`–`04_RS485` circuitry. Full writeup in [`Documentation/SWAFarmNodeV1_05LoRaWAN_DesignReview.md`](Documentation/SWAFarmNodeV1_05LoRaWAN_DesignReview.md).
- [x] **Placement defect found and fixed during this milestone (not a previously-approved-circuitry issue) — 2026-07-31.** The U.FL antenna connector's shield/GND pin position was computed with a sign error (subtracted instead of added the local Y-offset per the standard pin-position formula), leaving the connector's RF shield floating — a real RF-performance defect (no ground reference for the coaxial shield), not just a cosmetic ERC item. Found via netlist trace (not obvious from ERC's default output), fixed by correcting the GND symbol's coordinate, independently re-verified.
- [x] **GPIO placeholder correction — 2026-07-31.** `02_MCU`'s GPIO table reserved PA1 as "LORA_BUSY," assuming a dedicated hardware busy signal. The verified RAK3172 pinout has no such pin (only general-purpose `PIN_Ax` GPIOs); renamed to `LORA_STATUS` on first actual implementation. This was a documentation-only placeholder, never wired, so not a change to approved circuitry.
- [x] **Gap 1 closed — 2026-07-31.** Cross-subsystem physical floor-plan/four-layer strategy document produced: [`Documentation/SWAFarmNodeV1_PCB_FloorPlan_and_LayerStrategy.md`](Documentation/SWAFarmNodeV1_PCB_FloorPlan_and_LayerStrategy.md). Reconciles all five captured subsystems plus the four not-yet-captured ones against the specified four-layer stack-up (L1 components/signals, L2 solid GND plane, L3 power distribution + low-speed signals, L4 components/signals): relative zone-adjacency floor plan, grounding strategy, RF/high-current/isolation/thermal constraints, connector/mounting placement rules, and explicit deferral of impedance geometry pending manufacturer stack-up selection. Planning artifact only — no `.kicad_pcb` file touched, no routing performed. Should be revisited at the start of each future milestone and again before PCB layout begins.
- [ ] **Gap 2 — still open, not yet acted on.** `04_RS485` did not consider galvanic isolation, which `.ai/agents/hardware_architect.md` explicitly recommends ("Consider isolated RS485 for production versions"). The new floor-plan document reserves spatial provision for an isolation moat (§7) without resolving the decision. Flagged for team review before production release — not unilaterally changed, per this session's "explain why + wait for approval" rule for previously-approved subsystems.
- [ ] Antenna gain / cable-loss link budget finalization once the enclosure and pigtail length are selected (Risk R-LORA-2)
- [ ] SMA bulkhead connector + U.FL pigtail cable — mechanical/enclosure-integration item, specified but not placed (design doc §5)
- [ ] Revisit powering the RAK3172 module through a dedicated load switch (the Power subsystem's originally-planned U4) instead of directly from `3V3_RAIL`, once that load switch is captured, for deeper sleep-current savings (Risk R-LORA-1)
- [ ] Second-source qualification track for RAK3172 (Risk R-LORA-3, SWA-CST-004)

### Industrial Relay Output Subsystem
- [x] `06_Relay` schematic captured — 2026-07-31. Five identical low-side N-MOSFET relay driver channels (`RELAY1`–`RELAY5`), each: MCU GPIO → 100Ω gate resistor → logic-level SOT-23 N-MOSFET → Finder 40.51 SPDT 12VDC/10A relay coil, 10kΩ gate pull-down for guaranteed default-OFF (including at MCU reset/boot), SMA-package flyback diode across the coil, and a status LED tapped off the control net at zero incremental GPIO cost. Consumes exactly the five GPIOs (`PB12`, `PB13`, `PB14`, `PB15`, `PA15`) `02_MCU` reserved for "Relay driver ×5" — no other subsystem's pins touched. Coil power (`RELAY_PWR`) is a locally-filtered branch (power ferrite bead + 22µF bulk cap) of the already-reserved `VSYS_RAW_OUT` net, reusing that net exactly as `04_RS485` did for sensor power, isolating relay switching noise from that shared trunk. Each channel has a 3-pin Phoenix MKDS screw-terminal field connector (COM/NO/NC, same footprint family as RS485's field connectors) with relay contacts deliberately **not** tied to board GND, preserving galvanic isolation between control and switched circuits. 5 per-channel control test points + 1 shared power test point + 1 shared ground test point. No changes made to `01_power`–`05_LoRaWAN` circuitry. Live ERC: 94 violations (47 errors / 47 warnings), down from the 99-violation pre-milestone baseline by exactly the 5 GPIO pins now wired — **zero new violations introduced**, independently confirmed via `generate_netlist`/`trace_netlist_connection` on every new node class. Full writeup, power calculations, and classified ERC results in [`Documentation/SWAFarmNodeV1_06Relay_DesignReview.md`](Documentation/SWAFarmNodeV1_06Relay_DesignReview.md).
- [ ] `VSYS_RAW_OUT` now has two disclosed consumers (RS485 sensor power + ~385mA worst-case relay coil draw) with no real source yet — must be accounted for when the battery-charger/VSYS milestone is sized (Risk R-RELAY-1; combined total updated to ≈885mA worst-case in `07_FieldIO`, see below)
- [ ] Confirm Finder 40.51.9.012 coil current/power against a locked datasheet before BOM release (Risk R-RELAY-2)
- [ ] Second-source qualification track for the Finder 40.51 family (Risk R-RELAY-3, SWA-CST-004)
- [ ] Relay-bank thermal assessment against real enclosure airflow at PCB layout stage (Risk R-RELAY-4)
- [ ] Contact-side creepage/clearance analysis if any channel is expected to switch mains-referenced loads (Risk R-RELAY-5)

### Field I/O & Sensor Interface Subsystem
- [x] `07_FieldIO` schematic captured — 2026-07-31. Reviewed the five RS485 sensor field connectors already captured in `04_RS485` (`J_RS485_SENSOR1`–`5`, one shared bus, one transceiver) and confirmed they already satisfy the "five connectors, same bus, RS485 A/B + Sensor Power + Ground" requirement — **no new or duplicate connectors created**. Closed the one real gap found: the Sensor Power pin had zero protection (directly on the shared, unfused `VSYS_RAW_OUT` trunk). Added one PTC fuse per connector (`F_RS485_PWR1`–`5`, same 0.2A-hold class already qualified for RS485 A/B in `04_RS485`, mirroring that exact per-drop-fuse/shared-TVS-once pattern) plus one shared unidirectional TVS (`D_SENSOR_PWR_TVS1`, `SMBJ18A` class) upstream of all five, providing surge/ESD protection and crude reverse-polarity clamping via the same passive clamp-and-fuse approach standard for low-power field power outputs. **Missing-requirement gate hit and resolved before implementation**: no `.ai/knowledge` document specifies a sensor current draw or count; asked the user directly rather than guessing, approved planning figure is 100mA/sensor, 500mA total worst-case — used to size the fuse, documented as an assumption pending real sensor selection (Risk R-FIO-1). Combined disclosed `VSYS_RAW_OUT` worst-case demand from RS485 sensor power (this milestone) + relay coils (`06_Relay`) is now **≈885mA** — the number the future charger/VSYS milestone must be sized against. Mechanical clearance reservations for field-connector cable approach, tool access, strain relief, and labeling recorded for both the RS485 sensor and relay connector families (floor-plan doc updated). No changes to RS485 topology, GPIO allocation, or any other previously-approved circuitry. Live ERC: 94 violations (47/47), identical to the pre-milestone baseline — **zero new violations**, independently confirmed via netlist trace. Full writeup in [`Documentation/SWAFarmNodeV1_07FieldIO_DesignReview.md`](Documentation/SWAFarmNodeV1_07FieldIO_DesignReview.md).
- [ ] Confirm the 100mA/sensor planning assumption against real selected sensor models before release (Risk R-FIO-1)
- [ ] Size the battery-charger/VSYS milestone against the combined ≈885mA worst-case `VSYS_RAW_OUT` demand (sensors + relays) (Risk R-FIO-2)
- [ ] Verify PTC fuse resistance/voltage-drop against a locked datasheet once real cable-run lengths are known (Risk R-FIO-3)
- [ ] Validate field-connector mechanical clearance reservations against a real enclosure/cable-gland selection (Risk R-FIO-4)

### PCB Floor Planning and Component Placement
- [x] **`09_PCBFloorplan` PCB placement captured — 2026-07-31.** All 199 approved schematic components imported into a fresh 4-layer `.kicad_pcb` (300mm × 220mm board, courtyard-verified sizing, not guessed) and placed into 8 functional zones (Power, Battery, RF, RS485, MCU, Debug, HMI, Relay) matching `SWAFarmNodeV1_PCB_FloorPlan_and_LayerStrategy.md`'s pre-approved zone-adjacency plan. The existing `.kicad_pcb` contained corrupted placeholder outline geometry (~2147mm × 2147mm, an old tool artifact) and only 27 of 199 components — rebuilt from scratch rather than patched. Real defect found and fixed: `J2` (Solar-IN connector, `08_BatterySolar`) had an empty `Footprint` property, caught by a footprint-resolution verification pass before placement. DRC iterated to zero physical/electrical placement violations (courtyard overlaps, shorts, co-located holes all resolved from an initial 38/32/4 down to 0); 41 cosmetic silkscreen-text-overlap warnings remain, flagged for a dedicated cleanup pass. MCU and charger IC decoupling capacitor placement reviewed and tightened (was 20-46mm from the IC, corrected to ~12-15mm) per the milestone's explicit decoupling-verification requirement. No routing, copper pours, or trace widths touched, per explicit scope. Rendered top-down view saved to `Documentation/images/SWAFarmNodeV1_09PCB_TopView_Placement.png`. Full writeup in [`Documentation/SWAFarmNodeV1_09PCBFloorplan_DesignReview.md`](Documentation/SWAFarmNodeV1_09PCBFloorplan_DesignReview.md).
- [ ] Silkscreen reference-designator cleanup pass (41 remaining overlap warnings, cosmetic — Risk R-PCB-1)
- [ ] Validate board outline (300x220mm) and mounting-hole positions against a real enclosure once that milestone begins (Risk R-PCB-2/R-PCB-4)
- [ ] Ground plane, RF keepout copper exclusion, and thermal via strategy remain planned-but-unimplemented pending routing (Risk R-PCB-3)
- [ ] Reviewed `NodeForRefrence.csv` (an .xlsx file with a .csv extension) at user request — confirmed to describe an unrelated parallel product specification (ESP32-S3-based `HUB_CORE`/`NODE_CORE`/`MOTOR_CONTROLLER` family, isolated RS485, universal sensor I/O, H-bridge latching solenoid valves) rather than a refinement of this board; per explicit user direction, not incorporated

### Other Subsystems (not started)
- [ ] Sensor front-end (5+ channels)
- [ ] Enclosure / mechanical design

## NODE_CORE Hardware (ESP32-S3 rebuild)

Full rebuild per the approved plan (`C:\Users\prave\.claude\plans\moonlit-napping-snowglobe.md`), matching the `NODE_CORE` rows of `NodeForRefrence.csv`'s reference specification. `HUB_CORE` (4G gateway) and `MOTOR_CONTROLLER` (motor-starter board) are explicitly out of scope — different products, per user direction. Data sourced from the spec is treated as ground truth where `LOCKED`/exact (MCU pin map, connection matrix, most BOM MPNs); where the spec is qualitative-only (`Layout_Rules`, all `TBD`) or self-contradictory (valve driver support parts marked both populated and DNP — resolved in favor of `DNP_Optional_Parts`), gaps are closed with disclosed, reasoned defaults, same discipline as Steps 01-09.

- [x] **Step 1 — Power Input, Protection & Power Chain — captured 2026-07-31.** M12 4-pin power in/out (daisy-chain pass-through via `V12_PROT`, pre-eFuse), PTC fuse (`F1`) + TVS (`D1`) + self-biased low-side NMOS reverse-polarity protection (`Q1`/`R_gate1`, same topology as the archived `01_power`'s `Q1`), `TPS26600PWP` eFuse (`U1`: UVLO ~9.1V/OVP ~16V dividers, auto-retry `MODE`, always-enabled `~SHDN`, `ILIM`/`dVdT` reasoned-default sizing, `IMON`/`~FLT` exposed as diagnostic test points only — no GPIO reserved in the spec's `Final_MCU_Pin_Map`), 12V→5V buck (`U2` = `TPS54561`, disclosed substitution for the spec's `TPS54531` — no exact stock symbol, same TI SWIFT family, 5A vs. 3.5A headroom), 5V→3.3V buck (`U3` = `TPS563201`, exact stock symbol, self-contained flattened copy per the same technique used for `THVD1450D` in the archived `04_RS485`). Fresh KiCad project created at the same `Hardware/SWAFarmNodeV1/` path (Arduino_Mega template placeholder content stripped from the schematic; a minimal valid header was hand-written instead — the `.kicad_pcb` still has 13 leftover template footprints, harmless until Step 8). Live ERC (real `kicad-cli`, not just the MCP tool): **0 errors, 1 expected/documented warning** (`lib_symbol_mismatch` on `U3`, same class as the archived project's `THVD1450D` warning). Netlist-verified via `generate_netlist`(`--format kicadxml`)/`trace_netlist_connection` on `Q1`, `U1`, `U2` — all nets match intended topology. 5 `PWR_FLAG`s added (`DC_IN_RAW_P`, `GND`, `V12_PROT`, `V5_RAIL`, `V3V3_RAIL`) — required because ERC's `power_pin_not_driven` check doesn't trace through passives (fuses/inductors), same requirement class as the archived build's `#FLG01`/`#FLG02`. Full writeup, reasoned-default component values (eFuse `ILIM`/`dVdT`, buck compensation/RT/inductor values — none block capture, all flagged for pre-fabrication datasheet confirmation), and known gaps in [`Documentation/SWAFarmNodeV1_01Power_NodeCore_DesignReview.md`](Documentation/SWAFarmNodeV1_01Power_NodeCore_DesignReview.md).
- [ ] M12 connector footprints are placeholder-blank (schematic-level only, per the spec's own `Footprint_Library_Map` marking them `PENDING_PCB_ENGINEER`) — must be resolved before Step 8 (this exact gap caused a real defect once already in the archived build's `J2`)
- [ ] eFuse `ILIM`/`dVdT` and buck1 compensation network (`R_COMP1`/`C_COMP1`) values are reasoned placeholders, not datasheet/loop-stability calculated — confirm before BOM release
- [ ] `IMON`/`~FLT` diagnostic outputs are test-point-only; revisit wiring to a spare MCU GPIO once Step 2 is captured, if one is available
- [ ] Strip the `.kicad_pcb`'s 13 leftover Arduino_Mega template footprints before Step 8
- [x] **Step 2 — MCU Core — captured 2026-08-01.** `ESP32-S3-WROOM-1-N16R8` (exact stock symbol, real 41-pin WROOM-1 pinout — `USB_D±`/`TXD0`/`RXD0` exposed under alternate-function names rather than raw GPIO19/20/43/44 on this symbol), `CHIP_EN` reset network (10k pull-up + 1µF + button), `GPIO0` boot-strap (10k pull-up + button), native USB (`USB_C_Receptacle_USB2.0_14P` + CC1/CC2 pull-downs), 3-pin debug UART header, 10×100nF+1×10µF decoupling per the spec's own ESP HW-guide note. All 20 GPIO reservations for later milestones (RS485/LoRa/sensor/valve/LED) placed as isolated labels, matching the archived project's own "named via netlist, not yet wired" pattern.
- [x] **Step 3 — Human Interface — captured 2026-08-01.** `PWR`/`LINK`/`FAULT` LEDs (1kΩ series) + setup/commissioning button (10k pull-up), consuming the Step 2 GPIO reservations.
- [x] **Step 4 — RS485 Isolated Communication — captured 2026-08-01.** `ISO7761DW` isolator (real 6-channel part, 5fwd/1rev) + `MEE1S0505SC` isolated DC-DC + `THVD1450DR` transceiver (self-contained copy, same `extends`-flattening technique as the archived `04_RS485`'s `THVD1450D` fix — here a two-level chain `THVD1450D→MAX481E→LTC2850xS8`). `DE`/`~RE` tied to one combined isolator channel (per the spec's own note). **Real ERC-caught defect, not guessed:** an initial two-transceiver design (matching the spec's `qty=2` BOM line) produced a genuine `pin_to_pin` conflict (two active `RO` outputs on one isolator channel) — fixed by using one shared transceiver fanned out to all 3 M12 connectors (IN/OUT/LOCAL), the same "multiple connectors, one bus" pattern already proven in the archived `04_RS485`/`07_FieldIO`; disclosed deviation from the spec's transceiver quantity. Line protection (`SM712_SOT23`) + common-mode choke at the two external field-entry points, 120Ω solder-select termination + 680Ω/680Ω bias. Closes the galvanic-isolation gap flagged as open in the archived `04_RS485` milestone.
- [x] **Step 5 — LoRaWAN Module Bay — three revisions, all on 2026-08-01; current state: populated, India-band, range-justified.** (1) Captured with `RAK3172-xx-8-SM-xI` + SMA bulkhead, marked `dnp yes` (optional bay, matching spec). (2) User asked to remove the DNP ("crossed in red") components entirely — confirmed first (reverses the DNP-bay decision, not just cleanup), then removed via full clean rebuild from the Step 1 checkpoint (155 components). (3) User then asked to re-add LoRa specifically for the **India region** with **~5km+ theoretical range**, and separately confirmed **ESP32-S3 compatibility**. Re-added the *same* `RAK3172-xx-8-SM-xI` part — its own stock-symbol Description field already reads "RU864/**IN865**/EU868" (India's LoRaWAN band), so it was already the right regional variant, just previously unpopulated — this time fully populated (not DNP). **Link budget for the range requirement (not just asserted):** +22dBm max TX, -148dBm RX sensitivity (SF12/BW125) → 176dB budget; free-space path loss at 5km/866MHz ≈ 105.2dB even with a conservative 3dBi/3dBi antenna assumption → **~71dB margin at 5km** (84.8dB at 1km, 64.8dB at 10km) — comfortably achievable in rural/farm line-of-sight conditions; requires an external gain antenna (≥3dBi) via the SMA connector at deployment, not a PCB trace antenna. **ESP32-S3 compatibility confirmed explicitly:** RAK3172 is a UART/AT-command module (own onboard STM32WLE5CC runs the LoRaWAN stack) — host-MCU-agnostic, needs only 3.3V power + a UART pair + 2 GPIOs, all already matched (`V3V3_RAIL`, `GPIO17/18` per the spec's own `Final_MCU_Pin_Map`, 2 spare GPIOs for `BOOT0`/`RESET`) with no level-shifting needed. Rebuilt via the same clean-checkpoint-replay method (not hand-editing the live file). Final count: 161 components (back to original). ERC 0 errors/7 documented warnings, DRC 0 violations, BOM regenerated (`BOM/SWAFarmNodeV1_NodeCore_BOM.csv`, 79 lines, `U_LORA1`/support parts no longer marked DNP).
- [x] **Step 6 — Universal Sensor Front-End — captured 2026-08-01.** 6 channels, each: 100k series + 150Ω/0.1% burden resistor (disclosed single-resistor simplification serving as both the 0-10V divider leg and the 4-20mA current-sense burden), bipolar clamp (2 discrete diodes standing in for a `BAV99` dual-diode package, same function, disclosed), 100nF RC filter, into ADC1-only GPIOs (ADC2 conflicts with Wi-Fi per spec). 2× 6-pole terminal blocks (SIG+RET, matching the locked `Netlist_Seed` per-channel SIG/RET pairing).
- [x] **Step 7 — Valve Output Drivers — captured 2026-08-01.** 6× `DRV8871DDA` (real stock symbol) H-bridge channels driven by one `MCP23S17` SPI I/O expander (`GPA0-7`+`GPB0-3`), integrated freewheeling/current-limit/thermal-shutdown — no external flyback diode/gate network/current-sense, per the resolved DNP contradiction (`DNP_Optional_Parts` treated as authoritative over `BOM`/`Device_Allocation`). 1000µF/25V bulk cap, 2× 6-pole terminal blocks (OUT1+OUT2, full H-bridge needs both dedicated leads per channel).
- [x] **Step 8 — PCB Floor Planning & Placement — captured 2026-08-01.** Same `pcbnew`-scripting technique proven in the archived Step 09, with a refinement: components are laid out in a **sequential vertical stack** (each zone starts exactly where the previous zone's actual placed content ended) rather than fixed per-zone boxes, after the fixed-box approach produced real cross-zone courtyard overlaps once actual footprint sizes (53mm terminal blocks, 30mm common-mode chokes, WROOM-1's 48×21mm antenna keepout) didn't match initial guesses. 385×335mm 4-layer board, 4× M3 mounting holes, 161 footprints placed. **3 real defects found and fixed via DRC, not guessed:** two footprint-library path errors (`Connector_USB_C`→`Connector_USB`, wrong RAK3172 footprint name), common-mode chokes assigned a 2-pad inductor footprint instead of a real 4-pad CMC part, and MCU-zone neighbors initially landing inside the WROOM-1's built-in antenna-keepout rule area. **Final: 0 DRC errors, 4 cosmetic silkscreen warnings** (381 unconnected items expected — no routing performed, per scope). Full writeup, including a disclosed `--schematic-parity` cross-reference gap inherent to programmatic `pcbnew` placement (footprint/net data confirmed correct by 0 real DRC errors; only the UUID-link metadata a GUI "Update PCB from Schematic" pass would add is missing), in [`Documentation/SWAFarmNodeV1_02to08_NodeCore_DesignReview.md`](Documentation/SWAFarmNodeV1_02to08_NodeCore_DesignReview.md).
- [x] **PCB placement corrected — 2026-08-01.** The Step 8 placement above sized cells by *guessed* per-category dimensions rather than measured footprints; several real footprints (terminal blocks, CMC choke, mounting holes) exceeded the guesses, and components at the right edge of several rows ended up partially outside the board outline (caught by the user in the KiCad 3D viewer, not by DRC — `pcbnew`'s DRC doesn't check "inside board outline" by default). Fixed by measuring every footprint's real bounding box via `pcbnew` before layout (the same "measure real courtyard, don't guess" discipline from the archived Step 09) and sizing cells to actual dimensions + margin. Board grew to 420×355mm; **0 out-of-bounds footprints (programmatically verified), 0 DRC violations of any kind** (even the 4 cosmetic silkscreen warnings resolved with the extra spacing).
- [x] **BOM regenerated — 2026-08-01.** Full cross-referenced BOM for the 161-component NODE_CORE schematic at [`BOM/SWAFarmNodeV1_NodeCore_BOM.csv`](BOM/SWAFarmNodeV1_NodeCore_BOM.csv) (80 grouped lines) + methodology/disclosure notes at [`BOM/SWAFarmNodeV1_NodeCore_BOM_Notes.md`](BOM/SWAFarmNodeV1_NodeCore_BOM_Notes.md). Real manufacturer/MPN filled in for every component matching a `NodeForRefrence.csv` BOM row (17 exact matches); every disclosed substitution, package variant, and value mismatch carried over from the design reviews; DNP-excluded valve-protection parts and 2 spec BOM lines with no schematic counterpart (`CMP_ESD_ARRAY`, `CMP_VALVE_LINE_CLAMP`) explicitly documented as gaps, not silently dropped.
- [x] **11-category design audit run + 2 critical findings fixed — 2026-08-01.** User-requested audit (datasheet verification, power rail audit, connectivity/net review, connector/pull-up/protection/RF/test-point checks, BOM validation) against the 161-component schematic, verified via real `kicad-cli`/netlist-trace tooling rather than assertions. Found and fixed 2 real defects (both re-verified: 0 ERC errors/7 pre-existing documented warnings unchanged, 0 DRC violations, 0 out-of-bounds footprints):
  - **Valve rail overcurrent (power rail audit).** `V12_SW` — the `TPS26600PWP` eFuse's 2A-rated output — fed both buck1 AND all 6 `DRV8871` valve drivers (each up to 2.5-3.6A pulse for latching solenoids); a single valve pulse could already exceed the eFuse's rating. Fixed with a new dedicated valve branch: `V12_VALVE`, tapped from `V12_PROT` upstream of the eFuse through a new fuse `F2` (Littelfuse 1812L-class, ~4A hold). `U_DRV1-6` pin 5 (VM), `C_VMDEC1-6` pin 1, and `C_VALVEBULK1` pin 1 moved from `V12_SW` to `V12_VALVE`; `F1` (input fuse) resized 1.5A → 5A to cover the new local worst-case draw; new `TP_VALVE_PWR1` test point added; new `#FLG06` PWR_FLAG added (required — `V12_VALVE` has no power-output-type pin driving it, same class of requirement as `#FLG01-05`). **Real defect caught by the user running KiCad's own "Update PCB from Schematic" (not by this session's own ERC/DRC checks):** the new flag was initially named literally `FLAG6` instead of the `#FLG0n` convention KiCad uses to mark power-flag symbols as board-exempt — `Update PCB from Schematic` correctly flagged this as "Cannot add FLAG6 (no footprint assigned)" since a `#`-prefixed reference is what tells KiCad's PCB updater to skip a symbol rather than require a footprint for it. Fixed by renaming to `#FLG06`; re-verified 0 ERC errors/7 warnings unchanged. **Firmware caveat, disclosed, not yet enforced in hardware:** this sizing assumes sequential (one-channel-at-a-time) valve actuation; simultaneous multi-valve firing would need this branch and its wiring/connector gauge resized further.
  - **Sensor front-end 0-10V divider math (datasheet + connectivity review).** The shared `R_SER`(100k)+`R_BURDEN`(150R) network gave only ~15mV at the ADC for a 10V input (verified by calculation: 10V × 150/100150Ω ≈ 15mV, versus the ESP32-S3 ADC's usable range) — and separately made the 4-20mA loop's compliance voltage physically impossible (100k+150R in series needs >2000V at 20mA to reach 20mA, since the loop current has to pass through both resistors in series). Fixed with a jumper-selectable dual network per channel (standard industrial universal-analog-input practice, verified correct in both modes via circuit analysis before implementing): `R_SER` revalued 100k → 232k, paired with a new `R_VBOT` (100k) for a proper 0-10V → 3.01V divider; two new 2-pin jumpers per channel, `JP_VBYP` (shorts `R_SER` for 4-20mA mode) and `JP_IGND` (gates `R_BURDEN`'s GND return, populated together with `JP_VBYP` for 4-20mA mode, left open for 0-10V mode) — populate as a matched pair, never one without the other. 24 new components total (2 fixes combined: `F2`, `TP_VALVE_PWR1`, 6×`R_VBOT`, 6×`JP_VBYP`, 6×`JP_IGND`, `#FLG06`). Schematic now 181 components; PCB rebuilt (measured-footprint placement, 0 out-of-bounds) and BOM regenerated (84 lines, 181 components) to match. Full before/after netlist verification and BOM disclosure notes in `BOM/SWAFarmNodeV1_NodeCore_BOM_Notes.md`.
- [ ] `JP_VBYP`/`JP_IGND` are implemented as 2 separate 2-pin jumpers per channel (verified correct, but requires populating a matched pair correctly by hand) — a single mechanically-ganged DPDT switch or dual-row shorting shunt is a valid, more foolproof alternative at the layout/production engineer's discretion; not implemented here to avoid guessing a non-stock multi-pole part
- [ ] `F1`/`F2` cited by real PTC family/class (Bourns MF-RG1812 / Littelfuse 1812L) rather than an exact single MPN — pin down exact hold-current part once the M12 connector's real current rating (below) is resolved
- [ ] M12 connector footprints (5×) and debug header are placeholder THT headers, not real circular-connector footprints — resolve before Gerber export
- [ ] Run "Update PCB from Schematic" once in the KiCad GUI before routing, to resolve the `--schematic-parity` cross-reference gap noted above
- [ ] Isolated-RS485 zone needs a real copper-exclusion keepout sized to the isolator/DC-DC's rated working voltage before routing (floor-plan only right now)
- [ ] eFuse `ILIM`/`dVdT`, buck compensation, and valve-driver `ILIM` resistor values remain reasoned placeholders (`_TBD`-suffixed) pending real datasheet/loop-stability confirmation
- [ ] L1's placeholder value (3.3µH) doesn't match the spec's recommended real inductor (Wurth 74437368100, 10µH-class) — reconcile together with the buck1 compensation network before BOM lock
- [ ] `CMP_ESD_ARRAY` and `CMP_VALVE_LINE_CLAMP` from the spec BOM have no corresponding schematic component — review whether additional protection hardening is needed (see BOM notes)
- [ ] Second-source qualification for all newly-introduced parts (`ESP32-S3-WROOM-1`, `ISO7761DW`, `MEE1S0505SC`, `THVD1450DR`, `DRV8871DDA`, `MCP23S17`, `RAK3172`)
- [x] **Independent re-verification audit pass — 2026-08-01.** User asked for the same 11-category audit to be re-run as an independent check. Re-executed live (`run_erc`/`run_drc` against the current `.kicad_sch`/`.kicad_pcb`, plus a freshly regenerated netlist via `generate_netlist`, rather than trusting the on-disk `_erc.json`/`_netlist.xml` exports, which predated the last schematic save by several hours). Result: **0 new critical defects** — both fixes above re-confirmed intact by fresh netlist trace (`V12_VALVE` still cleanly separated from `V12_SW`; sensor-channel divider/jumper topology unchanged). Full pin-by-pin re-verification of `U_MCU1`'s real embedded `ESP32-S3-WROOM-1` symbol (all 41 pins, read directly from `lib_symbols`) against the documented GPIO map found **zero STM32 contamination** — the only literal "STM32" string anywhere in the file is inside the RAK3172 module's own `Description` property (`STM32WLE5`, its onboard radio SoC — expected, not a defect). **Tooling caveat found and logged, not a design defect:** the MCP server's `detect_pin_conflicts` tool reported three components (`J_SWD1`, `U_CHG1`, `U_PROT1`) with STM32 port-style pin names (`PA4`, `PC0`, `PH0`...) that do not exist anywhere in the schematic — confirmed absent via `list_schematic_components` (181 real components, no such refs) and a full `lib_symbols` grep (92 symbol defs, none STM32-related). Root cause not confirmed, but that tool's component list does not reflect this project's real file contents — don't trust it at face value here. Independently re-derived the RF link budget (FSPL formula, 866MHz/5km ≈ 105.2dB) and the sensor-divider math (10V×100k/332k=3.01V) by hand — both match the figures above exactly. No SPICE tooling or PDF renderer available in this environment (`pdftoppm`/poppler missing), so the TPS26600 `ILIM`/`UVLO`/`OVP`/`dVdT` exact formulas remain unconfirmed — pull the datasheet on a machine with normal PDF tooling to close out the item below.
- [ ] `F1` (5A hold) feeds `V12_PROT`, which branches to both the eFuse (`U1`, 2A silicon-limited) and `F2` (4A hold) — combined downstream demand (~6A) exceeds F1's own hold rating on paper. Likely fine given the valves are *latching* solenoids (brief pulse, not held-on) and `C_VALVEBULK1` supplies the transient locally rather than pulling it through F1, but that reasoning isn't written down or verified against the real solenoid pulse profile — confirm explicitly (or re-size F1) before BOM lock, especially since F1 was already found undersized once this cycle for a related reason.
- [ ] No production debug-lockdown / secure-boot plan exists yet for `J_PROG1` (debug UART) or `J_USB1` (native USB programming) — `hardware_requirements.md`'s Security Considerations mandate gated/disabled debug ports and mandatory secure-boot/signed-firmware support for production. ESP32-S3 supports secure boot + flash encryption in silicon; nothing in this design or its docs tracks provisioning it yet. Needs a decision before MP, not before schematic capture.
- [ ] No test point exists on `V12_PROT` itself (the single rail feeding both the eFuse branch and the `F2`/valve branch) — would help production fault isolation (distinguish "input fuse blown" vs. "eFuse fault" vs. "valve fuse fault"). Minor, same pattern as the existing `TP_12V_SW1`/`TP_VALVE_PWR1` test points; add if a spare pad/pin is convenient during routing.

## Tooling
- [x] KiCad MCP server configured — 2026-07-30. Seeed-Studio/kicad-mcp-server installed into KiCad 10.0's bundled Python (`C:\Program Files\KiCad\10.0\bin\python.exe`), registered with Claude Code (`claude mcp add kicad -s user`) at `C:\Users\prave\mcp-servers\kicad-mcp-server`, scoped to this project via `KICAD_PROJECT_PATHS`. Enables AI-assisted schematic/PCB analysis, netlist tracing, and ERC/DRC directly against `pcbnew` — unblocks the schematic capture and ERC steps above. Editing tools are experimental (manual S-expression manipulation); schematic capture itself should still be done in the KiCad GUI per this file's existing guidance.
- [x] KiCad MCP editing-tool defects found and worked around — 2026-07-30, during `01_power` capture:
  - `add_component_from_library`/`create_kicad_project` stamp a fictional schema `(version 20260306)`/`(generator_version "10.0")` that the installed KiCad 10.0.5 `kicad-cli` refuses to load ("Failed to load schematic" with no further detail). Fix: use a real, backward-compatible schema (`20250114`/`"9.0"`) — confirmed working. Both `SWAFarmNodeV1.kicad_sch` and `.kicad_pcb` had this bad stamp pre-existing from an earlier session and were corrected as part of this milestone.
  - `add_component_from_library` never writes the `(instances (project "..." (path "/<sheet-uuid>" (reference "...") (unit N))))` sub-block that modern KiCad schematic format requires per symbol instance. Without it, `kicad-cli sch erc` reports every pin on that symbol as "not connected" even when wires/labels are geometrically exact — this was the dominant source of false ERC errors this session, not bad coordinates. Fix: inject the block manually after placement.
  - `add_wire` silently accepts more than 2 points and writes an invalid multi-point `(wire (pts ...))` element that fails to load entirely. Always call it with exactly 2 points per segment; use multiple calls for bends.
  - Pin absolute position = `(symbol_origin_x + pin_local_x, symbol_origin_y − pin_local_y)` — the Y offset from a symbol's own library definition is negated when placed on a sheet (library Y-up vs. sheet Y-down). Getting this backwards silently swaps which physical pin a wire lands on (caught via `kicad-cli sch export netlist`, not ERC).
  - `setup_pcb_layout` fills the new `.kicad_pcb` with an unrelated placeholder footprint/nets and an invalid `title_block` field (`ki_producers`) that also fails to load — both were stripped out; only the board outline was kept.
  - No footprint-placement or routing tool exists in this MCP server's toolset — DRC is only meaningful after that's done in the KiCad GUI.
- [x] Schematic-file structure gotcha found — 2026-07-31, during `06_Relay` bulk capture (66 new components, generated by script and spliced directly into the `.kicad_sch` rather than placed one-by-one via MCP, since per-component tool calls were impractical at this scale): `(lib_symbols ...)` closes far earlier in this file than the top-level `(sheet_instances ...)` block appears — a large run of legacy verbose-format placed symbols (from early `01_power`/`02_MCU` capture) sits between the two. Splicing new library-template content in based on adjacency to `(sheet_instances ...)` lands inside the placed-symbol region instead, and even after locating the real closing paren (via a string-aware, quote-respecting paren-depth counter — a naive counter can be fooled by parentheses inside property text like Description/Datasheet fields), new content must be inserted **before** that closing paren, not after — inserting after silently places new symbol templates outside `lib_symbols` entirely. Both mistakes produced files that parsed fine under the MCP server's own lenient parser (`get_schematic_info` reported the correct component count either way) but that real `kicad-cli sch erc` flatly refused to load ("Failed to load schematic", no line or reason given). Fix/process: locate `lib_symbols`' true end with a string-aware paren counter, insert new template blocks immediately before that closing paren, and always verify with real `kicad-cli` — never trust the MCP parser alone — before trusting a bulk splice.
- [x] New `add_component_from_library` defect found — 2026-07-31, during `04_RS485` capture: for stock symbols that use KiCad's `extends` inheritance (e.g. `Interface_UART:THVD1450D` extends `MAX481E` extends `LTC2850xS8`), the tool only copies the named symbol's own (often pin-less) block into the schematic's `lib_symbols` cache — it does **not** walk the inheritance chain to pull in the base symbol(s) that actually define the pins/graphics, and it does not warn that the resulting definition is incomplete. The placed instance also only gets as many `(pin ...)` entries as the tool's (wrong) pin count, not the true pin count. Symptom: `add_component_from_library`'s own success message reports an implausibly low pin count (e.g. "2 pins detected" for an 8-pin IC) — treat that as a red flag requiring manual verification via `get_symbol_details()` before wiring. Fix: replace the schematic's cached `lib_symbols` entry with a self-contained definition (no `extends`) carrying the real pins/graphics copied from the ultimate base symbol, and correct the placed instance's pin list to match. Produces one expected, harmless `lib_symbol_mismatch` ERC warning versus KiCad's own stock copy.
- [x] Grid-alignment process error found and fixed — 2026-07-31, during `08_BatterySolar` bulk capture: hand-picked "round number" origin coordinates (e.g. `(200.00, 900.00)`) for new-component placement, forgetting that convenient decimal millimeter values are very often *not* exact multiples of 1.27mm (the KiCad connection grid) — the same class of mistake already documented from `02_MCU`. First ERC pass showed 70 new `endpoint_off_grid` warnings as a result. Fixed with a targeted regex pass snapping only origin-variable assignments (identified by naming convention, e.g. `*_O = (x, y)`) to the nearest 1.27mm multiple — deliberately excluding any coordinate copied from a real, already-existing component pin (e.g. the verified MCU pin used for the battery-voltage ADC connection), since blind-snapping those would silently disconnect the label from the actual pin it needed to reach. Lesson: when bulk-generating placements programmatically, choose grid-valid origins (multiples of 1.27mm, ideally 2.54mm) at the point of picking coordinates, not as a post-hoc fix — and never apply an automated snap/transform across a script without first checking whether any of its coordinates are copied from real, external, must-stay-exact positions.
- [x] PCB footprint placement done via `pcbnew` Python scripting, not direct-file-splice — 2026-07-31, during `09_PCBFloorplan`. No MCP tool exists for PCB footprint placement, board-outline creation, or layer-stack setup (confirmed by searching the full tool list before starting), and `.kicad_pcb` footprint blocks are far larger/more error-prone to hand-author than schematic symbols (full pad/courtyard/silkscreen geometry embedded per placed instance, not a template+instance split). Used KiCad 10's own bundled Python (`C:\Program Files\KiCad\10.0\bin\python.exe`, `pcbnew` module — the same interpreter the MCP server itself runs on) via `pcbnew.FootprintLoad()` to pull real, verified footprint geometry straight from the system libraries, `pcbnew.CreateEmptyBoard()`/`SetCopperLayerCount(4)`/`PCB_SHAPE` for board setup, and per-pad `SetNet()` (matched against a parsed netlist XML) so placed pads carry real net membership for the next milestone's ratsnest/DRC — all far more reliable than the raw-S-expression-splice technique used for schematic work. Separately, a footprint-sizing lesson: the first placement pass estimated component spacing from assumption (e.g., schematic-visual connector pitch) rather than measured geometry, producing 38 courtyard overlaps, 32 net-shorting collisions, and 4 co-located mounting holes on first DRC. Root cause: `footprint.GetBoundingBox()` includes the silkscreen reference-designator text and can overstate a small connector's real size by 3x (e.g. a 3-pin terminal block measured 53mm "wide" by bounding box but only 16mm by courtyard) — the *courtyard* layer (`F.CrtYd`/`B.CrtYd`), not the full bounding box, is the correct measure for real-world spacing. Fixed by querying courtyard geometry directly for every unique footprint before re-placing, then iterating against real `kicad-cli pcb drc` output (not visual inspection) to resolve the remaining handful of collisions. Lesson: for PCB placement work, always measure real courtyard geometry via the API before choosing spacing — the same "verify against real data, don't guess" discipline already applied to library symbols, now applied to physical footprint geometry.

## Notes
- Milestones are appended here per CLAUDE.md instruction; this file tracks completion status only. Design rationale lives in `Documentation/`, normative engineering rules live in `.ai/knowledge/`.
