praveen034u/SWAFarm/Documentation/images/SWAFarmNodeV1_NodeCore_FullSchematic.pdf

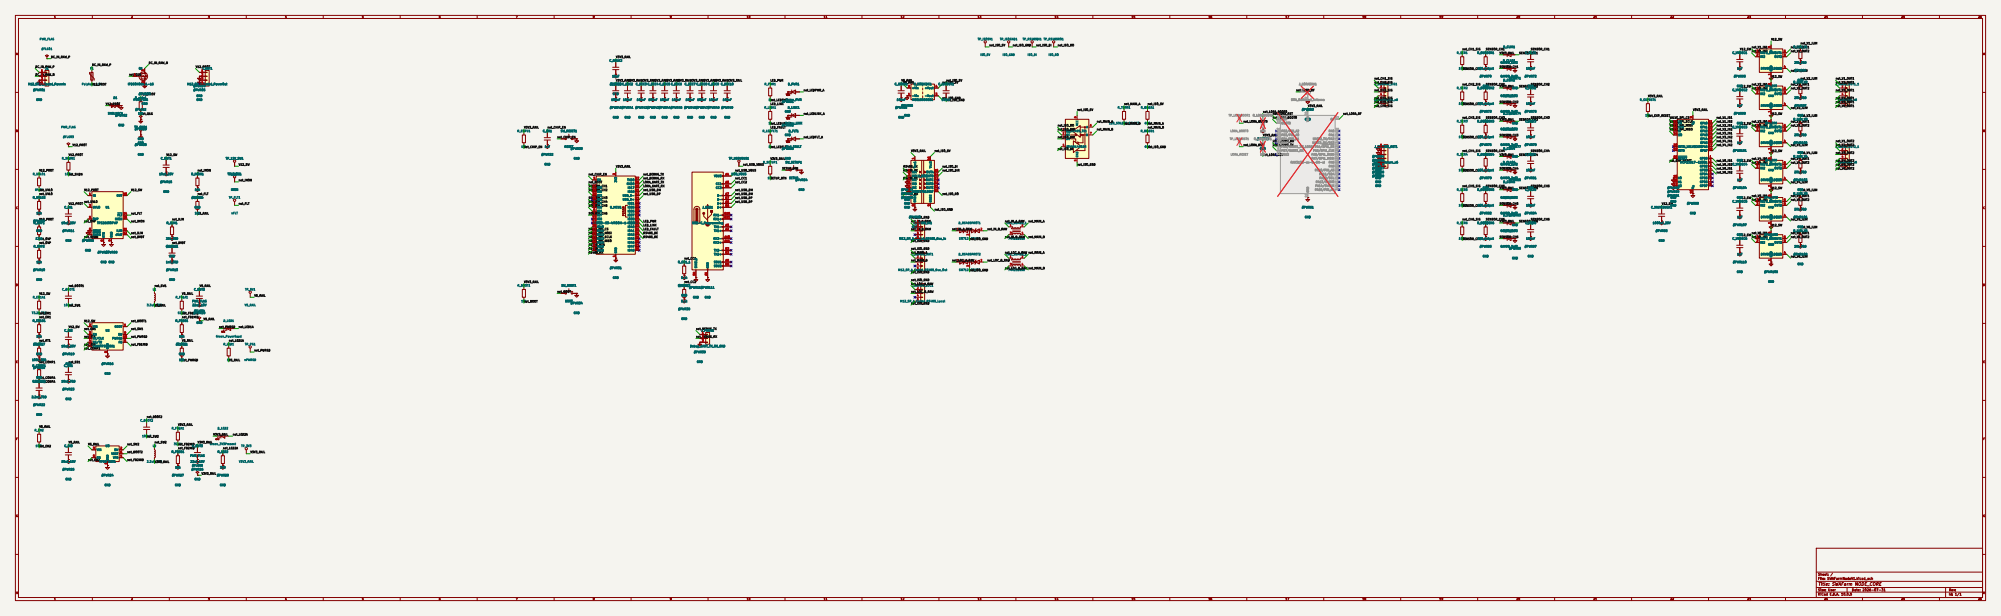
[picture p4: page 1]

Size: User | Rev:
KiCad E.D.A. 10.0.5 | Id: 1/1
