praveen034u/SWAFarm/Hardware/SWAFarmNodeV1/Step-1-PCH.pdf

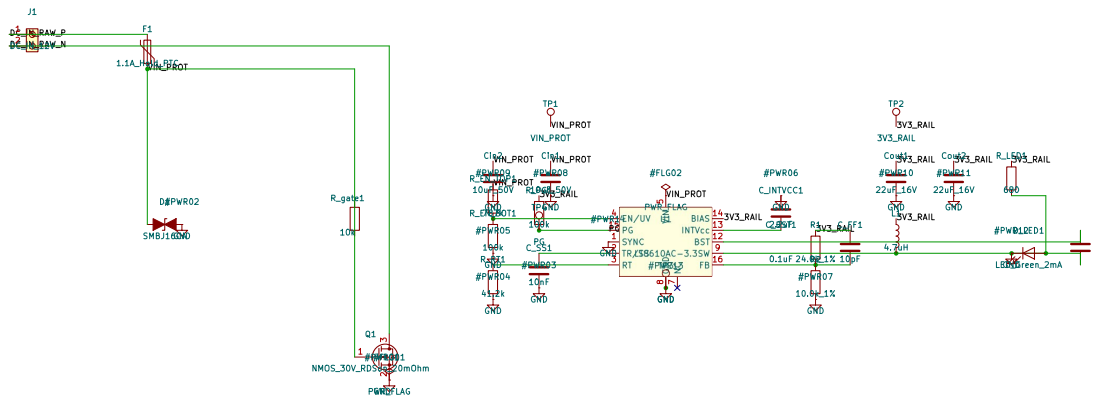
[picture p11: page 1]
