praveen034u/SWAFarm/Hardware/SWAFarmNodeV1/MCU.kicad_sch

## KiCad design Hardware/SWAFarmNodeV1/MCU.kicad_sch (2026-08-05)

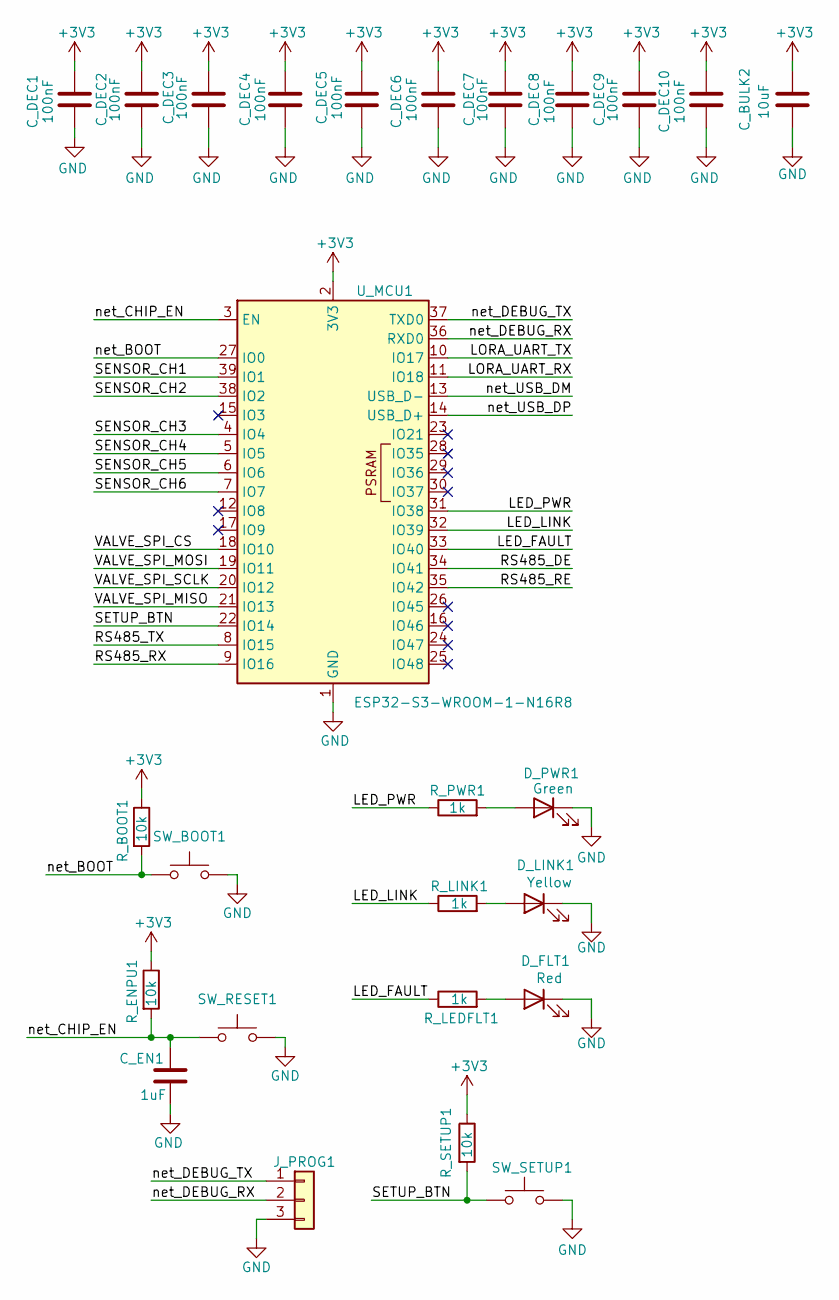
[picture p12: schematic MCU.kicad_sch]

Parts:
C_BULK2: 10uF; C_1206_3216Metric
C_DEC1, C_DEC2, C_DEC3, C_DEC4, C_DEC5, C_DEC6, C_DEC7, C_DEC8, C_DEC9, C_DEC10: 100nF; C_0603_1608Metric
C_EN1: 1uF; C_0805_2012Metric
D_FLT1: Red; LED_0805_2012Metric
D_LINK1: Yellow; LED_0805_2012Metric
D_PWR1: Green; LED_0805_2012Metric
J_PROG1: Debug_UART_TX_RX_GND; PinHeader_1x03_P2.54mm_Vertical
R_BOOT1: 10k; R_0805_2012Metric
R_ENPU1: 10k; R_0805_2012Metric
R_LEDFLT1: 1k; R_0805_2012Metric
R_LINK1: 1k; R_0805_2012Metric
R_PWR1: 1k; R_0805_2012Metric
R_SETUP1: 10k; R_0805_2012Metric
SW_BOOT1: BOOT; SW_SPST_B3U-1000P
SW_RESET1: RESET; SW_SPST_B3U-1000P
SW_SETUP1: SETUP; SW_SPST_B3U-1000P
U_MCU1: ESP32-S3-WROOM-1-N16R8; ESP32-S3-WROOM-1

Connections:
+3V3: C_BULK2.1, C_DEC1.1, C_DEC2.1, C_DEC3.1, C_DEC4.1, C_DEC5.1, C_DEC6.1, C_DEC7.1, C_DEC8.1, C_DEC9.1, C_DEC10.1, R_BOOT1.1, R_ENPU1.1, R_SETUP1.1, U_MCU1.2 (3V3)
GND: C_BULK2.2, C_DEC1.2, C_DEC2.2, C_DEC3.2, C_DEC4.2, C_DEC5.2, C_DEC6.2, C_DEC7.2, C_DEC8.2, C_DEC9.2, C_DEC10.2, C_EN1.2, D_FLT1.1 (K), D_LINK1.1 (K), D_PWR1.1 (K), J_PROG1.3, SW_BOOT1.2, SW_RESET1.2, SW_SETUP1.2, U_MCU1.1 (GND), U_MCU1.40 (GND), U_MCU1.41 (GND)
LED_FAULT: R_LEDFLT1.1, U_MCU1.33 (IO40)
LED_LINK: R_LINK1.1, U_MCU1.32 (IO39)
LED_PWR: R_PWR1.1, U_MCU1.31 (IO38)
LORA_UART_RX: U_MCU1.11 (IO18)
LORA_UART_TX: U_MCU1.10 (IO17)
unnamed: D_FLT1.2 (A), R_LEDFLT1.2
unnamed: D_LINK1.2 (A), R_LINK1.2
unnamed: D_PWR1.2 (A), R_PWR1.2
RS485_DE: U_MCU1.34 (IO41)
RS485_RE: U_MCU1.35 (IO42)
RS485_RX: U_MCU1.9 (IO16)
RS485_TX: U_MCU1.8 (IO15)
SENSOR_CH1: U_MCU1.39 (IO1)
SENSOR_CH2: U_MCU1.38 (IO2)
SENSOR_CH3: U_MCU1.4 (IO4)
SENSOR_CH4: U_MCU1.5 (IO5)
SENSOR_CH5: U_MCU1.6 (IO6)
SENSOR_CH6: U_MCU1.7 (IO7)
SETUP_BTN: R_SETUP1.2, SW_SETUP1.1, U_MCU1.22 (IO14)
VALVE_SPI_CS: U_MCU1.18 (IO10)
VALVE_SPI_MISO: U_MCU1.21 (IO13)
VALVE_SPI_MOSI: U_MCU1.19 (IO11)
VALVE_SPI_SCLK: U_MCU1.20 (IO12)
net_BOOT: R_BOOT1.2, SW_BOOT1.1, U_MCU1.27 (IO0)
net_CHIP_EN: C_EN1.1, R_ENPU1.2, SW_RESET1.1, U_MCU1.3 (EN)
net_DEBUG_RX: J_PROG1.2, U_MCU1.36 (RXD0)
net_DEBUG_TX: J_PROG1.1, U_MCU1.37 (TXD0)
net_USB_DM: U_MCU1.13 (USB_D-)
net_USB_DP: U_MCU1.14 (USB_D+)
