praveen034u/SWAFarm/Hardware/SWAFarmNodeV1/Motor Valve.kicad_sch

## KiCad design Hardware/SWAFarmNodeV1/Motor Valve.kicad_sch (2026-08-05)

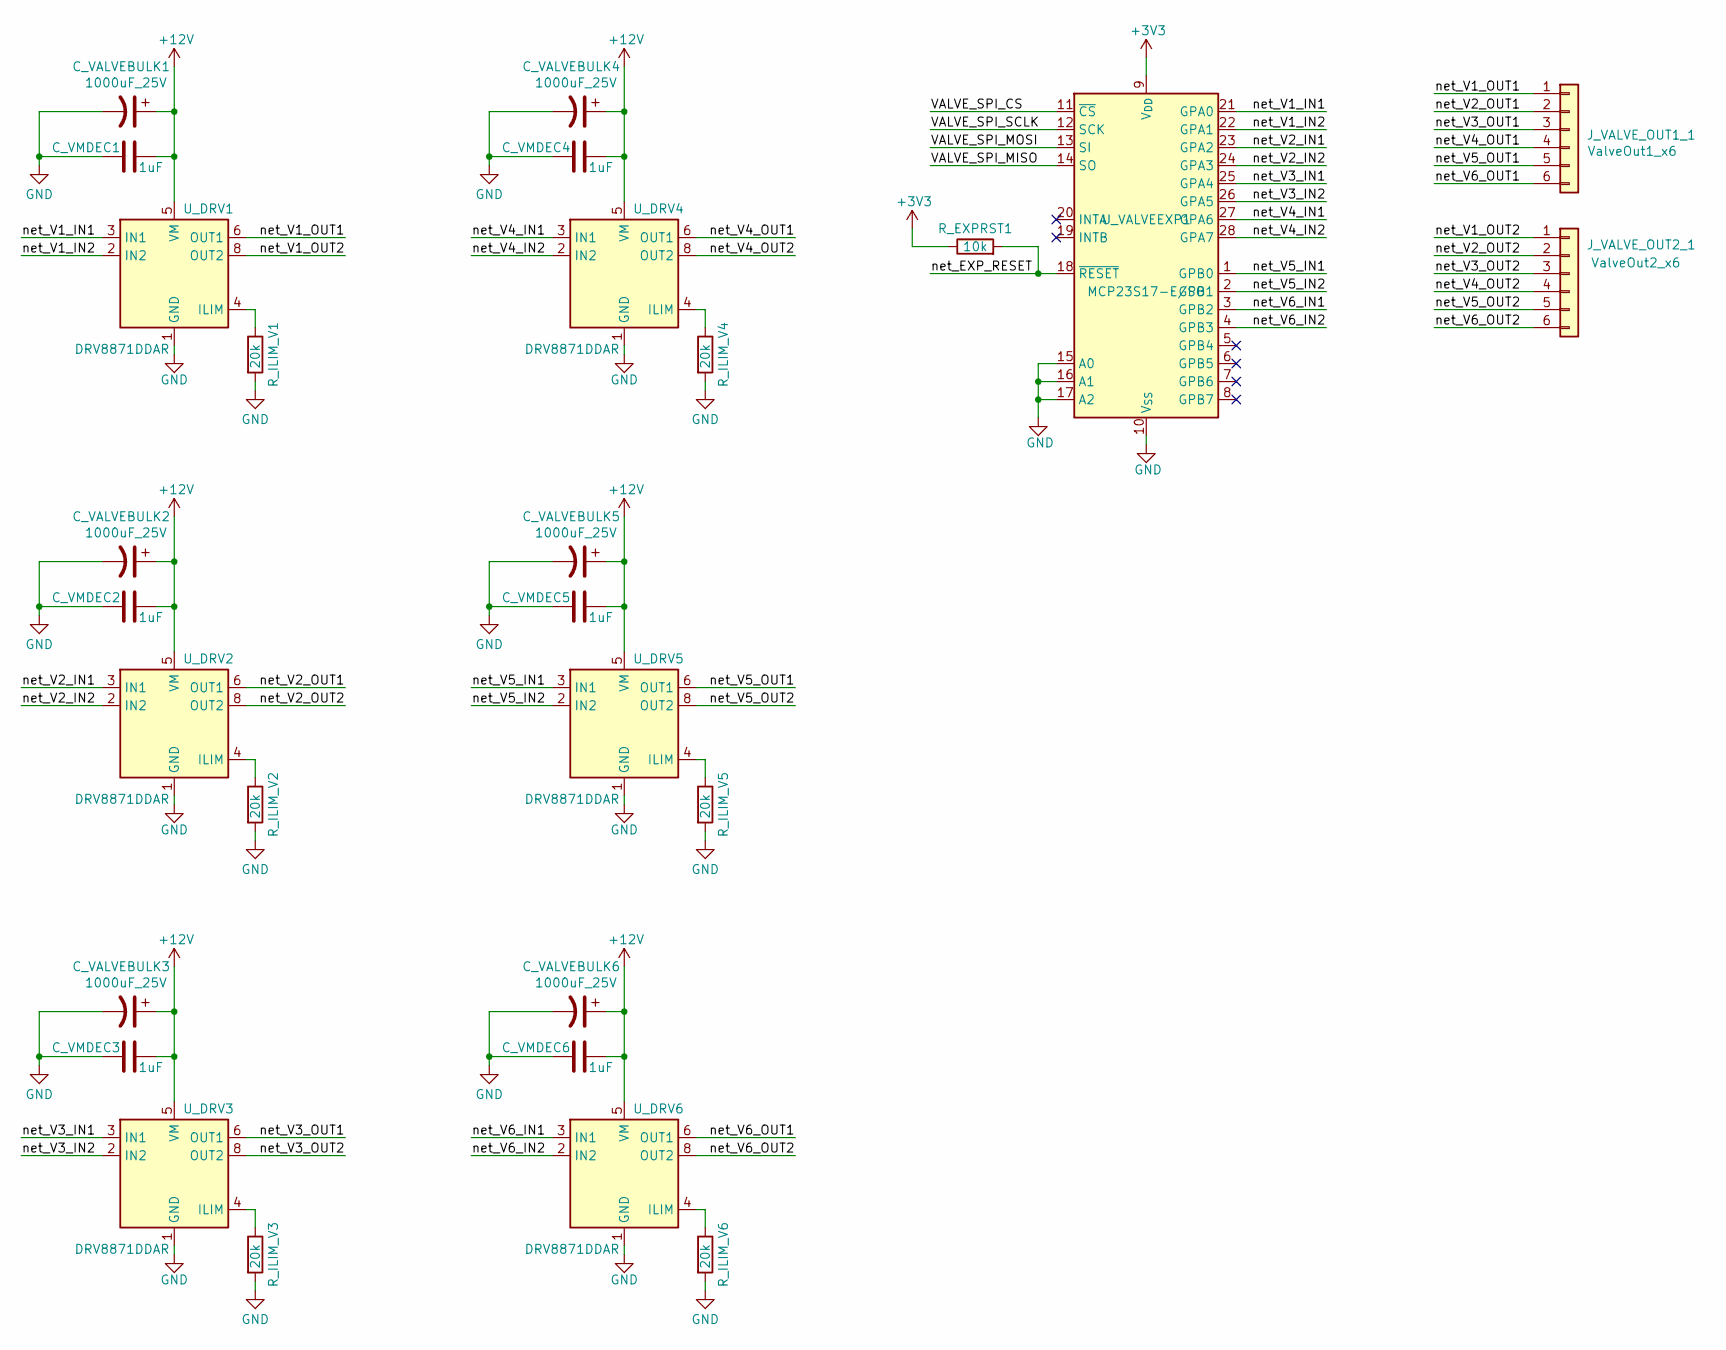
[picture p13: schematic Motor Valve.kicad_sch]

Parts:
C_VALVEBULK1, C_VALVEBULK2, C_VALVEBULK3, C_VALVEBULK4, C_VALVEBULK5, C_VALVEBULK6: 1000uF_25V; CP_Radial_D12.5mm_P5.00mm
C_VMDEC1, C_VMDEC2, C_VMDEC3, C_VMDEC4, C_VMDEC5, C_VMDEC6: 1uF; C_0805_2012Metric
J_VALVE_OUT1_1: ValveOut1_x6; TerminalBlock_Phoenix_MKDS-1,5-6-5.08_1x06_P5.08mm_Horizont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
J_VALVE_OUT2_1: ValveOut2_x6; TerminalBlock_Phoenix_MKDS-1,5-6-5.08_1x06_P5.08mm_Horizont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
R_EXPRST1: 10k; R_0805_2012Metric
R_ILIM_V1, R_ILIM_V2, R_ILIM_V3, R_ILIM_V4, R_ILIM_V5, R_ILIM_V6: 20k; R_0805_2012Metric
U_DRV1, U_DRV2, U_DRV3, U_DRV4, U_DRV5, U_DRV6: DRV8871DDAR; TI_SO-PowerPAD-8_ThermalVias
U_VALVEEXP1: MCP23S17-E/SO; SOIC-28W_7.5x17.9mm_P1.27mm

Connections:
+3V3: R_EXPRST1.1, U_VALVEEXP1.9 (V_{DD})
+12V: C_VALVEBULK1.1, C_VALVEBULK2.1, C_VALVEBULK3.1, C_VALVEBULK4.1, C_VALVEBULK5.1, C_VALVEBULK6.1, C_VMDEC1.1, C_VMDEC2.1, C_VMDEC3.1, C_VMDEC4.1, C_VMDEC5.1, C_VMDEC6.1, U_DRV1.5 (VM), U_DRV2.5 (VM), U_DRV3.5 (VM), U_DRV4.5 (VM), U_DRV5.5 (VM), U_DRV6.5 (VM)
GND: C_VALVEBULK1.2, C_VALVEBULK2.2, C_VALVEBULK3.2, C_VALVEBULK4.2, C_VALVEBULK5.2, C_VALVEBULK6.2, C_VMDEC1.2, C_VMDEC2.2, C_VMDEC3.2, C_VMDEC4.2, C_VMDEC5.2, C_VMDEC6.2, R_ILIM_V1.2, R_ILIM_V2.2, R_ILIM_V3.2, R_ILIM_V4.2, R_ILIM_V5.2, R_ILIM_V6.2, U_DRV1.1 (GND), U_DRV1.7 (GND), U_DRV1.9 (GND), U_DRV2.1 (GND), U_DRV2.7 (GND), U_DRV2.9 (GND), U_DRV3.1 (GND), U_DRV3.7 (GND), U_DRV3.9 (GND), U_DRV4.1 (GND), U_DRV4.7 (GND), U_DRV4.9 (GND), U_DRV5.1 (GND), U_DRV5.7 (GND), U_DRV5.9 (GND), U_DRV6.1 (GND), U_DRV6.7 (GND), U_DRV6.9 (GND), U_VALVEEXP1.10 (V_{SS}), U_VALVEEXP1.15 (A0), U_VALVEEXP1.16 (A1), U_VALVEEXP1.17 (A2)
unnamed: R_ILIM_V1.1, U_DRV1.4 (ILIM)
unnamed: R_ILIM_V2.1, U_DRV2.4 (ILIM)
unnamed: R_ILIM_V3.1, U_DRV3.4 (ILIM)
unnamed: R_ILIM_V4.1, U_DRV4.4 (ILIM)
unnamed: R_ILIM_V5.1, U_DRV5.4 (ILIM)
unnamed: R_ILIM_V6.1, U_DRV6.4 (ILIM)
VALVE_SPI_CS: U_VALVEEXP1.11 (~CS)
VALVE_SPI_MISO: U_VALVEEXP1.14 (SO)
VALVE_SPI_MOSI: U_VALVEEXP1.13 (SI)
VALVE_SPI_SCLK: U_VALVEEXP1.12 (SCK)
net_EXP_RESET: R_EXPRST1.2, U_VALVEEXP1.18 (~RESET)
net_V1_IN1: U_DRV1.3 (IN1), U_VALVEEXP1.21 (GPA0)
net_V1_IN2: U_DRV1.2 (IN2), U_VALVEEXP1.22 (GPA1)
net_V1_OUT1: J_VALVE_OUT1_1.1, U_DRV1.6 (OUT1)
net_V1_OUT2: J_VALVE_OUT2_1.1, U_DRV1.8 (OUT2)
net_V2_IN1: U_DRV2.3 (IN1), U_VALVEEXP1.23 (GPA2)
net_V2_IN2: U_DRV2.2 (IN2), U_VALVEEXP1.24 (GPA3)
net_V2_OUT1: J_VALVE_OUT1_1.2, U_DRV2.6 (OUT1)
net_V2_OUT2: J_VALVE_OUT2_1.2, U_DRV2.8 (OUT2)
net_V3_IN1: U_DRV3.3 (IN1), U_VALVEEXP1.25 (GPA4)
net_V3_IN2: U_DRV3.2 (IN2), U_VALVEEXP1.26 (GPA5)
net_V3_OUT1: J_VALVE_OUT1_1.3, U_DRV3.6 (OUT1)
net_V3_OUT2: J_VALVE_OUT2_1.3, U_DRV3.8 (OUT2)
net_V4_IN1: U_DRV4.3 (IN1), U_VALVEEXP1.27 (GPA6)
net_V4_IN2: U_DRV4.2 (IN2), U_VALVEEXP1.28 (GPA7)
net_V4_OUT1: J_VALVE_OUT1_1.4, U_DRV4.6 (OUT1)
net_V4_OUT2: J_VALVE_OUT2_1.4, U_DRV4.8 (OUT2)
net_V5_IN1: U_DRV5.3 (IN1), U_VALVEEXP1.1 (GPB0)
net_V5_IN2: U_DRV5.2 (IN2), U_VALVEEXP1.2 (GPB1)
net_V5_OUT1: J_VALVE_OUT1_1.5, U_DRV5.6 (OUT1)
net_V5_OUT2: J_VALVE_OUT2_1.5, U_DRV5.8 (OUT2)
net_V6_IN1: U_DRV6.3 (IN1), U_VALVEEXP1.3 (GPB2)
net_V6_IN2: U_DRV6.2 (IN2), U_VALVEEXP1.4 (GPB3)
net_V6_OUT1: J_VALVE_OUT1_1.6, U_DRV6.6 (OUT1)
net_V6_OUT2: J_VALVE_OUT2_1.6, U_DRV6.8 (OUT2)
