praveen034u/SWAFarm/Hardware/SWAFarmNodeV1/Power.kicad_sch

## KiCad design Hardware/SWAFarmNodeV1/Power.kicad_sch (2026-08-05)

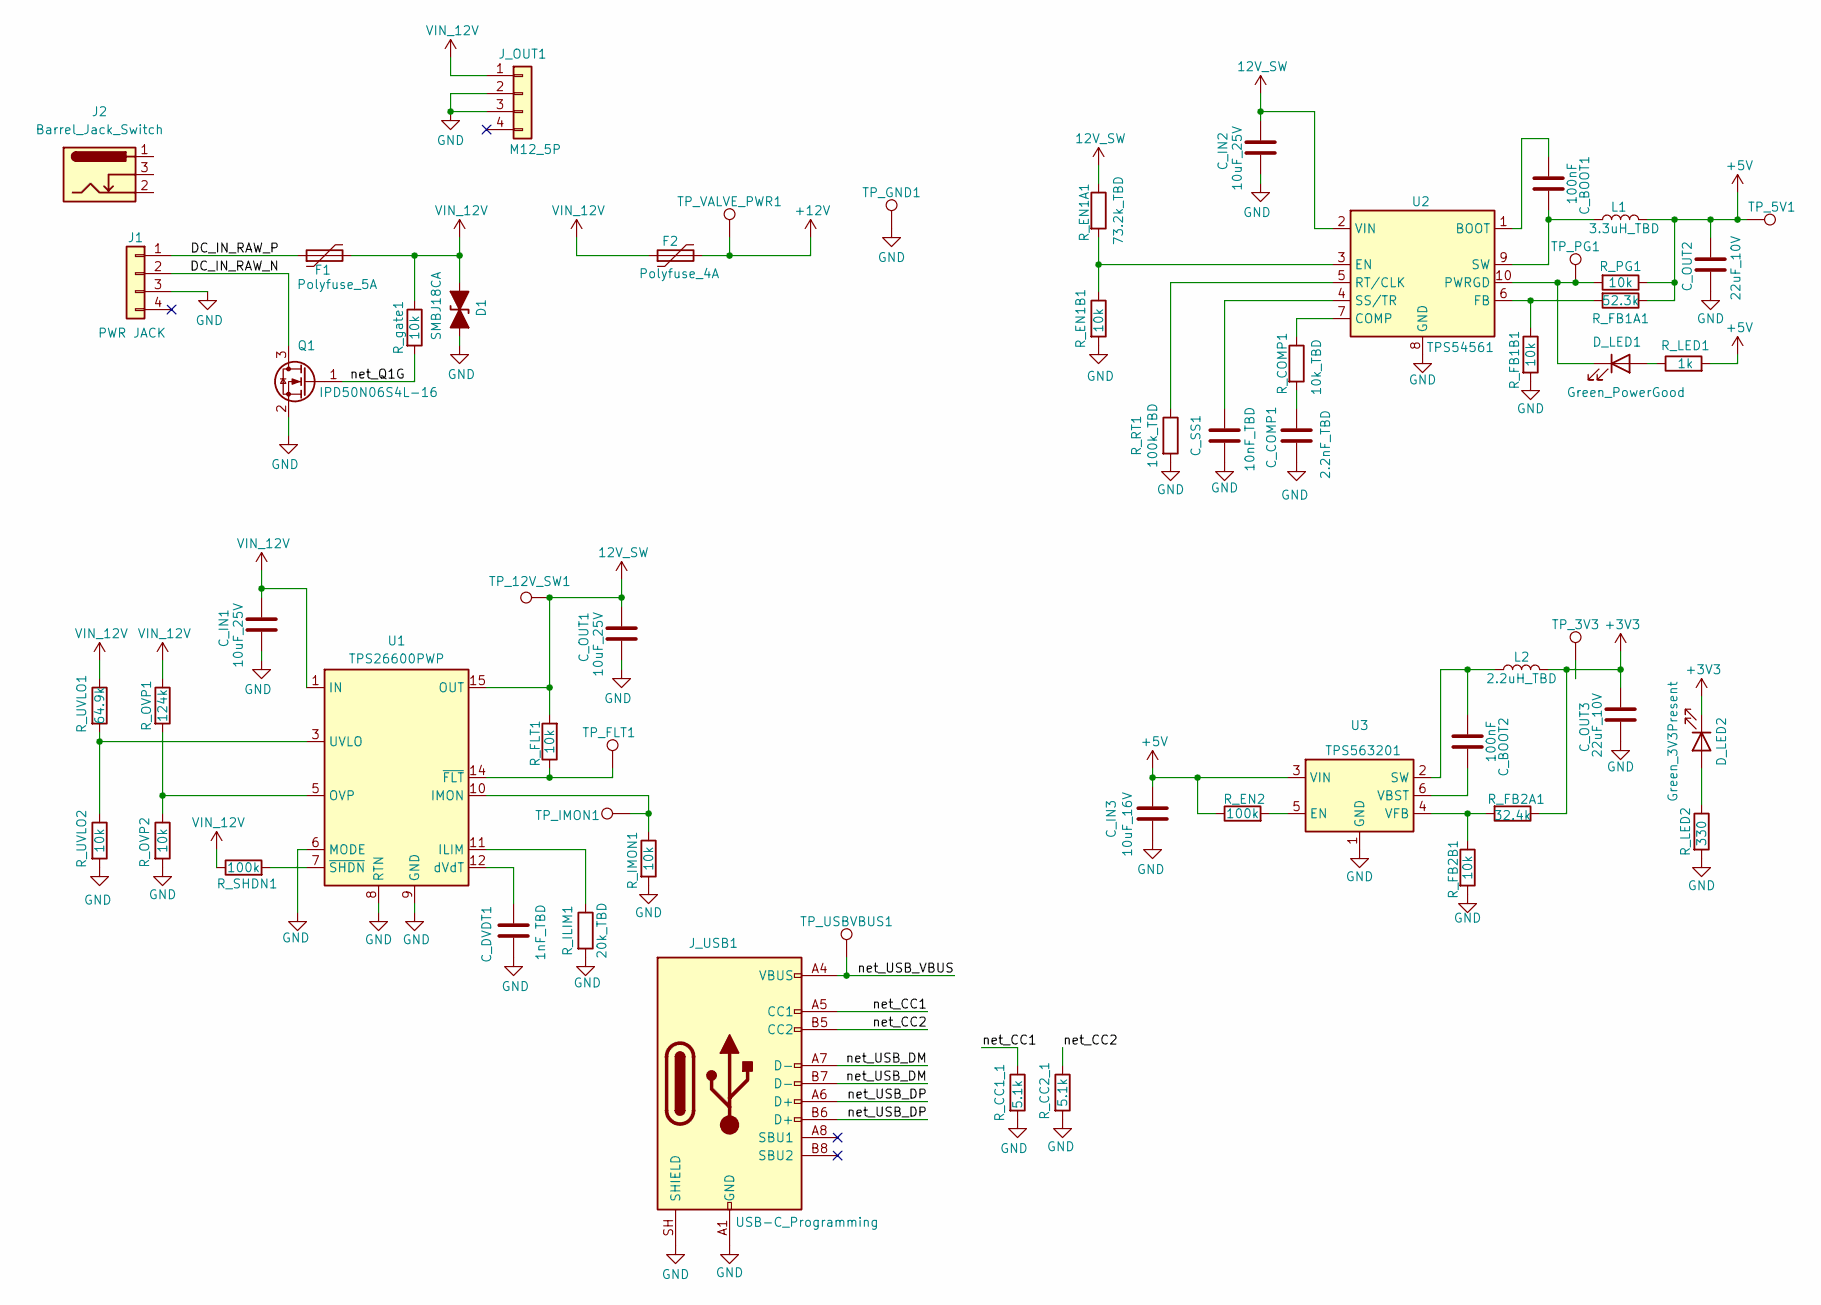
[picture p14: schematic Power.kicad_sch]

Parts:
C_BOOT1, C_BOOT2: 100nF; C_0603_1608Metric
C_COMP1: 2.2nF_TBD; C_0603_1608Metric
C_DVDT1: 1nF_TBD; C_0805_2012Metric
C_IN1, C_IN2: 10uF_25V; C_1206_3216Metric
C_IN3: 10uF_16V; C_1206_3216Metric
C_OUT1: 10uF_25V; C_1206_3216Metric
C_OUT2, C_OUT3: 22uF_10V; C_1206_3216Metric
C_SS1: 10nF_TBD; C_0603_1608Metric
D1: SMBJ18CA; D_SMB
D_LED1: Green_PowerGood; LED_0805_2012Metric
D_LED2: Green_3V3Present; LED_0805_2012Metric
F1: Polyfuse_5A; Fuse_1812_4532Metric
F2: Polyfuse_4A; Fuse_1812_4532Metric
J1: PWR JACK; PinHeader_1x04_P2.54mm_Vertical
J2: Barrel_Jack_Switch
J_OUT1: M12_5P; PinHeader_1x04_P2.54mm_Vertical
J_USB1: USB-C_Programming; USB_C_Receptacle_HRO_TYPE-C-31-M-12
L1: 3.3uH_TBD; L_Bourns-SRN6028
L2: 2.2uH_TBD; L_Bourns-SRN4018
Q1: IPD50N06S4L-16; SOT-23
R_CC1_1, R_CC2_1: 5.1k; R_0805_2012Metric
R_COMP1: 10k_TBD; R_0805_2012Metric
R_EN1A1: 73.2k_TBD; R_0805_2012Metric
R_EN1B1: 10k; R_0805_2012Metric
R_EN2: 100k; R_0805_2012Metric
R_FB1A1: 52.3k; R_0805_2012Metric
R_FB1B1, R_FB2B1: 10k; R_0805_2012Metric
R_FB2A1: 32.4k; R_0805_2012Metric
R_FLT1: 10k; R_0805_2012Metric
R_ILIM1: 20k_TBD; R_0805_2012Metric
R_IMON1: 10k; R_0805_2012Metric
R_LED1: 1k; R_0805_2012Metric
R_LED2: 330; R_0805_2012Metric
R_OVP1: 124k; R_0805_2012Metric
R_OVP2: 10k; R_0805_2012Metric
R_PG1: 10k; R_0805_2012Metric
R_RT1: 100k_TBD; R_0805_2012Metric
R_SHDN1: 100k; R_0805_2012Metric
R_UVLO1: 64.9k; R_0805_2012Metric
R_UVLO2: 10k; R_0805_2012Metric
R_gate1: 10k; R_0805_2012Metric
TP_3V3: V3V3_RAIL; TestPoint_Pad_D1.5mm
TP_5V1: V5_RAIL; TestPoint_Pad_D1.5mm
TP_12V_SW1: V12_SW; TestPoint_Pad_D1.5mm
TP_FLT1: nFLT; TestPoint_Pad_D1.5mm
TP_GND1: GND; TestPoint_Pad_D1.5mm
TP_IMON1: IMON; TestPoint_Pad_D1.5mm
TP_PG1: nPWRGD; TestPoint_Pad_D1.5mm
TP_USBVBUS1: USB_VBUS; TestPoint_Pad_D1.5mm
TP_VALVE_PWR1: V12_VALVE; TestPoint_Pad_D1.5mm
U1: TPS26600PWP; HTSSOP-16-1EP_4.4x5mm_P0.65mm_EP3.4x5mm_Mask2.66x2.46mm_The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
U2: TPS54561; WSON-10-1EP_4x4mm_P0.8mm_EP2.6x3mm_ThermalVias
U3: TPS563201; SOT-23-6

Connections:
12V_SW: C_IN2.1, C_OUT1.1, R_EN1A1.1, R_FLT1.2, TP_12V_SW1.1, U1.15 (OUT), U1.16 (OUT), U2.2 (VIN)
+3V3: C_OUT3.1, D_LED2.1 (K), L2.2, R_FB2A1.1
+5V: C_IN3.1, C_OUT2.1, L1.2, R_EN2.1, R_FB1A1.1, R_LED1.2, R_PG1.1, TP_5V1.1, U3.3 (VIN)
+12V: F2.2, TP_VALVE_PWR1.1
DC_IN_RAW_N: J1.2, Q1.3 (D)
DC_IN_RAW_P: F1.1, J1.1
GND: C_COMP1.2, C_DVDT1.2, C_IN1.2, C_IN2.2, C_IN3.2, C_OUT1.2, C_OUT2.2, C_OUT3.2, C_SS1.2, D1.2 (A2), J1.3, J_OUT1.2, J_OUT1.3, J_USB1.A1 (GND), J_USB1.A12 (GND), J_USB1.B1 (GND), J_USB1.B12 (GND), J_USB1.SH (SHIELD), Q1.2 (S), R_CC1_1.2, R_CC2_1.2, R_EN1B1.2, R_FB1B1.2, R_FB2B1.2, R_ILIM1.2, R_IMON1.2, R_LED2.2, R_OVP2.2, R_RT1.2, R_UVLO2.2, TP_GND1.1, U1.6 (MODE), U1.8 (RTN), U1.9 (GND), U1.17 (RTN), U2.8 (GND), U2.11 (GND), U3.1 (GND)
unnamed: C_BOOT1.1, U2.1 (BOOT)
unnamed: C_BOOT1.2, L1.1, U2.9 (SW)
unnamed: C_BOOT2.1, U3.6 (VBST)
unnamed: C_BOOT2.2, L2.1, U3.2 (SW)
unnamed: C_COMP1.1, R_COMP1.2
unnamed: C_DVDT1.1, U1.12 (dVdT)
unnamed: C_SS1.1, U2.4 (SS/TR)
unnamed: D_LED1.1 (K), R_PG1.2, TP_PG1.1, U2.10 (PWRGD)
unnamed: D_LED1.2 (A), R_LED1.1
unnamed: D_LED2.2 (A), R_LED2.1
unnamed: R_COMP1.1, U2.7 (COMP)
unnamed: R_EN1A1.2, R_EN1B1.1, U2.3 (EN)
unnamed: R_EN2.2, U3.5 (EN)
unnamed: R_FB1A1.2, R_FB1B1.1, U2.6 (FB)
unnamed: R_FB2A1.2, R_FB2B1.1, U3.4 (VFB)
unnamed: R_FLT1.1, TP_FLT1.1, U1.14 (~FLT)
unnamed: R_ILIM1.1, U1.11 (ILIM)
unnamed: R_IMON1.1, TP_IMON1.1, U1.10 (IMON)
unnamed: R_OVP1.2, R_OVP2.1, U1.5 (OVP)
unnamed: R_RT1.1, U2.5 (RT/CLK)
unnamed: R_SHDN1.2, U1.7 (~SHDN)
unnamed: R_UVLO1.2, R_UVLO2.1, U1.3 (UVLO)
VIN_12V: C_IN1.1, D1.1 (A1), F1.2, F2.1, J_OUT1.1, R_OVP1.1, R_SHDN1.1, R_UVLO1.1, R_gate1.1, U1.1 (IN), U1.2 (IN)
net_CC1: J_USB1.A5 (CC1), R_CC1_1.1
net_CC2: J_USB1.B5 (CC2), R_CC2_1.1
net_Q1G: Q1.1 (G), R_gate1.2
net_USB_DM: J_USB1.A7 (D-), J_USB1.B7 (D-)
net_USB_DP: J_USB1.A6 (D+), J_USB1.B6 (D+)
net_USB_VBUS: J_USB1.A4 (VBUS), J_USB1.A9 (VBUS), J_USB1.B4 (VBUS), J_USB1.B9 (VBUS), TP_USBVBUS1.1
