praveen034u/SWAFarm/Hardware/SWAFarmNodeV1/RS-485.kicad_sch

## KiCad design Hardware/SWAFarmNodeV1/RS-485.kicad_sch (2026-08-05)

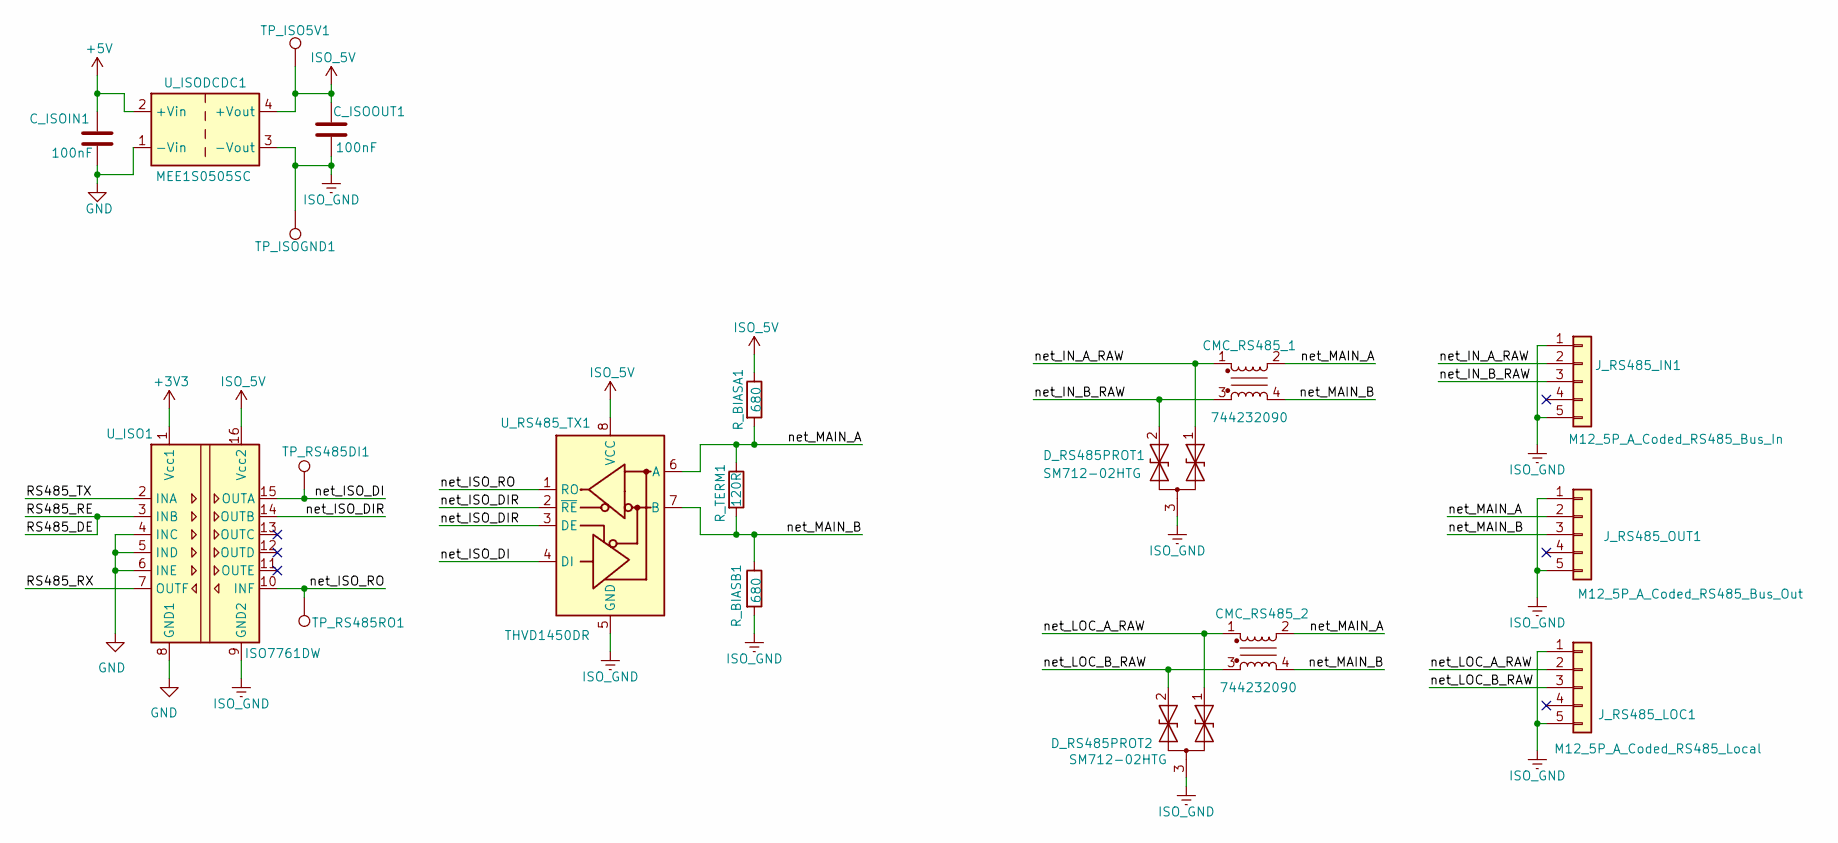
[picture p15: schematic RS-485.kicad_sch]

Parts:
CMC_RS485_1, CMC_RS485_2: 744232090; L_CommonModeChoke_Bourns_SRF1260
C_ISOIN1: 100nF; C_0603_1608Metric
C_ISOOUT1: 100nF; C_0603_1608Metric
D_RS485PROT1, D_RS485PROT2: SM712-02HTG; SOT-23
J_RS485_IN1: M12_5P_A_Coded_RS485_Bus_In; PinHeader_1x05_P2.54mm_Vertical
J_RS485_LOC1: M12_5P_A_Coded_RS485_Local; PinHeader_1x05_P2.54mm_Vertical
J_RS485_OUT1: M12_5P_A_Coded_RS485_Bus_Out; PinHeader_1x05_P2.54mm_Vertical
R_BIASA1: 680; R_0805_2012Metric
R_BIASB1: 680; R_0805_2012Metric
R_TERM1: 120R; R_0805_2012Metric
TP_ISO5V1: ISO_5V; TestPoint_Pad_D1.5mm
TP_ISOGND1: ISO_GND; TestPoint_Pad_D1.5mm
TP_RS485DI1: ISO_DI; TestPoint_Pad_D1.5mm
TP_RS485RO1: ISO_RO; TestPoint_Pad_D1.5mm
U_ISO1: ISO7761DW; SOIC-16W_7.5x10.3mm_P1.27mm
U_ISODCDC1: MEE1S0505SC; Converter_DCDC_Murata_MEE1SxxxxSC_THT
U_RS485_TX1: THVD1450DR; SOIC-8_3.9x4.9mm_P1.27mm

Connections:
+3V3: U_ISO1.1 (Vcc1)
+5V: C_ISOIN1.1, U_ISODCDC1.2 (+Vin)
GND: C_ISOIN1.2, U_ISO1.4 (INC), U_ISO1.5 (IND), U_ISO1.6 (INE), U_ISO1.8 (GND1), U_ISODCDC1.1 (-Vin)
ISO_5V: C_ISOOUT1.1, R_BIASA1.1, TP_ISO5V1.1, U_ISO1.16 (Vcc2), U_ISODCDC1.4 (+Vout), U_RS485_TX1.8 (VCC)
ISO_GND: C_ISOOUT1.2, D_RS485PROT1.3 (common), D_RS485PROT2.3 (common), J_RS485_IN1.1, J_RS485_IN1.5, J_RS485_LOC1.1, J_RS485_LOC1.5, J_RS485_OUT1.1, J_RS485_OUT1.5, R_BIASB1.2, TP_ISOGND1.1, U_ISO1.9 (GND2), U_ISODCDC1.3 (-Vout), U_RS485_TX1.5 (GND)
RS485_DE: U_ISO1.3 (INB)
RS485_RX: U_ISO1.7 (OUTF)
RS485_TX: U_ISO1.2 (INA)
net_IN_A_RAW: CMC_RS485_1.1, D_RS485PROT1.1 (A1), J_RS485_IN1.2
net_IN_B_RAW: CMC_RS485_1.3, D_RS485PROT1.2 (A2), J_RS485_IN1.3
net_ISO_DI: TP_RS485DI1.1, U_ISO1.15 (OUTA), U_RS485_TX1.4 (DI)
net_ISO_DIR: U_ISO1.14 (OUTB), U_RS485_TX1.2 (~RE), U_RS485_TX1.3 (DE)
net_ISO_RO: TP_RS485RO1.1, U_ISO1.10 (INF), U_RS485_TX1.1 (RO)
net_LOC_A_RAW: CMC_RS485_2.1, D_RS485PROT2.1 (A1), J_RS485_LOC1.2
net_LOC_B_RAW: CMC_RS485_2.3, D_RS485PROT2.2 (A2), J_RS485_LOC1.3
net_MAIN_A: CMC_RS485_1.2, CMC_RS485_2.2, J_RS485_OUT1.2, R_BIASA1.2, R_TERM1.1, U_RS485_TX1.6 (A)
net_MAIN_B: CMC_RS485_1.4, CMC_RS485_2.4, J_RS485_OUT1.3, R_BIASB1.1, R_TERM1.2, U_RS485_TX1.7 (B)
