praveen034u/SWAFarm/Hardware/SWAFarmNodeV1/SWAFarmNodeV1.kicad_sch

## KiCad design Hardware/SWAFarmNodeV1/SWAFarmNodeV1.kicad_sch (2026-08-05, an earlier design)

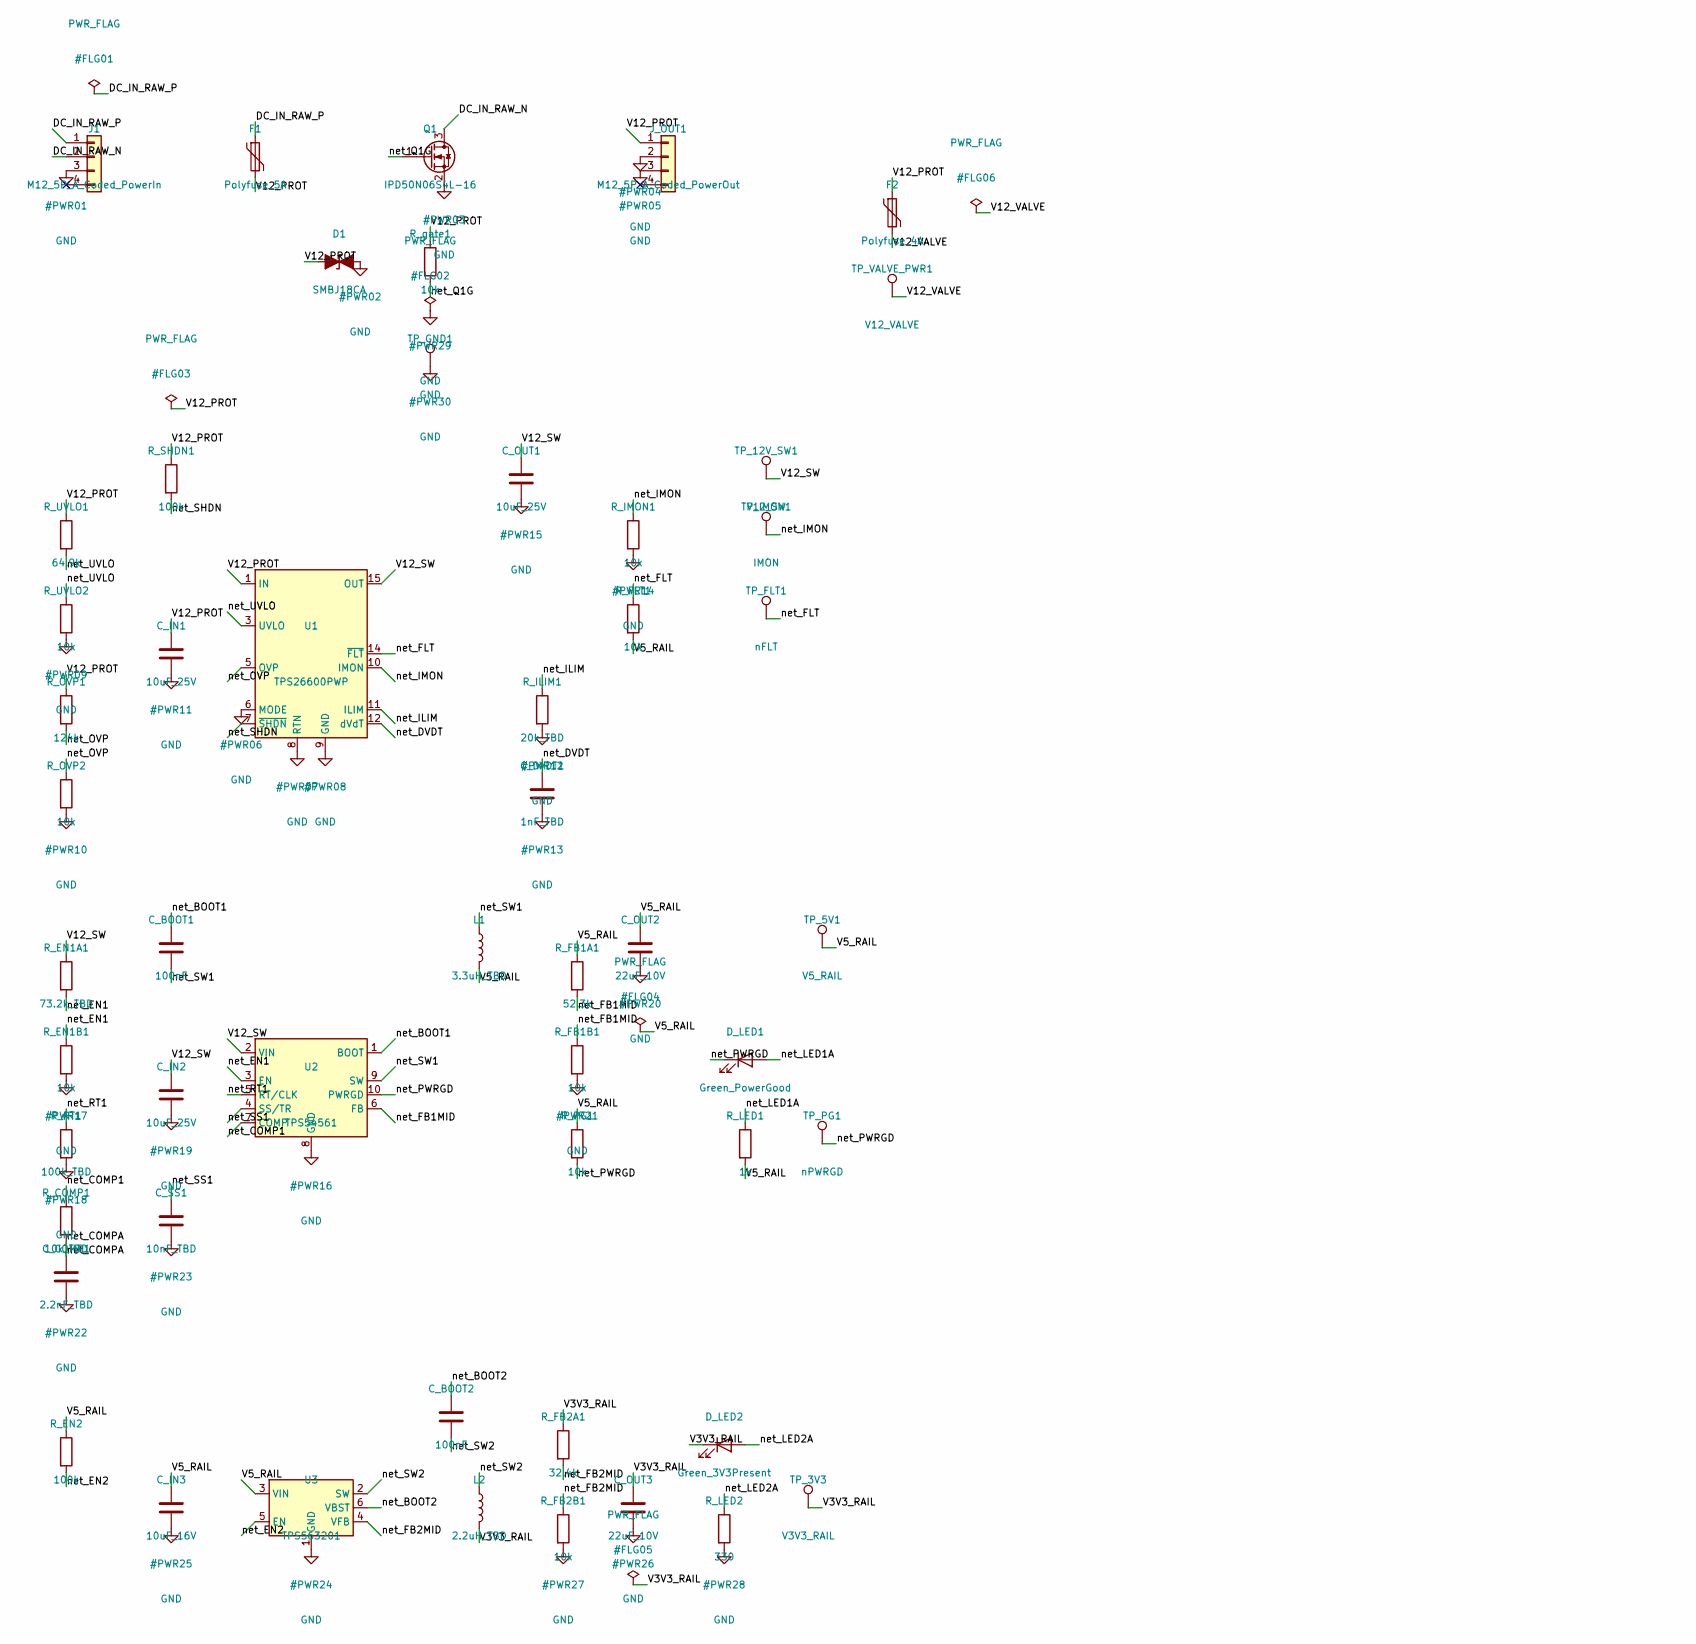
[picture p16: schematic SWAFarmNodeV1.kicad_sch, part in row 1, column 1]

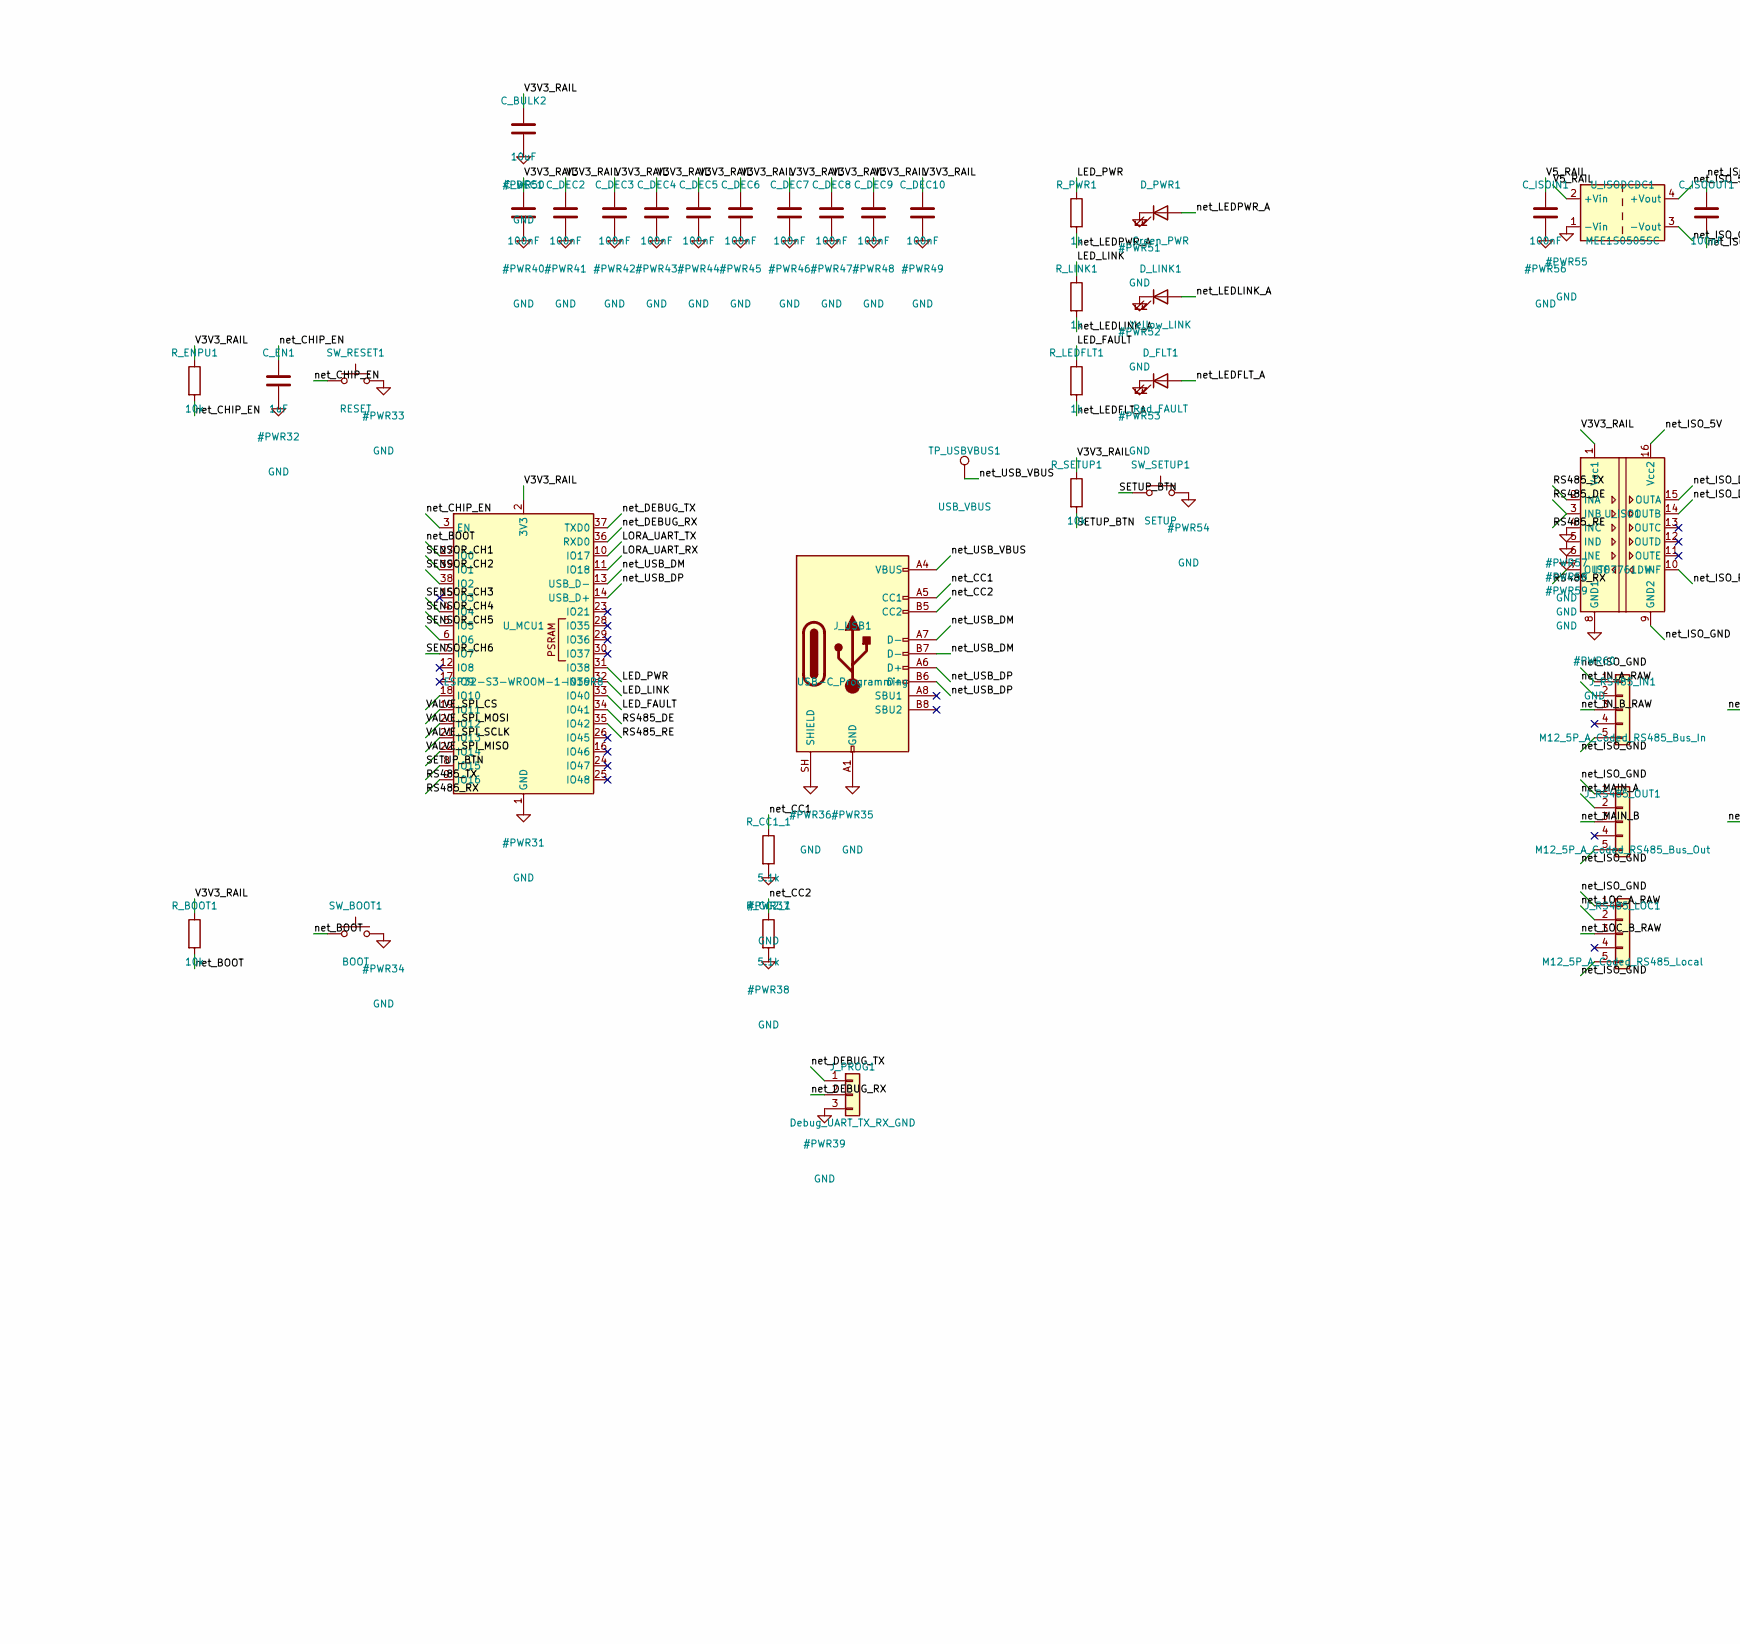
[picture p17: schematic SWAFarmNodeV1.kicad_sch, part in row 1, column 2]

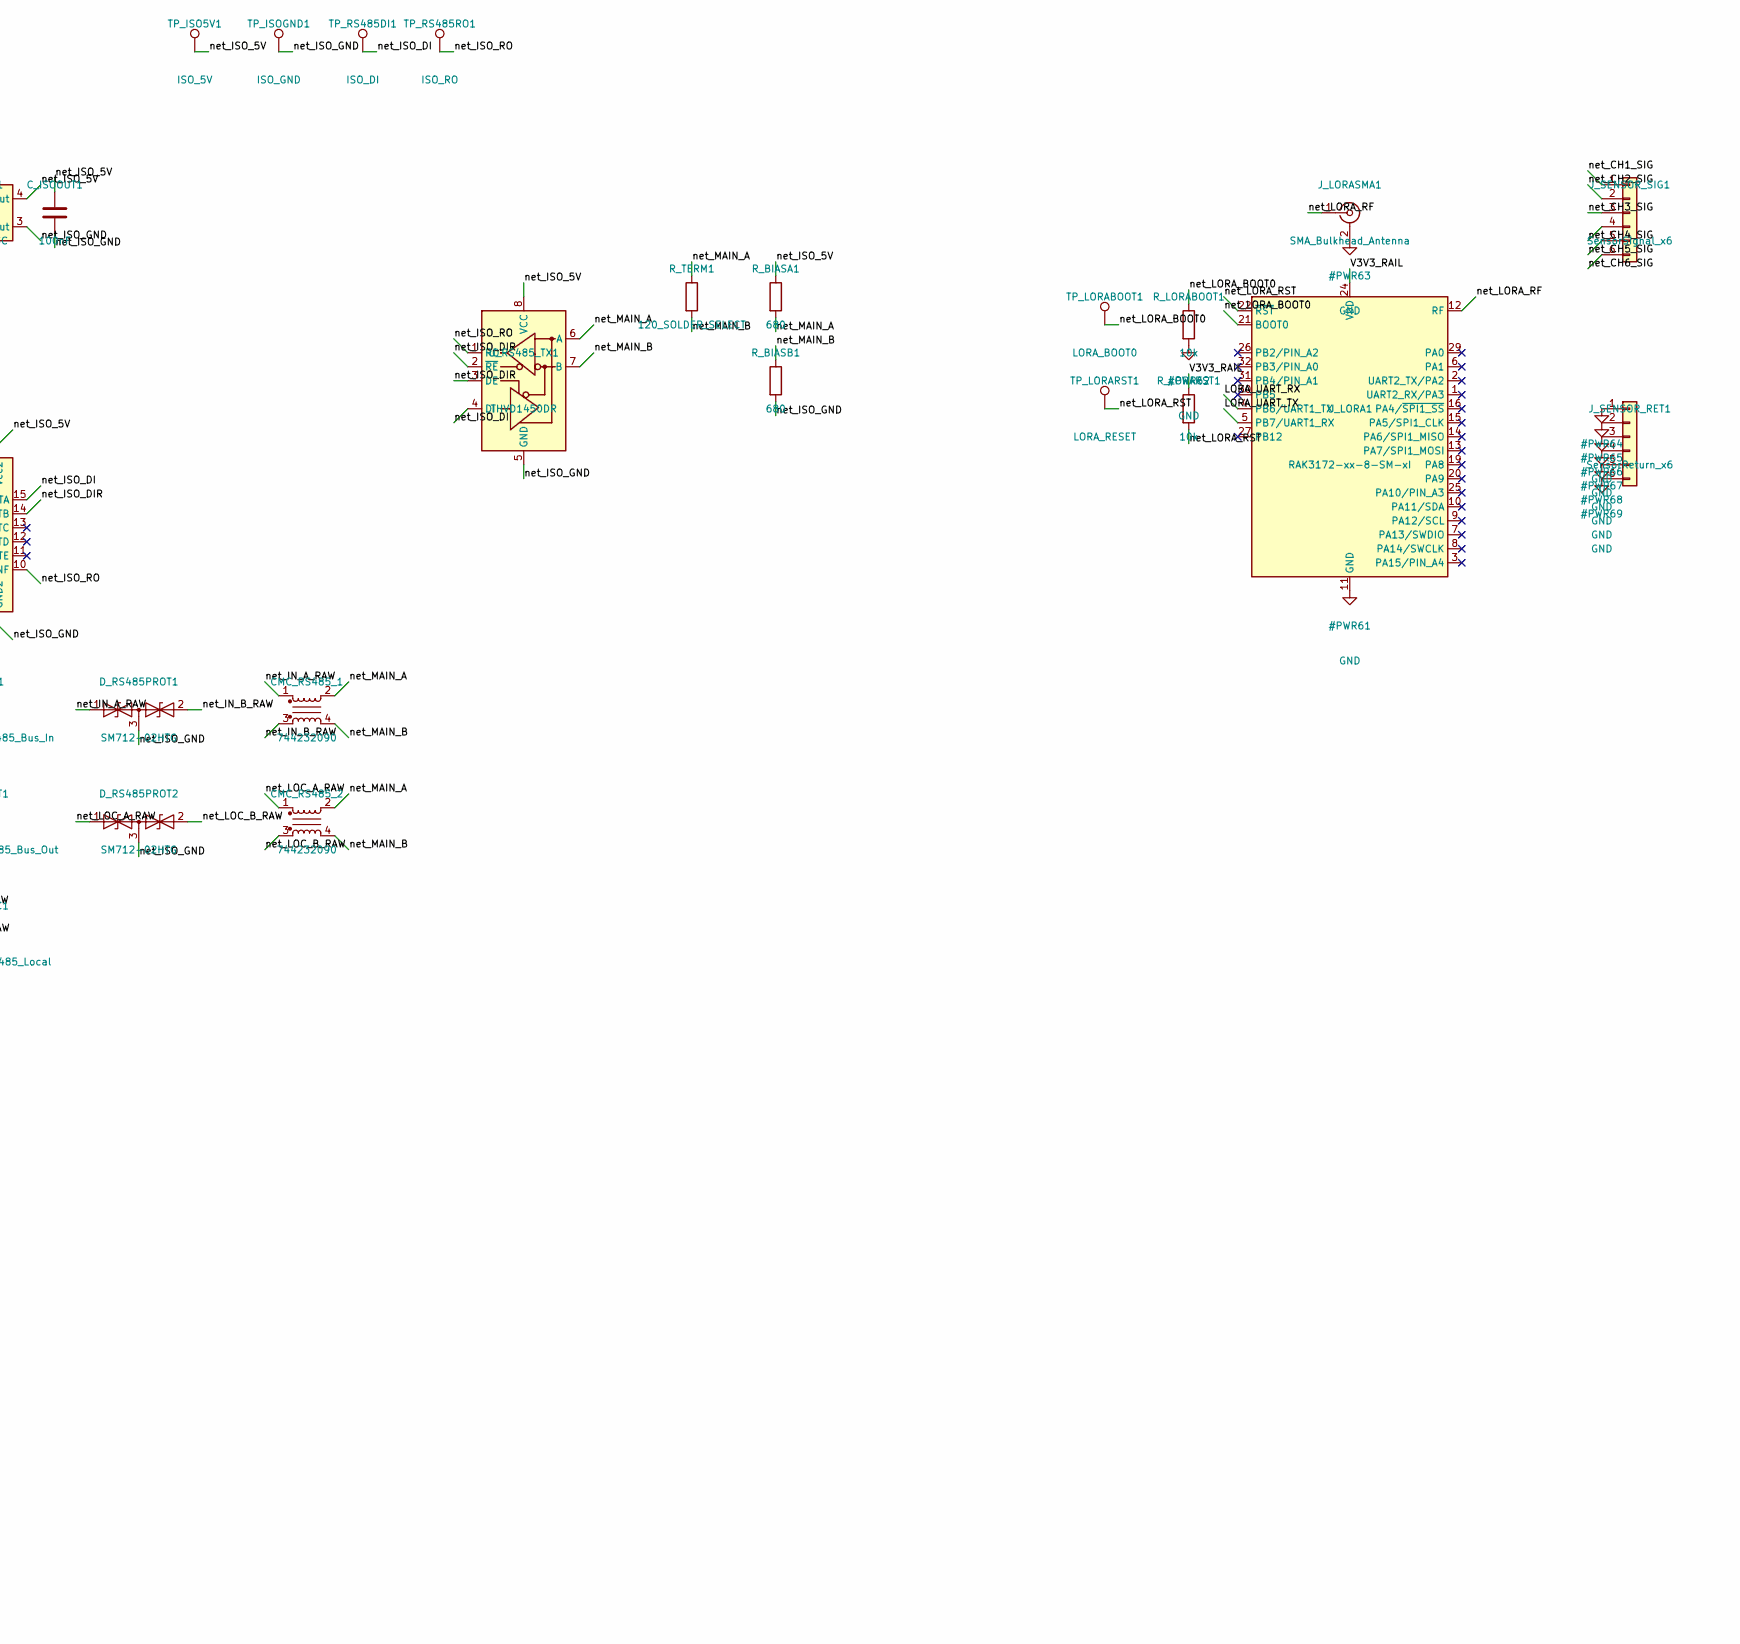
[picture p18: schematic SWAFarmNodeV1.kicad_sch, part in row 1, column 3]

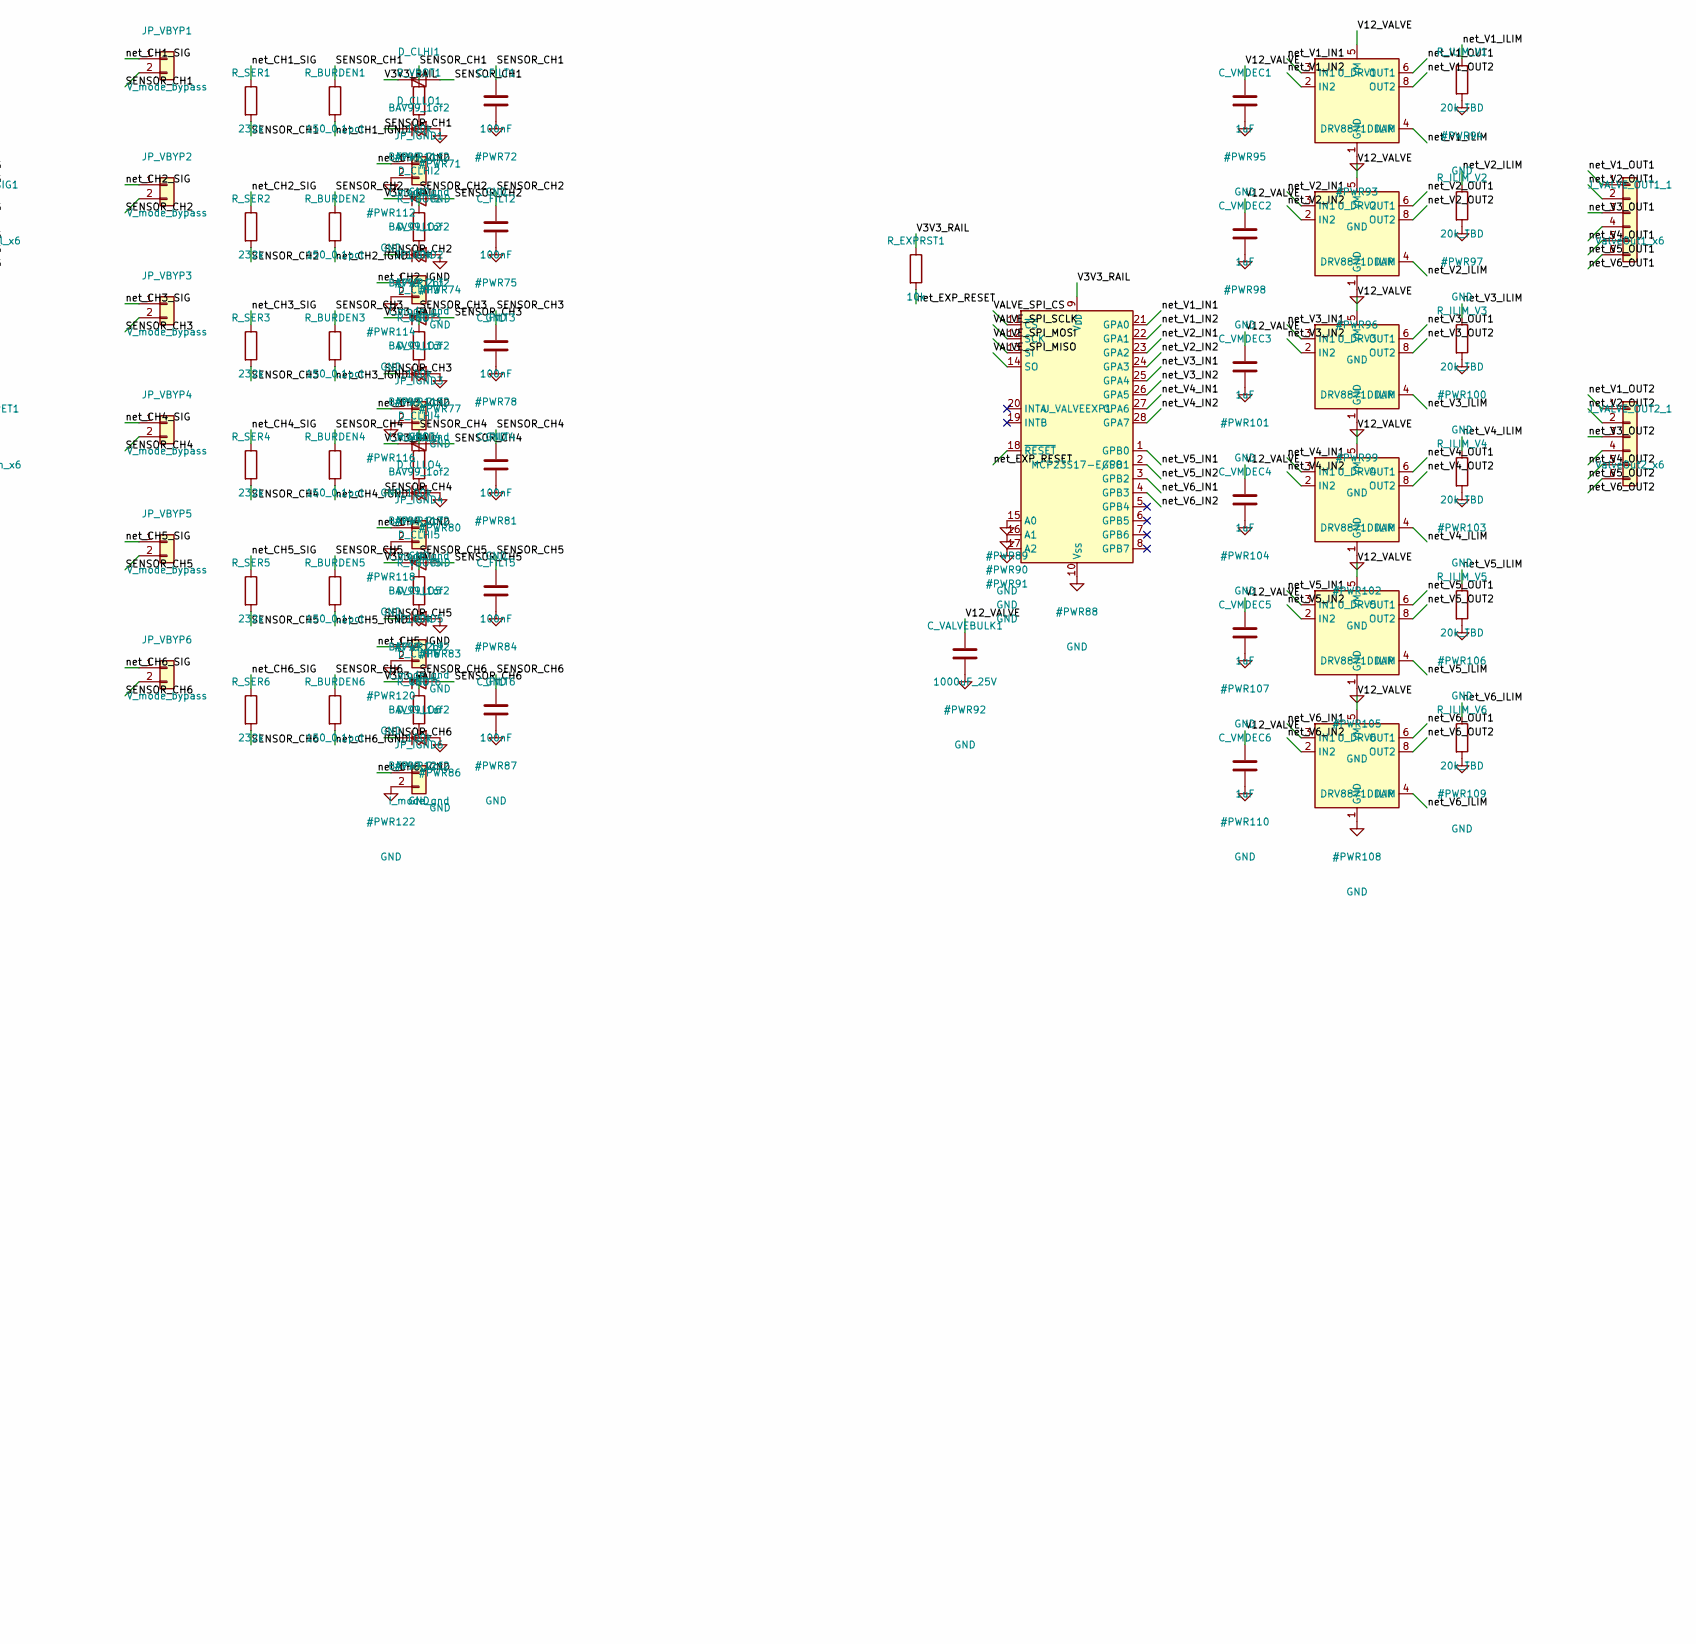
[picture p19: schematic SWAFarmNodeV1.kicad_sch, part in row 1, column 4]

Parts:
CMC_RS485_1, CMC_RS485_2: 744232090; L_CommonModeChoke_Bourns_SRF1260
C_BOOT1, C_BOOT2: 100nF; C_0603_1608Metric
C_BULK2: 10uF; C_1206_3216Metric
C_COMP1: 2.2nF_TBD; C_0603_1608Metric
C_DEC1, C_DEC2, C_DEC3, C_DEC4, C_DEC5, C_DEC6, C_DEC7, C_DEC8, C_DEC9, C_DEC10: 100nF; C_0603_1608Metric
C_DVDT1: 1nF_TBD; C_0805_2012Metric
C_EN1: 1uF; C_0805_2012Metric
C_FILT1, C_FILT2, C_FILT3, C_FILT4, C_FILT5, C_FILT6: 100nF; C_0603_1608Metric
C_IN1, C_IN2: 10uF_25V; C_1206_3216Metric
C_IN3: 10uF_16V; C_1206_3216Metric
C_ISOIN1: 100nF; C_0603_1608Metric
C_ISOOUT1: 100nF; C_0603_1608Metric
C_OUT1: 10uF_25V; C_1206_3216Metric
C_OUT2, C_OUT3: 22uF_10V; C_1206_3216Metric
C_SS1: 10nF_TBD; C_0603_1608Metric
C_VALVEBULK1: 1000uF_25V; CP_Radial_D12.5mm_P5.00mm
C_VMDEC1, C_VMDEC2, C_VMDEC3, C_VMDEC4, C_VMDEC5, C_VMDEC6: 1uF; C_0805_2012Metric
D1: SMBJ18CA; D_SMB
D_CLHI1, D_CLHI2, D_CLHI3, D_CLHI4, D_CLHI5, D_CLHI6: BAV99_1of2; D_SOD-123
D_CLLO1, D_CLLO2, D_CLLO3, D_CLLO4, D_CLLO5, D_CLLO6: BAV99_2of2; D_SOD-123
D_FLT1: Red_FAULT; LED_0805_2012Metric
D_LED1: Green_PowerGood; LED_0805_2012Metric
D_LED2: Green_3V3Present; LED_0805_2012Metric
D_LINK1: Yellow_LINK; LED_0805_2012Metric
D_PWR1: Green_PWR; LED_0805_2012Metric
D_RS485PROT1, D_RS485PROT2: SM712-02HTG; SOT-23
F1: Polyfuse_5A; Fuse_1812_4532Metric
F2: Polyfuse_4A; Fuse_1812_4532Metric
J1: M12_5P_A_Coded_PowerIn; PinHeader_1x04_P2.54mm_Vertical
JP_IGND1, JP_IGND2, JP_IGND3, JP_IGND4, JP_IGND5, JP_IGND6: I_mode_gnd; PinHeader_1x02_P2.54mm_Vertical
JP_VBYP1, JP_VBYP2, JP_VBYP3, JP_VBYP4, JP_VBYP5, JP_VBYP6: V_mode_bypass; PinHeader_1x02_P2.54mm_Vertical
J_LORASMA1: SMA_Bulkhead_Antenna; SMA_Amphenol_132134_Vertical
J_OUT1: M12_5P_A_Coded_PowerOut; PinHeader_1x04_P2.54mm_Vertical
J_PROG1: Debug_UART_TX_RX_GND; PinHeader_1x03_P2.54mm_Vertical
J_RS485_IN1: M12_5P_A_Coded_RS485_Bus_In; PinHeader_1x05_P2.54mm_Vertical
J_RS485_LOC1: M12_5P_A_Coded_RS485_Local; PinHeader_1x05_P2.54mm_Vertical
J_RS485_OUT1: M12_5P_A_Coded_RS485_Bus_Out; PinHeader_1x05_P2.54mm_Vertical
J_SENSOR_RET1: SensorReturn_x6; TerminalBlock_Phoenix_MKDS-1,5-6-5.08_1x06_P5.08mm_Horizont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
J_SENSOR_SIG1: SensorSignal_x6; TerminalBlock_Phoenix_MKDS-1,5-6-5.08_1x06_P5.08mm_Horizont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
J_USB1: USB-C_Programming; USB_C_Receptacle_HRO_TYPE-C-31-M-12
J_VALVE_OUT1_1: ValveOut1_x6; TerminalBlock_Phoenix_MKDS-1,5-6-5.08_1x06_P5.08mm_Horizont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
J_VALVE_OUT2_1: ValveOut2_x6; TerminalBlock_Phoenix_MKDS-1,5-6-5.08_1x06_P5.08mm_Horizont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
L1: 3.3uH_TBD; L_Bourns-SRN6028
L2: 2.2uH_TBD; L_Bourns-SRN4018
Q1: IPD50N06S4L-16; SOT-23
R_BIASA1: 680; R_0805_2012Metric
R_BIASB1: 680; R_0805_2012Metric
R_BOOT1: 10k; R_0805_2012Metric
R_BURDEN1, R_BURDEN2, R_BURDEN3, R_BURDEN4, R_BURDEN5, R_BURDEN6: 150_0.1pct; R_0805_2012Metric
R_CC1_1, R_CC2_1: 5.1k; R_0805_2012Metric
R_COMP1: 10k_TBD; R_0805_2012Metric
R_EN1A1: 73.2k_TBD; R_0805_2012Metric
R_EN1B1: 10k; R_0805_2012Metric
R_EN2: 100k; R_0805_2012Metric
R_ENPU1: 10k; R_0805_2012Metric
R_EXPRST1: 10k; R_0805_2012Metric
R_FB1A1: 52.3k; R_0805_2012Metric
R_FB1B1, R_FB2B1: 10k; R_0805_2012Metric
R_FB2A1: 32.4k; R_0805_2012Metric
R_FLT1: 10k; R_0805_2012Metric
R_ILIM1: 20k_TBD; R_0805_2012Metric
R_ILIM_V1, R_ILIM_V2, R_ILIM_V3, R_ILIM_V4, R_ILIM_V5, R_ILIM_V6: 20k_TBD; R_0805_2012Metric
R_IMON1: 10k; R_0805_2012Metric
R_LED1: 1k; R_0805_2012Metric
R_LED2: 330; R_0805_2012Metric
R_LEDFLT1: 1k; R_0805_2012Metric
R_LINK1: 1k; R_0805_2012Metric
R_LORABOOT1: 10k; R_0805_2012Metric
R_LORARST1: 10k; R_0805_2012Metric
R_OVP1: 124k; R_0805_2012Metric
R_OVP2: 10k; R_0805_2012Metric
R_PG1: 10k; R_0805_2012Metric
R_PWR1: 1k; R_0805_2012Metric
R_RT1: 100k_TBD; R_0805_2012Metric
R_SER1, R_SER2, R_SER3, R_SER4, R_SER5, R_SER6: 232k; R_0805_2012Metric
R_SETUP1: 10k; R_0805_2012Metric
R_SHDN1: 100k; R_0805_2012Metric
R_TERM1: 120_SOLDER_SELECT; R_0805_2012Metric
R_UVLO1: 64.9k; R_0805_2012Metric
R_UVLO2: 10k; R_0805_2012Metric
R_VBOT1, R_VBOT2, R_VBOT3, R_VBOT4, R_VBOT5, R_VBOT6: 100k; R_0805_2012Metric
R_gate1: 10k; R_0805_2012Metric
SW_BOOT1: BOOT; SW_SPST_B3U-1000P
SW_RESET1: RESET; SW_SPST_B3U-1000P
SW_SETUP1: SETUP; SW_SPST_B3U-1000P
TP_3V3: V3V3_RAIL; TestPoint_Pad_D1.5mm
TP_5V1: V5_RAIL; TestPoint_Pad_D1.5mm
TP_12V_SW1: V12_SW; TestPoint_Pad_D1.5mm
TP_FLT1: nFLT; TestPoint_Pad_D1.5mm
TP_GND1: GND; TestPoint_Pad_D1.5mm
TP_IMON1: IMON; TestPoint_Pad_D1.5mm
TP_ISO5V1: ISO_5V; TestPoint_Pad_D1.5mm
TP_ISOGND1: ISO_GND; TestPoint_Pad_D1.5mm
TP_LORABOOT1: LORA_BOOT0; TestPoint_Pad_D1.5mm
TP_LORARST1: LORA_RESET; TestPoint_Pad_D1.5mm
TP_PG1: nPWRGD; TestPoint_Pad_D1.5mm
TP_RS485DI1: ISO_DI; TestPoint_Pad_D1.5mm
TP_RS485RO1: ISO_RO; TestPoint_Pad_D1.5mm
TP_USBVBUS1: USB_VBUS; TestPoint_Pad_D1.5mm
TP_VALVE_PWR1: V12_VALVE; TestPoint_Pad_D1.5mm
U1: TPS26600PWP; HTSSOP-16-1EP_4.4x5mm_P0.65mm_EP3.4x5mm_Mask2.66x2.46mm_The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
U2: TPS54561; WSON-10-1EP_4x4mm_P0.8mm_EP2.6x3mm_ThermalVias
U3: TPS563201; SOT-23-6
U_DRV1, U_DRV2, U_DRV3, U_DRV4, U_DRV5, U_DRV6: DRV8871DDAR; TI_SO-PowerPAD-8_ThermalVias
U_ISO1: ISO7761DW; SOIC-16W_7.5x10.3mm_P1.27mm
U_ISODCDC1: MEE1S0505SC; Converter_DCDC_Murata_MEE1SxxxxSC_THT
U_LORA1: RAK3172-xx-8-SM-xI; RAK3172
U_MCU1: ESP32-S3-WROOM-1-N16R8; ESP32-S3-WROOM-1
U_RS485_TX1: THVD1450DR; SOIC-8_3.9x4.9mm_P1.27mm
U_VALVEEXP1: MCP23S17-E/SO; SOIC-28W_7.5x17.9mm_P1.27mm

Connections:
DC_IN_RAW_N: J1.2, Q1.3 (D)
DC_IN_RAW_P: F1.1, J1.1
GND: C_BULK2.2, C_COMP1.2, C_DEC1.2, C_DEC2.2, C_DEC3.2, C_DEC4.2, C_DEC5.2, C_DEC6.2, C_DEC7.2, C_DEC8.2, C_DEC9.2, C_DEC10.2, C_DVDT1.2, C_EN1.2, C_FILT1.2, C_FILT2.2, C_FILT3.2, C_FILT4.2, C_FILT5.2, C_FILT6.2, C_IN1.2, C_IN2.2, C_IN3.2, C_ISOIN1.2, C_OUT1.2, C_OUT2.2, C_OUT3.2, C_SS1.2, C_VALVEBULK1.2, C_VMDEC1.2, C_VMDEC2.2, C_VMDEC3.2, C_VMDEC4.2, C_VMDEC5.2, C_VMDEC6.2, D1.2 (A2), D_CLLO1.2 (A), D_CLLO2.2 (A), D_CLLO3.2 (A), D_CLLO4.2 (A), D_CLLO5.2 (A), D_CLLO6.2 (A), D_FLT1.1 (K), D_LINK1.1 (K), D_PWR1.1 (K), J1.3, JP_IGND1.2, JP_IGND2.2, JP_IGND3.2, JP_IGND4.2, JP_IGND5.2, JP_IGND6.2, J_LORASMA1.2 (Ext), J_OUT1.2, J_OUT1.3, J_PROG1.3, J_SENSOR_RET1.1, J_SENSOR_RET1.2, J_SENSOR_RET1.3, J_SENSOR_RET1.4, J_SENSOR_RET1.5, J_SENSOR_RET1.6, J_USB1.A1 (GND), J_USB1.A12 (GND), J_USB1.B1 (GND), J_USB1.B12 (GND), J_USB1.SH (SHIELD), Q1.2 (S), R_CC1_1.2, R_CC2_1.2, R_EN1B1.2, R_FB1B1.2, R_FB2B1.2, R_ILIM1.2, R_ILIM_V1.2, R_ILIM_V2.2, R_ILIM_V3.2, R_ILIM_V4.2, R_ILIM_V5.2, R_ILIM_V6.2, R_IMON1.2, R_LED2.2, R_LORABOOT1.2, R_OVP2.2, R_RT1.2, R_UVLO2.2, R_VBOT1.2, R_VBOT2.2, R_VBOT3.2, R_VBOT4.2, R_VBOT5.2, R_VBOT6.2, SW_BOOT1.2, SW_RESET1.2, SW_SETUP1.2, TP_GND1.1, U1.6 (MODE), U1.8 (RTN), U1.9 (GND), U1.17 (RTN), U2.8 (GND), U2.11 (GND), U3.1 (GND), U_DRV1.1 (GND), U_DRV1.7 (GND), U_DRV1.9 (GND), U_DRV2.1 (GND), U_DRV2.7 (GND), U_DRV2.9 (GND), U_DRV3.1 (GND), U_DRV3.7 (GND), U_DRV3.9 (GND), U_DRV4.1 (GND), U_DRV4.7 (GND), U_DRV4.9 (GND), U_DRV5.1 (GND), U_DRV5.7 (GND), U_DRV5.9 (GND), U_DRV6.1 (GND), U_DRV6.7 (GND), U_DRV6.9 (GND), U_ISO1.4 (INC), U_ISO1.5 (IND), U_ISO1.6 (INE), U_ISO1.8 (GND1), U_ISODCDC1.1 (-Vin), U_LORA1.11 (GND), U_LORA1.17 (GND), U_LORA1.18 (GND), U_LORA1.23 (GND), U_LORA1.28 (GND), U_MCU1.1 (GND), U_MCU1.40 (GND), U_MCU1.41 (GND), U_VALVEEXP1.10 (V_{SS}), U_VALVEEXP1.15 (A0), U_VALVEEXP1.16 (A1), U_VALVEEXP1.17 (A2)
LED_FAULT: R_LEDFLT1.1, U_MCU1.33 (IO40)
LED_LINK: R_LINK1.1, U_MCU1.32 (IO39)
LED_PWR: R_PWR1.1, U_MCU1.31 (IO38)
LORA_UART_RX: U_LORA1.4 (PB6/UART1_TX), U_MCU1.11 (IO18)
LORA_UART_TX: U_LORA1.5 (PB7/UART1_RX), U_MCU1.10 (IO17)
RS485_DE: U_ISO1.3 (INB), U_MCU1.34 (IO41), U_MCU1.35 (IO42)
RS485_RX: U_ISO1.7 (OUTF), U_MCU1.9 (IO16)
RS485_TX: U_ISO1.2 (INA), U_MCU1.8 (IO15)
SENSOR_CH1: C_FILT1.1, D_CLHI1.2 (A), D_CLLO1.1 (K), JP_VBYP1.2, R_BURDEN1.1, R_SER1.2, R_VBOT1.1, U_MCU1.39 (IO1)
SENSOR_CH2: C_FILT2.1, D_CLHI2.2 (A), D_CLLO2.1 (K), JP_VBYP2.2, R_BURDEN2.1, R_SER2.2, R_VBOT2.1, U_MCU1.38 (IO2)
SENSOR_CH3: C_FILT3.1, D_CLHI3.2 (A), D_CLLO3.1 (K), JP_VBYP3.2, R_BURDEN3.1, R_SER3.2, R_VBOT3.1, U_MCU1.4 (IO4)
SENSOR_CH4: C_FILT4.1, D_CLHI4.2 (A), D_CLLO4.1 (K), JP_VBYP4.2, R_BURDEN4.1, R_SER4.2, R_VBOT4.1, U_MCU1.5 (IO5)
SENSOR_CH5: C_FILT5.1, D_CLHI5.2 (A), D_CLLO5.1 (K), JP_VBYP5.2, R_BURDEN5.1, R_SER5.2, R_VBOT5.1, U_MCU1.6 (IO6)
SENSOR_CH6: C_FILT6.1, D_CLHI6.2 (A), D_CLLO6.1 (K), JP_VBYP6.2, R_BURDEN6.1, R_SER6.2, R_VBOT6.1, U_MCU1.7 (IO7)
SETUP_BTN: R_SETUP1.2, SW_SETUP1.1, U_MCU1.22 (IO14)
V3V3_RAIL: C_BULK2.1, C_DEC1.1, C_DEC2.1, C_DEC3.1, C_DEC4.1, C_DEC5.1, C_DEC6.1, C_DEC7.1, C_DEC8.1, C_DEC9.1, C_DEC10.1, C_OUT3.1, D_CLHI1.1 (K), D_CLHI2.1 (K), D_CLHI3.1 (K), D_CLHI4.1 (K), D_CLHI5.1 (K), D_CLHI6.1 (K), D_LED2.1 (K), L2.2, R_BOOT1.1, R_ENPU1.1, R_EXPRST1.1, R_FB2A1.1, R_LORARST1.1, R_SETUP1.1, TP_3V3.1, U_ISO1.1 (Vcc1), U_LORA1.24 (VDD), U_MCU1.2 (3V3), U_VALVEEXP1.9 (V_{DD})
V5_RAIL: C_IN3.1, C_ISOIN1.1, C_OUT2.1, L1.2, R_EN2.1, R_FB1A1.1, R_FLT1.2, R_LED1.2, R_PG1.1, TP_5V1.1, U3.3 (VIN), U_ISODCDC1.2 (+Vin)
V12_PROT: C_IN1.1, D1.1 (A1), F1.2, F2.1, J_OUT1.1, R_OVP1.1, R_SHDN1.1, R_UVLO1.1, R_gate1.1, U1.1 (IN), U1.2 (IN)
V12_SW: C_IN2.1, C_OUT1.1, R_EN1A1.1, TP_12V_SW1.1, U1.15 (OUT), U1.16 (OUT), U2.2 (VIN)
V12_VALVE: C_VALVEBULK1.1, C_VMDEC1.1, C_VMDEC2.1, C_VMDEC3.1, C_VMDEC4.1, C_VMDEC5.1, C_VMDEC6.1, F2.2, TP_VALVE_PWR1.1, U_DRV1.5 (VM), U_DRV2.5 (VM), U_DRV3.5 (VM), U_DRV4.5 (VM), U_DRV5.5 (VM), U_DRV6.5 (VM)
VALVE_SPI_CS: U_MCU1.18 (IO10), U_VALVEEXP1.11 (~CS)
VALVE_SPI_MISO: U_MCU1.21 (IO13), U_VALVEEXP1.14 (SO)
VALVE_SPI_MOSI: U_MCU1.19 (IO11), U_VALVEEXP1.13 (SI)
VALVE_SPI_SCLK: U_MCU1.20 (IO12), U_VALVEEXP1.12 (SCK)
net_BOOT: R_BOOT1.2, SW_BOOT1.1, U_MCU1.27 (IO0)
net_BOOT1: C_BOOT1.1, U2.1 (BOOT)
net_BOOT2: C_BOOT2.1, U3.6 (VBST)
net_CC1: J_USB1.A5 (CC1), R_CC1_1.1
net_CC2: J_USB1.B5 (CC2), R_CC2_1.1
net_CH1_IGND: JP_IGND1.1, R_BURDEN1.2
net_CH1_SIG: JP_VBYP1.1, J_SENSOR_SIG1.1, R_SER1.1
net_CH2_IGND: JP_IGND2.1, R_BURDEN2.2
net_CH2_SIG: JP_VBYP2.1, J_SENSOR_SIG1.2, R_SER2.1
net_CH3_IGND: JP_IGND3.1, R_BURDEN3.2
net_CH3_SIG: JP_VBYP3.1, J_SENSOR_SIG1.3, R_SER3.1
net_CH4_IGND: JP_IGND4.1, R_BURDEN4.2
net_CH4_SIG: JP_VBYP4.1, J_SENSOR_SIG1.4, R_SER4.1
net_CH5_IGND: JP_IGND5.1, R_BURDEN5.2
net_CH5_SIG: JP_VBYP5.1, J_SENSOR_SIG1.5, R_SER5.1
net_CH6_IGND: JP_IGND6.1, R_BURDEN6.2
net_CH6_SIG: JP_VBYP6.1, J_SENSOR_SIG1.6, R_SER6.1
net_CHIP_EN: C_EN1.1, R_ENPU1.2, SW_RESET1.1, U_MCU1.3 (EN)
net_COMP1: R_COMP1.1, U2.7 (COMP)
net_COMPA: C_COMP1.1, R_COMP1.2
net_DEBUG_RX: J_PROG1.2, U_MCU1.36 (RXD0)
net_DEBUG_TX: J_PROG1.1, U_MCU1.37 (TXD0)
net_DVDT: C_DVDT1.1, U1.12 (dVdT)
net_EN1: R_EN1A1.2, R_EN1B1.1, U2.3 (EN)
net_EN2: R_EN2.2, U3.5 (EN)
net_EXP_RESET: R_EXPRST1.2, U_VALVEEXP1.18 (~RESET)
net_FB1MID: R_FB1A1.2, R_FB1B1.1, U2.6 (FB)
net_FB2MID: R_FB2A1.2, R_FB2B1.1, U3.4 (VFB)
net_FLT: R_FLT1.1, TP_FLT1.1, U1.14 (~FLT)
net_ILIM: R_ILIM1.1, U1.11 (ILIM)
net_IMON: R_IMON1.1, TP_IMON1.1, U1.10 (IMON)
net_IN_A_RAW: CMC_RS485_1.1, D_RS485PROT1.1 (A1), J_RS485_IN1.2
net_IN_B_RAW: CMC_RS485_1.3, D_RS485PROT1.2 (A2), J_RS485_IN1.3
net_ISO_5V: C_ISOOUT1.1, R_BIASA1.1, TP_ISO5V1.1, U_ISO1.16 (Vcc2), U_ISODCDC1.4 (+Vout), U_RS485_TX1.8 (VCC)
net_ISO_DI: TP_RS485DI1.1, U_ISO1.15 (OUTA), U_RS485_TX1.4 (DI)
net_ISO_DIR: U_ISO1.14 (OUTB), U_RS485_TX1.2 (~RE), U_RS485_TX1.3 (DE)
net_ISO_GND: C_ISOOUT1.2, D_RS485PROT1.3 (common), D_RS485PROT2.3 (common), J_RS485_IN1.1, J_RS485_IN1.5, J_RS485_LOC1.1, J_RS485_LOC1.5, J_RS485_OUT1.1, J_RS485_OUT1.5, R_BIASB1.2, TP_ISOGND1.1, U_ISO1.9 (GND2), U_ISODCDC1.3 (-Vout), U_RS485_TX1.5 (GND)
net_ISO_RO: TP_RS485RO1.1, U_ISO1.10 (INF), U_RS485_TX1.1 (RO)
net_LED1A: D_LED1.2 (A), R_LED1.1
net_LED2A: D_LED2.2 (A), R_LED2.1
net_LEDFLT_A: D_FLT1.2 (A), R_LEDFLT1.2
net_LEDLINK_A: D_LINK1.2 (A), R_LINK1.2
net_LEDPWR_A: D_PWR1.2 (A), R_PWR1.2
net_LOC_A_RAW: CMC_RS485_2.1, D_RS485PROT2.1 (A1), J_RS485_LOC1.2
net_LOC_B_RAW: CMC_RS485_2.3, D_RS485PROT2.2 (A2), J_RS485_LOC1.3
net_LORA_BOOT0: R_LORABOOT1.1, TP_LORABOOT1.1, U_LORA1.21 (BOOT0)
net_LORA_RF: J_LORASMA1.1 (In), U_LORA1.12 (RF)
net_LORA_RST: R_LORARST1.2, TP_LORARST1.1, U_LORA1.22 (~RST)
net_MAIN_A: CMC_RS485_1.2, CMC_RS485_2.2, J_RS485_OUT1.2, R_BIASA1.2, R_TERM1.1, U_RS485_TX1.6 (A)
net_MAIN_B: CMC_RS485_1.4, CMC_RS485_2.4, J_RS485_OUT1.3, R_BIASB1.1, R_TERM1.2, U_RS485_TX1.7 (B)
net_OVP: R_OVP1.2, R_OVP2.1, U1.5 (OVP)
net_PWRGD: D_LED1.1 (K), R_PG1.2, TP_PG1.1, U2.10 (PWRGD)
net_Q1G: Q1.1 (G), R_gate1.2
net_RT1: R_RT1.1, U2.5 (RT/CLK)
net_SHDN: R_SHDN1.2, U1.7 (~SHDN)
net_SS1: C_SS1.1, U2.4 (SS/TR)
net_SW1: C_BOOT1.2, L1.1, U2.9 (SW)
net_SW2: C_BOOT2.2, L2.1, U3.2 (SW)
net_USB_DM: J_USB1.A7 (D-), J_USB1.B7 (D-), U_MCU1.13 (USB_D-)
net_USB_DP: J_USB1.A6 (D+), J_USB1.B6 (D+), U_MCU1.14 (USB_D+)
net_USB_VBUS: J_USB1.A4 (VBUS), J_USB1.A9 (VBUS), J_USB1.B4 (VBUS), J_USB1.B9 (VBUS), TP_USBVBUS1.1
net_UVLO: R_UVLO1.2, R_UVLO2.1, U1.3 (UVLO)
net_V1_ILIM: R_ILIM_V1.1, U_DRV1.4 (ILIM)
net_V1_IN1: U_DRV1.3 (IN1), U_VALVEEXP1.21 (GPA0)
net_V1_IN2: U_DRV1.2 (IN2), U_VALVEEXP1.22 (GPA1)
net_V1_OUT1: J_VALVE_OUT1_1.1, U_DRV1.6 (OUT1)
net_V1_OUT2: J_VALVE_OUT2_1.1, U_DRV1.8 (OUT2)
net_V2_ILIM: R_ILIM_V2.1, U_DRV2.4 (ILIM)
net_V2_IN1: U_DRV2.3 (IN1), U_VALVEEXP1.23 (GPA2)
net_V2_IN2: U_DRV2.2 (IN2), U_VALVEEXP1.24 (GPA3)
net_V2_OUT1: J_VALVE_OUT1_1.2, U_DRV2.6 (OUT1)
net_V2_OUT2: J_VALVE_OUT2_1.2, U_DRV2.8 (OUT2)
net_V3_ILIM: R_ILIM_V3.1, U_DRV3.4 (ILIM)
net_V3_IN1: U_DRV3.3 (IN1), U_VALVEEXP1.25 (GPA4)
net_V3_IN2: U_DRV3.2 (IN2), U_VALVEEXP1.26 (GPA5)
net_V3_OUT1: J_VALVE_OUT1_1.3, U_DRV3.6 (OUT1)
net_V3_OUT2: J_VALVE_OUT2_1.3, U_DRV3.8 (OUT2)
net_V4_ILIM: R_ILIM_V4.1, U_DRV4.4 (ILIM)
net_V4_IN1: U_DRV4.3 (IN1), U_VALVEEXP1.27 (GPA6)
net_V4_IN2: U_DRV4.2 (IN2), U_VALVEEXP1.28 (GPA7)
net_V4_OUT1: J_VALVE_OUT1_1.4, U_DRV4.6 (OUT1)
net_V4_OUT2: J_VALVE_OUT2_1.4, U_DRV4.8 (OUT2)
net_V5_ILIM: R_ILIM_V5.1, U_DRV5.4 (ILIM)
net_V5_IN1: U_DRV5.3 (IN1), U_VALVEEXP1.1 (GPB0)
net_V5_IN2: U_DRV5.2 (IN2), U_VALVEEXP1.2 (GPB1)
net_V5_OUT1: J_VALVE_OUT1_1.5, U_DRV5.6 (OUT1)
net_V5_OUT2: J_VALVE_OUT2_1.5, U_DRV5.8 (OUT2)
net_V6_ILIM: R_ILIM_V6.1, U_DRV6.4 (ILIM)
net_V6_IN1: U_DRV6.3 (IN1), U_VALVEEXP1.3 (GPB2)
net_V6_IN2: U_DRV6.2 (IN2), U_VALVEEXP1.4 (GPB3)
net_V6_OUT1: J_VALVE_OUT1_1.6, U_DRV6.6 (OUT1)
net_V6_OUT2: J_VALVE_OUT2_1.6, U_DRV6.8 (OUT2)
