praveen034u/SWAFarm/Hardware/SWAFarmNodeV1/Sensors & LORA.kicad_sch

## KiCad design Hardware/SWAFarmNodeV1/Sensors & LORA.kicad_sch (2026-08-05)

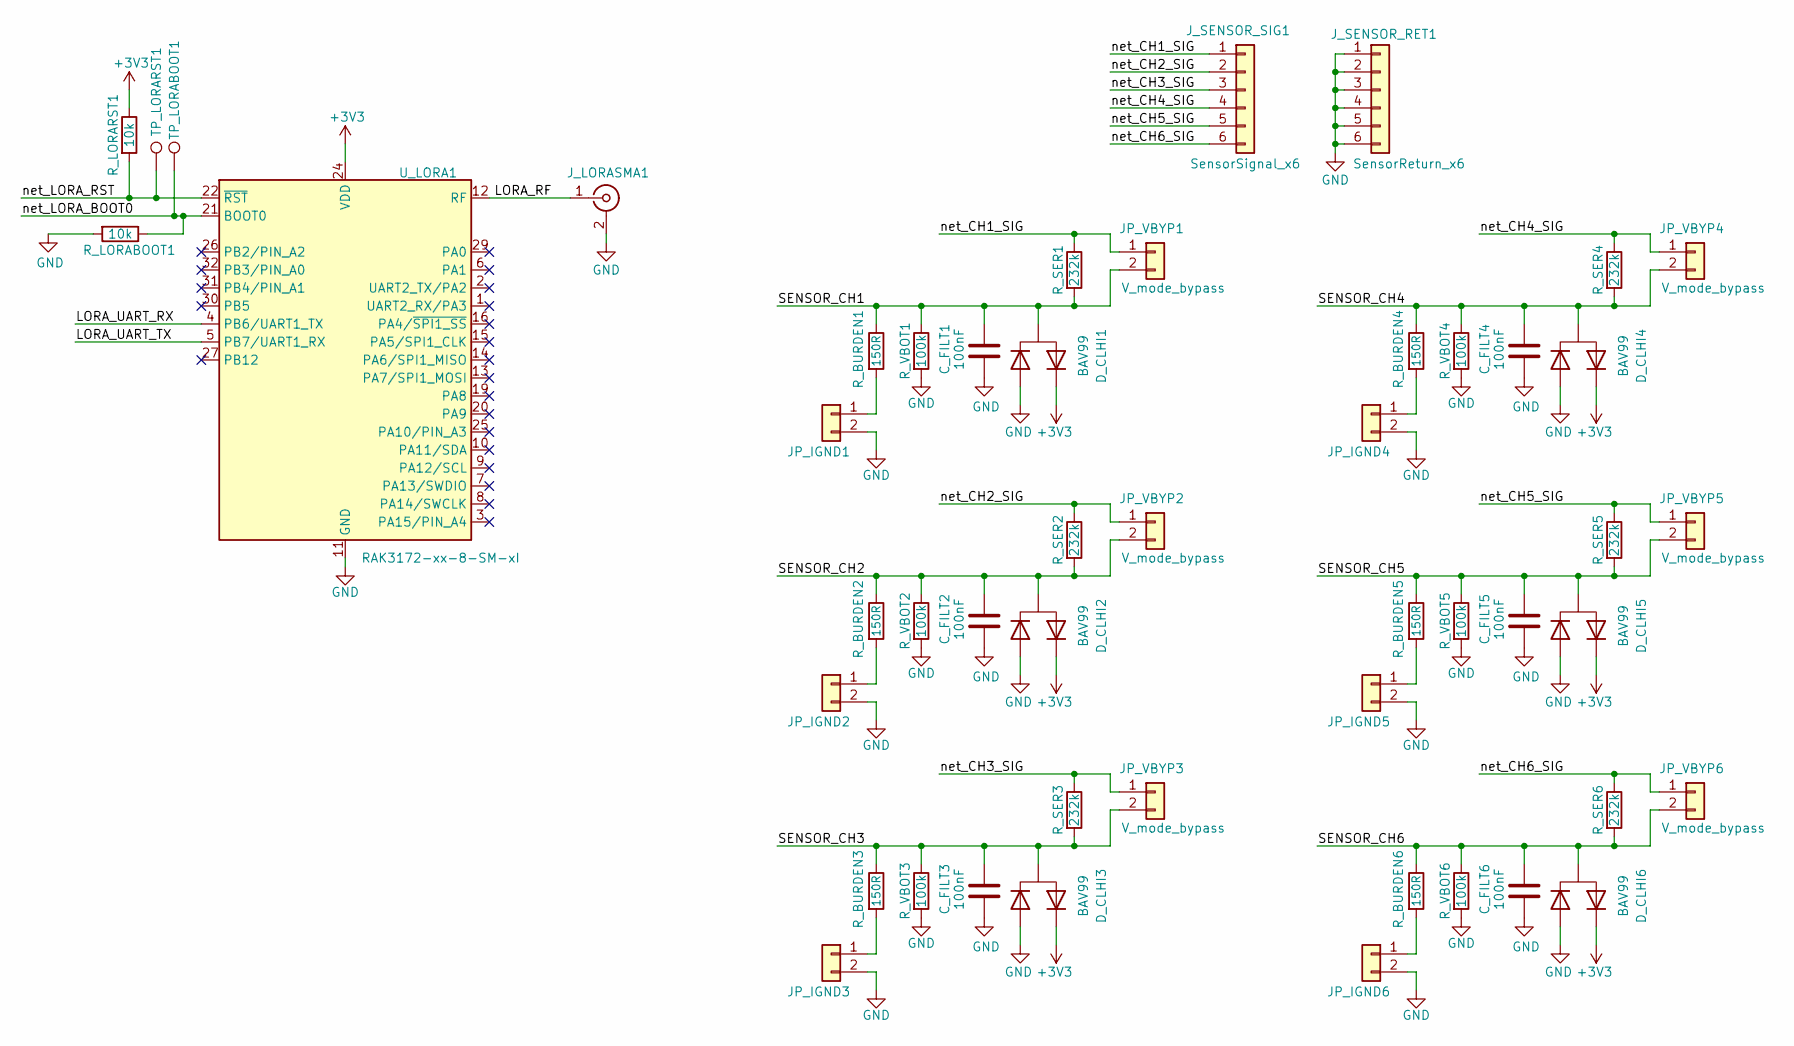
[picture p20: schematic Sensors & LORA.kicad_sch]

Parts:
C_FILT1, C_FILT2, C_FILT3, C_FILT4, C_FILT5, C_FILT6: 100nF; C_0603_1608Metric
D_CLHI1, D_CLHI2, D_CLHI3, D_CLHI4, D_CLHI5, D_CLHI6: BAV99; D_SOD-123
JP_IGND1, JP_IGND2, JP_IGND3, JP_IGND4, JP_IGND5, JP_IGND6: I_mode_gnd; PinHeader_1x02_P2.54mm_Vertical
JP_VBYP1, JP_VBYP2, JP_VBYP3, JP_VBYP4, JP_VBYP5, JP_VBYP6: V_mode_bypass; PinHeader_1x02_P2.54mm_Vertical
J_LORASMA1: SMA_Bulkhead_Antenna; SMA_Amphenol_132134_Vertical
J_SENSOR_RET1: SensorReturn_x6; TerminalBlock_Phoenix_MKDS-1,5-6-5.08_1x06_P5.08mm_Horizont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
J_SENSOR_SIG1: SensorSignal_x6; TerminalBlock_Phoenix_MKDS-1,5-6-5.08_1x06_P5.08mm_Horizont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
R_BURDEN1, R_BURDEN2, R_BURDEN3, R_BURDEN4, R_BURDEN5, R_BURDEN6: 150R; R_0805_2012Metric
R_LORABOOT1: 10k; R_0805_2012Metric
R_LORARST1: 10k; R_0805_2012Metric
R_SER1, R_SER2, R_SER3, R_SER4, R_SER5, R_SER6: 232k; R_0805_2012Metric
R_VBOT1, R_VBOT2, R_VBOT3, R_VBOT4, R_VBOT5, R_VBOT6: 100k; R_0805_2012Metric
TP_LORABOOT1: LORA_BOOT0; TestPoint_Pad_D1.5mm
TP_LORARST1: LORA_RESET; TestPoint_Pad_D1.5mm
U_LORA1: RAK3172-xx-8-SM-xI; RAK3172

Connections:
+3V3: D_CLHI1.2 (A), D_CLHI2.2 (A), D_CLHI3.2 (A), D_CLHI4.2 (A), D_CLHI5.2 (A), D_CLHI6.2 (A), R_LORARST1.1, U_LORA1.24 (VDD)
GND: C_FILT1.2, C_FILT2.2, C_FILT3.2, C_FILT4.2, C_FILT5.2, C_FILT6.2, D_CLHI1.1 (K), D_CLHI2.1 (K), D_CLHI3.1 (K), D_CLHI4.1 (K), D_CLHI5.1 (K), D_CLHI6.1 (K), JP_IGND1.2, JP_IGND2.2, JP_IGND3.2, JP_IGND4.2, JP_IGND5.2, JP_IGND6.2, J_LORASMA1.2 (Ext), J_SENSOR_RET1.1, J_SENSOR_RET1.2, J_SENSOR_RET1.3, J_SENSOR_RET1.4, J_SENSOR_RET1.5, J_SENSOR_RET1.6, R_LORABOOT1.2, R_VBOT1.2, R_VBOT2.2, R_VBOT3.2, R_VBOT4.2, R_VBOT5.2, R_VBOT6.2, U_LORA1.11 (GND), U_LORA1.17 (GND), U_LORA1.18 (GND), U_LORA1.23 (GND), U_LORA1.28 (GND)
LORA_RF: J_LORASMA1.1 (In), U_LORA1.12 (RF)
LORA_UART_RX: U_LORA1.4 (PB6/UART1_TX)
LORA_UART_TX: U_LORA1.5 (PB7/UART1_RX)
unnamed: JP_IGND1.1, R_BURDEN1.2
unnamed: JP_IGND2.1, R_BURDEN2.2
unnamed: JP_IGND3.1, R_BURDEN3.2
unnamed: JP_IGND4.1, R_BURDEN4.2
unnamed: JP_IGND5.1, R_BURDEN5.2
unnamed: JP_IGND6.1, R_BURDEN6.2
SENSOR_CH1: C_FILT1.1, D_CLHI1.3 (A/K), JP_VBYP1.2, R_BURDEN1.1, R_SER1.2, R_VBOT1.1
SENSOR_CH2: C_FILT2.1, D_CLHI2.3 (A/K), JP_VBYP2.2, R_BURDEN2.1, R_SER2.2, R_VBOT2.1
SENSOR_CH3: C_FILT3.1, D_CLHI3.3 (A/K), JP_VBYP3.2, R_BURDEN3.1, R_SER3.2, R_VBOT3.1
SENSOR_CH4: C_FILT4.1, D_CLHI4.3 (A/K), JP_VBYP4.2, R_BURDEN4.1, R_SER4.2, R_VBOT4.1
SENSOR_CH5: C_FILT5.1, D_CLHI5.3 (A/K), JP_VBYP5.2, R_BURDEN5.1, R_SER5.2, R_VBOT5.1
SENSOR_CH6: C_FILT6.1, D_CLHI6.3 (A/K), JP_VBYP6.2, R_BURDEN6.1, R_SER6.2, R_VBOT6.1
net_CH1_SIG: JP_VBYP1.1, J_SENSOR_SIG1.1, R_SER1.1
net_CH2_SIG: JP_VBYP2.1, J_SENSOR_SIG1.2, R_SER2.1
net_CH3_SIG: JP_VBYP3.1, J_SENSOR_SIG1.3, R_SER3.1
net_CH4_SIG: JP_VBYP4.1, J_SENSOR_SIG1.4, R_SER4.1
net_CH5_SIG: JP_VBYP5.1, J_SENSOR_SIG1.5, R_SER5.1
net_CH6_SIG: JP_VBYP6.1, J_SENSOR_SIG1.6, R_SER6.1
net_LORA_BOOT0: R_LORABOOT1.1, TP_LORABOOT1.1, U_LORA1.21 (BOOT0)
net_LORA_RST: R_LORARST1.2, TP_LORARST1.1, U_LORA1.22 (~RST)
