praveen034u/SWAFarm/(commit log)

2026-07-31 updated upto step 9 - PCB Floor Planning & Component Placement
    [SWAFarmNodeV1.kicad_pcb, SWAFarmNodeV1.kicad_sch]
2026-08-01 uodated with Murli BOM
    [NodeForRefrence.csv, SWAFarmNodeV1.kicad_pcb, SWAFarmNodeV1.kicad_sch]
2026-08-03 Schematics Clean up phase-1 completed
    [SWAFarmNodeV1.kicad_sch]
2026-08-05 Schematics Clean up Phase-2 Completed
    [SWAFarmNodeV1.kicad_sch]
2026-08-05 Schematics Cleanup Done
    [MCU.kicad_sch, Motor Valve.kicad_sch, Power.kicad_sch, RS-485.kicad_sch, SWAFarmNodeV1.kicad_sch, Sensors & LORA.kicad_sch, untitled.kicad_sch]
2026-08-08 Untitled Removed
    [untitled.kicad_sch]
